thegm-Gabriel/instrumentacao-ElectricCarUFSM/hardware/kicad/README.md

# Projetos KiCad

Pasta reservada para esquemas elétricos, placas e bibliotecas locais do KiCad.
