thegm-Gabriel/instrumentacao-ElectricCarUFSM/hardware/folhas-de-dados/README.md

# Folhas de dados

Pasta reservada para folhas de dados dos componentes usados na instrumentação.
Registre a origem e a revisão de cada documento ao adicioná-lo.
