thegm-Gabriel/instrumentacao-ElectricCarUFSM/firmware/compartilhado/telemetria/README.md

# Telemetria compartilhada

`dados_telemetria_veiculo.h` descreve os dados da aplicação em unidades de engenharia.
O serviço do mestre converte esses valores para o formato binário compacto definido
em `protocolos`.
