thegm-Gabriel/instrumentacao-ElectricCarUFSM/firmware/compartilhado/comum/README.md

# Código comum

Espaço reservado para utilitários pequenos e independentes do hardware. Uma função só
deve ser movida para cá quando for realmente usada por mais de um firmware.
