thegm-Gabriel/instrumentacao-ElectricCarUFSM/.tmp_video_review/chrome_frame.png

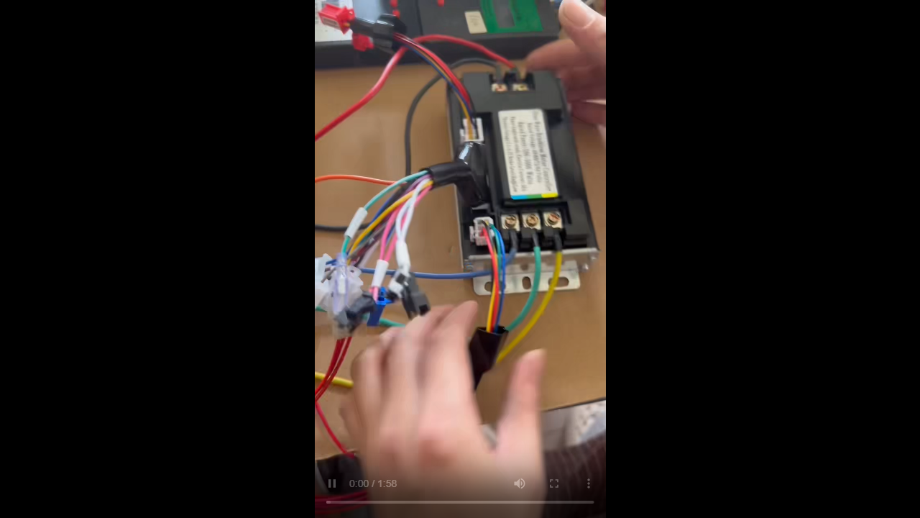
.tmp_video_review/chrome_frame.png
