thegm-Gabriel/instrumentacao-ElectricCarUFSM/.tmp_video_review/f_000.jpg

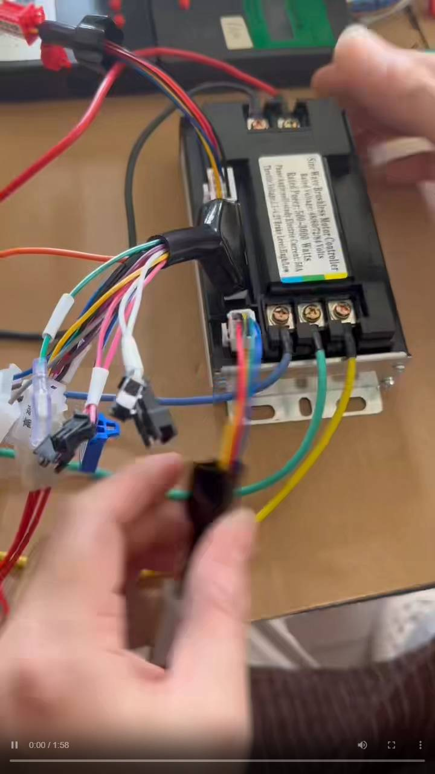
.tmp_video_review/f_000.jpg
