thegm-Gabriel/instrumentacao-ElectricCarUFSM/.tmp_video_review/f_002.jpg

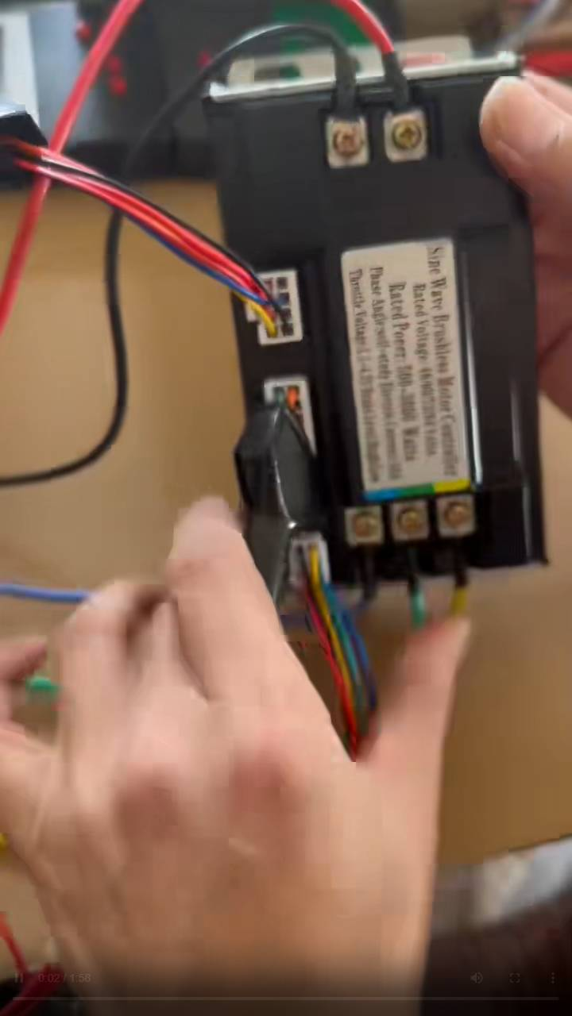
.tmp_video_review/f_002.jpg
