thegm-Gabriel/instrumentacao-ElectricCarUFSM/.tmp_video_review/f_004.jpg

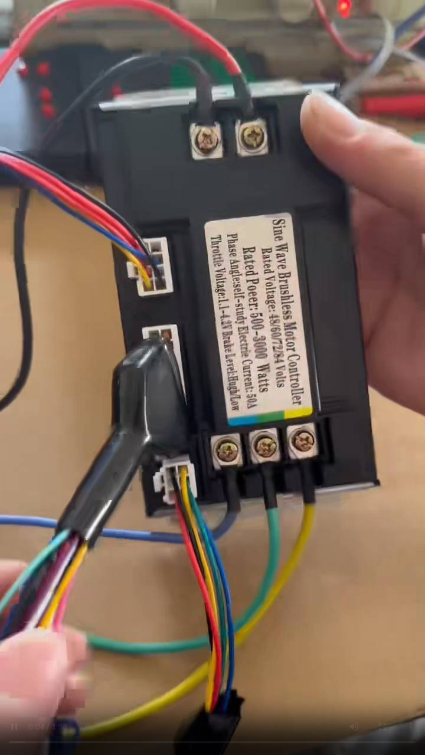
.tmp_video_review/f_004.jpg
