thegm-Gabriel/instrumentacao-ElectricCarUFSM/.tmp_video_review/f_006.jpg

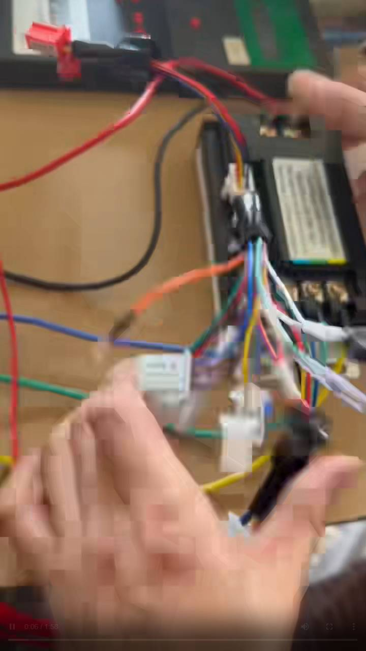
.tmp_video_review/f_006.jpg
