thegm-Gabriel/instrumentacao-ElectricCarUFSM/.tmp_video_review/f_008.jpg

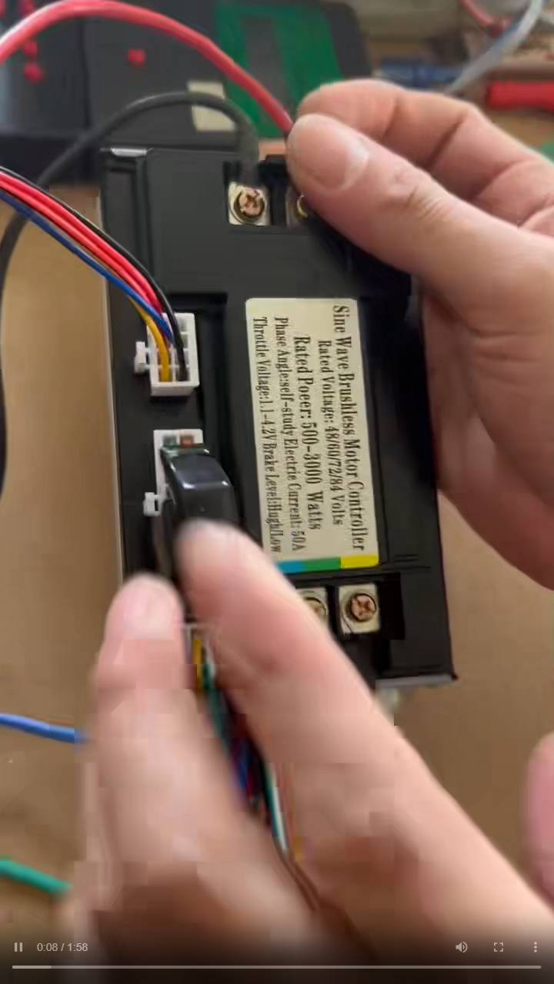
.tmp_video_review/f_008.jpg
