thegm-Gabriel/instrumentacao-ElectricCarUFSM/.tmp_video_review/f_010.jpg

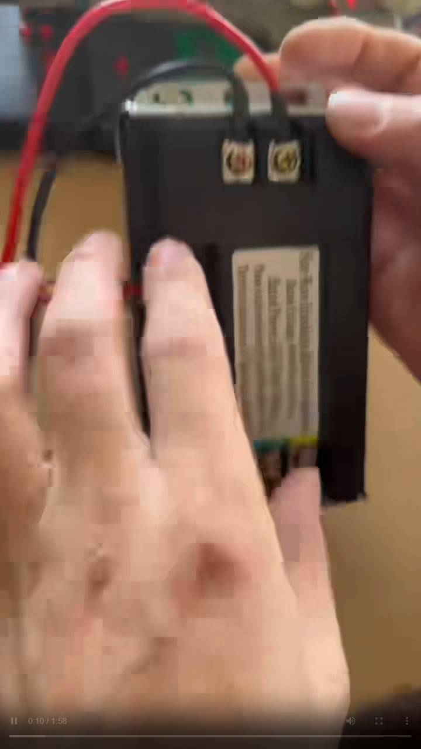
.tmp_video_review/f_010.jpg
