thegm-Gabriel/instrumentacao-ElectricCarUFSM/.tmp_video_review/f_012.jpg

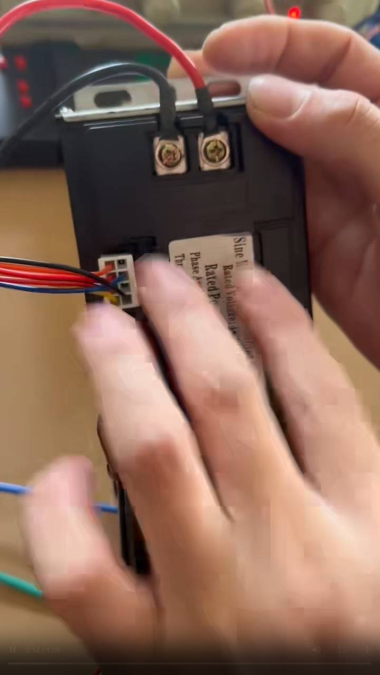
.tmp_video_review/f_012.jpg
