thegm-Gabriel/instrumentacao-ElectricCarUFSM/.tmp_video_review/f_014.jpg

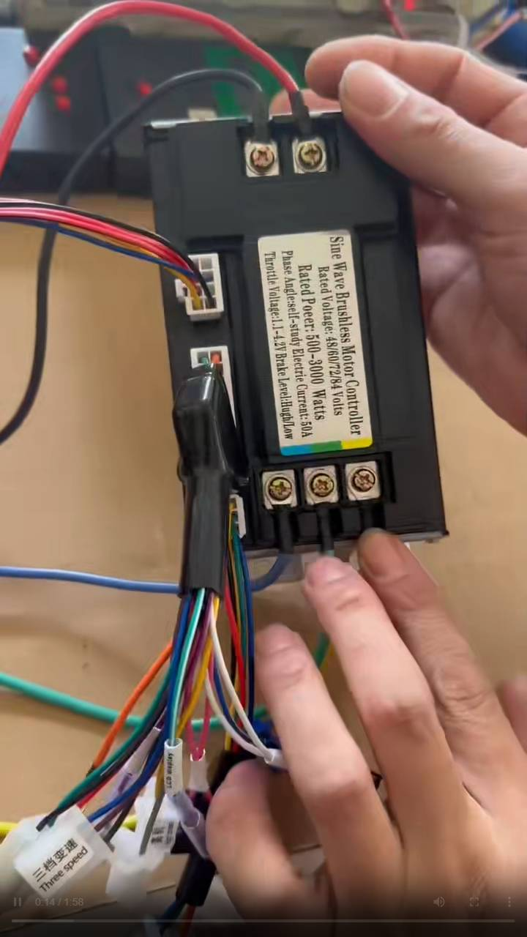
.tmp_video_review/f_014.jpg
