thegm-Gabriel/instrumentacao-ElectricCarUFSM/.tmp_video_review/f_016.jpg

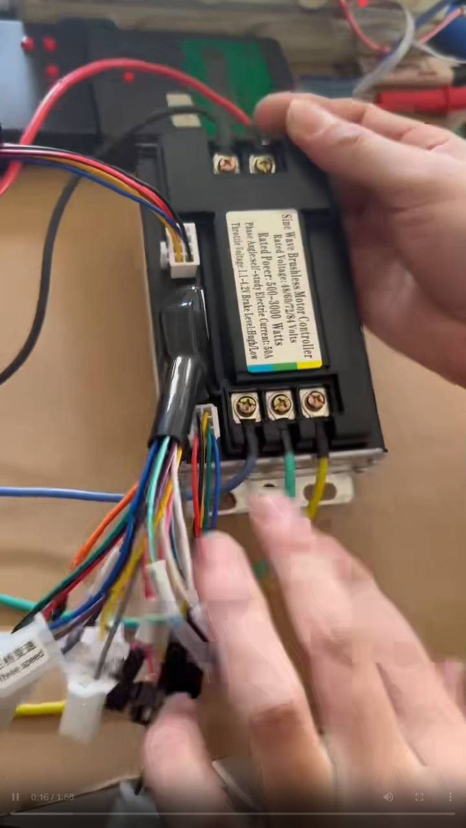
.tmp_video_review/f_016.jpg
