thegm-Gabriel/instrumentacao-ElectricCarUFSM/.tmp_video_review/f_018.jpg

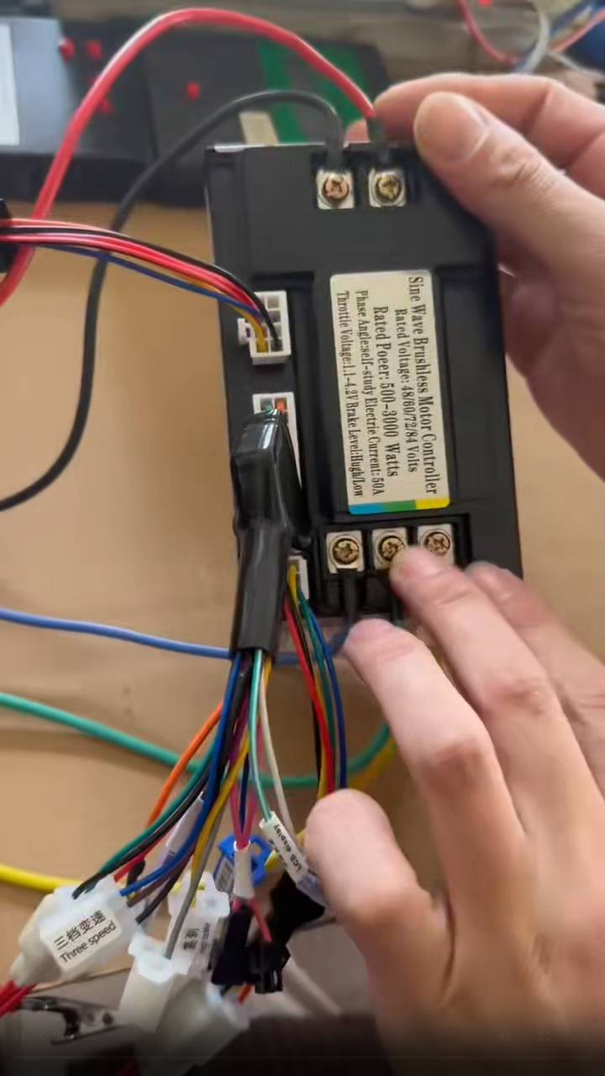
.tmp_video_review/f_018.jpg
