thegm-Gabriel/instrumentacao-ElectricCarUFSM/.tmp_video_review/f_020.jpg

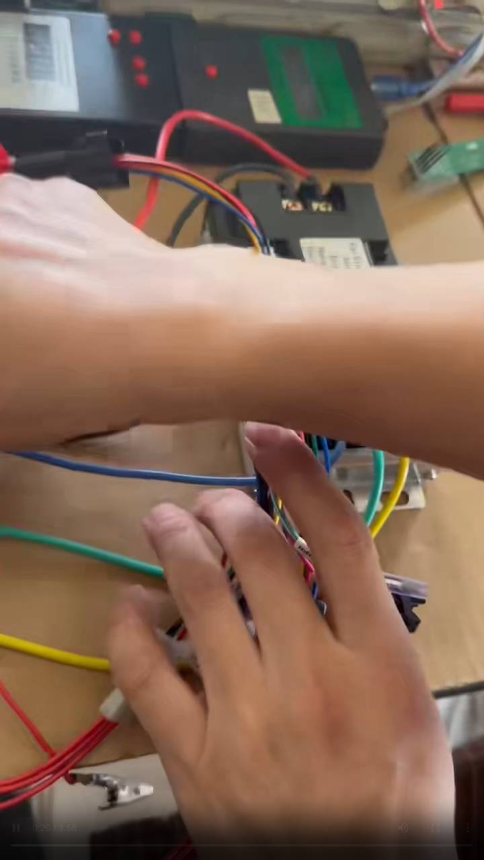
.tmp_video_review/f_020.jpg
