thegm-Gabriel/instrumentacao-ElectricCarUFSM/.tmp_video_review/f_022.jpg

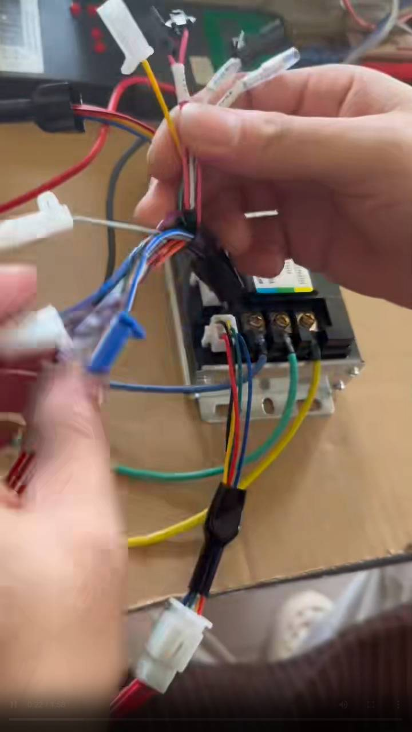
.tmp_video_review/f_022.jpg
