thegm-Gabriel/instrumentacao-ElectricCarUFSM/.tmp_video_review/f_024.jpg

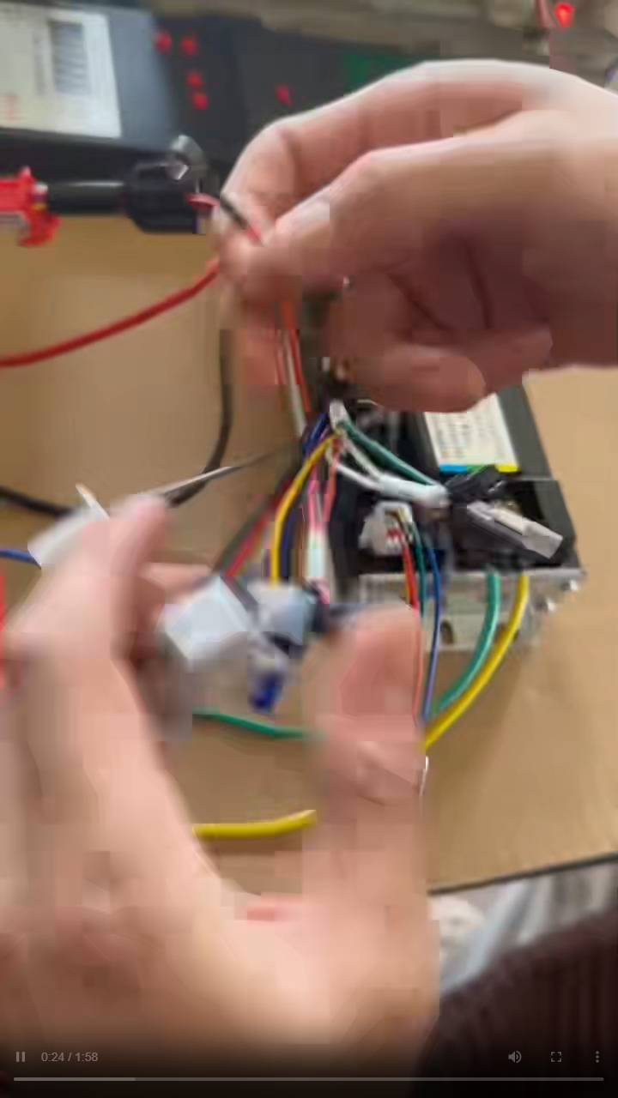
.tmp_video_review/f_024.jpg
