thegm-Gabriel/instrumentacao-ElectricCarUFSM/.tmp_video_review/f_026.jpg

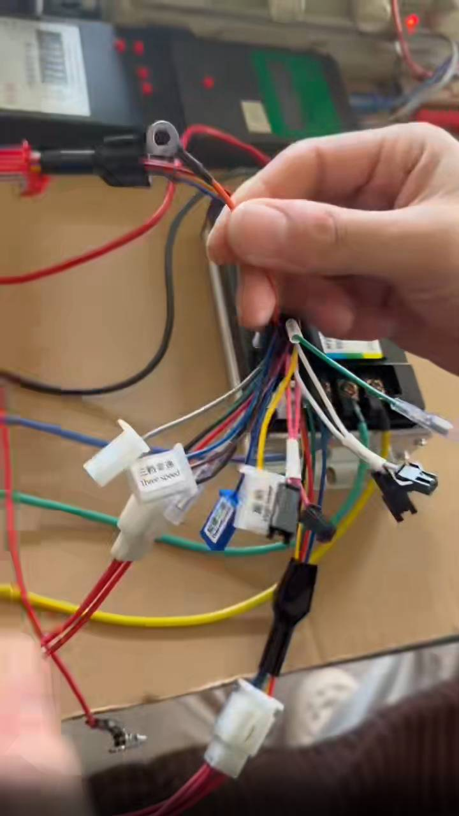
.tmp_video_review/f_026.jpg
