thegm-Gabriel/instrumentacao-ElectricCarUFSM/.tmp_video_review/f_028.jpg

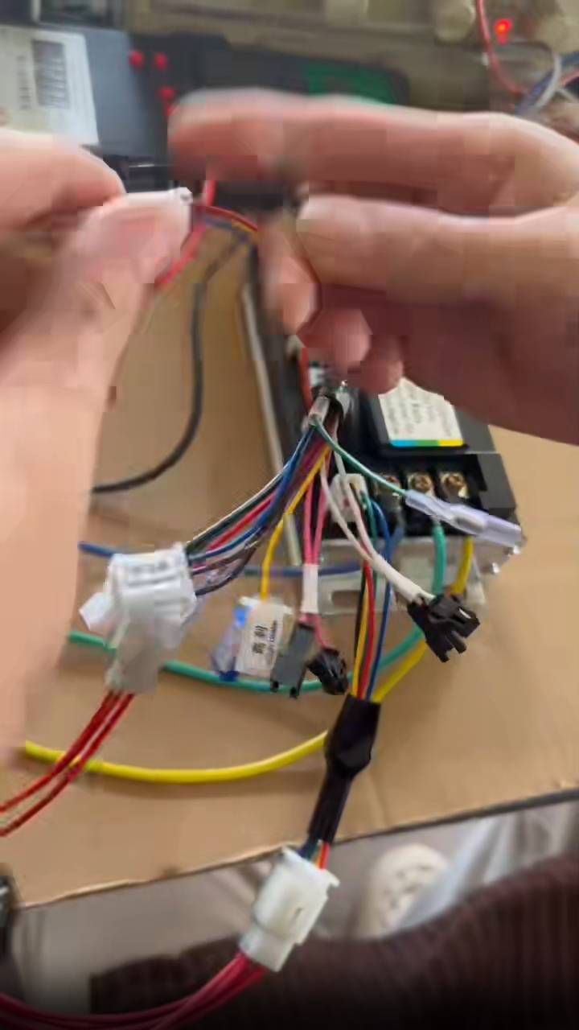
.tmp_video_review/f_028.jpg
