thegm-Gabriel/instrumentacao-ElectricCarUFSM/.tmp_video_review/f_030.jpg

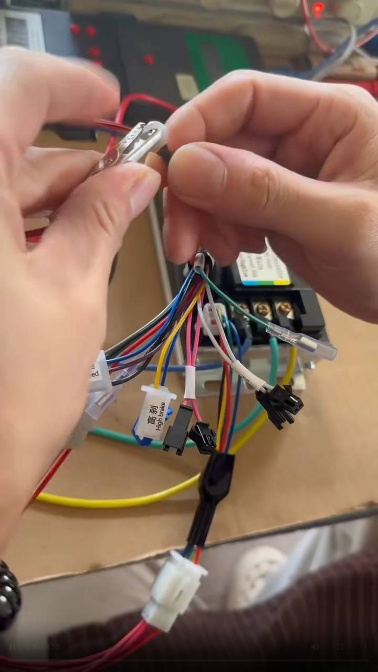
.tmp_video_review/f_030.jpg
