thegm-Gabriel/instrumentacao-ElectricCarUFSM/.tmp_video_review/f_032.jpg

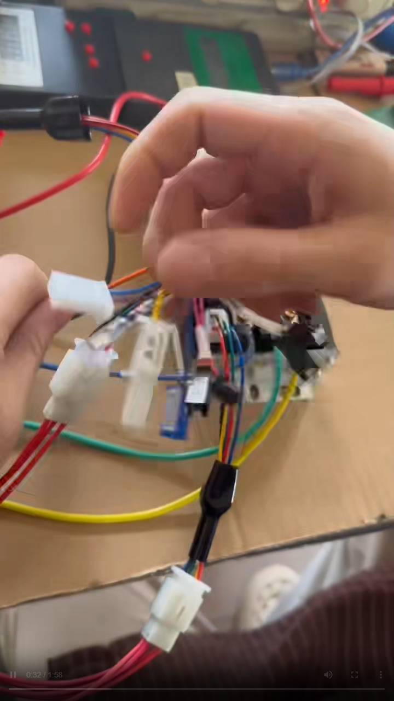
.tmp_video_review/f_032.jpg
