thegm-Gabriel/instrumentacao-ElectricCarUFSM/.tmp_video_review/f_034.jpg

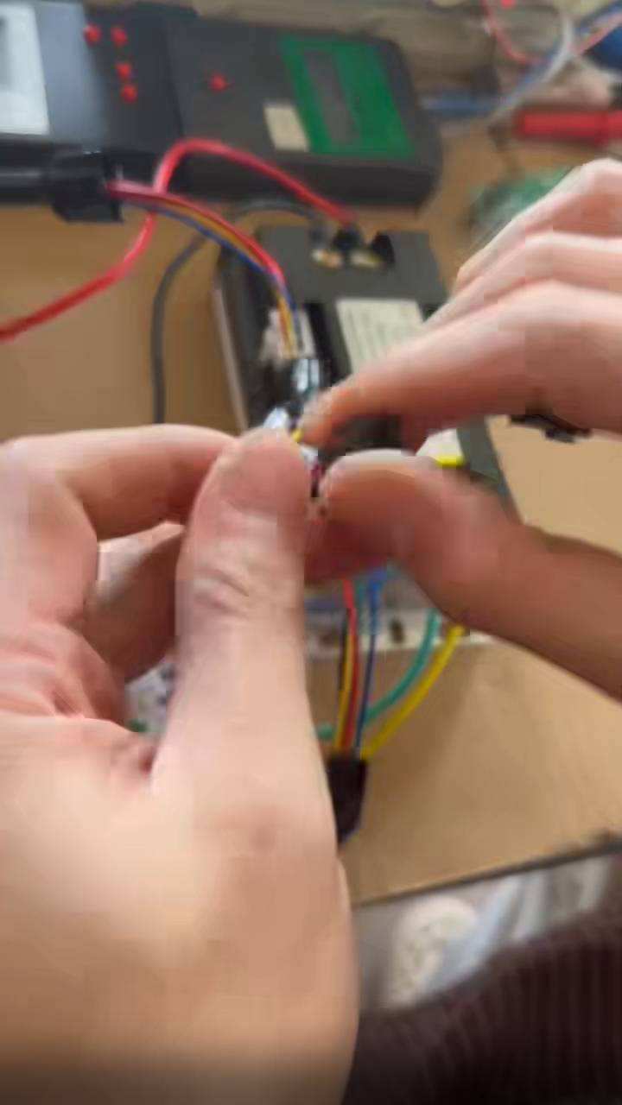
.tmp_video_review/f_034.jpg
