thegm-Gabriel/instrumentacao-ElectricCarUFSM/.tmp_video_review/f_036.jpg

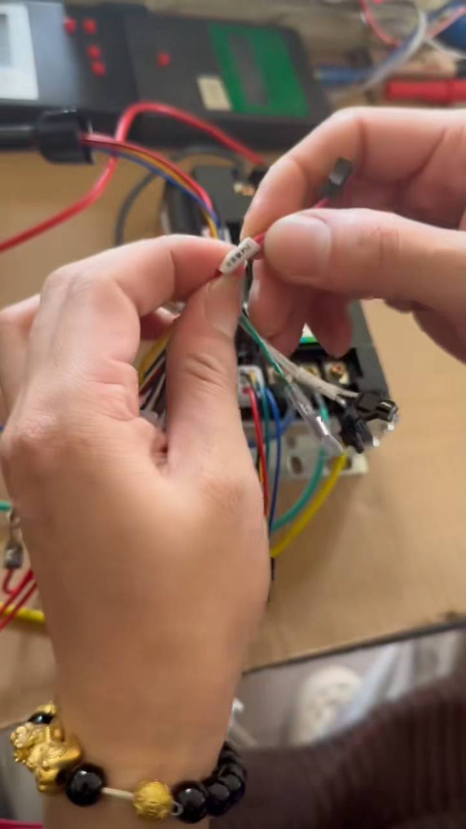
.tmp_video_review/f_036.jpg
