thegm-Gabriel/instrumentacao-ElectricCarUFSM/.tmp_video_review/f_038.jpg

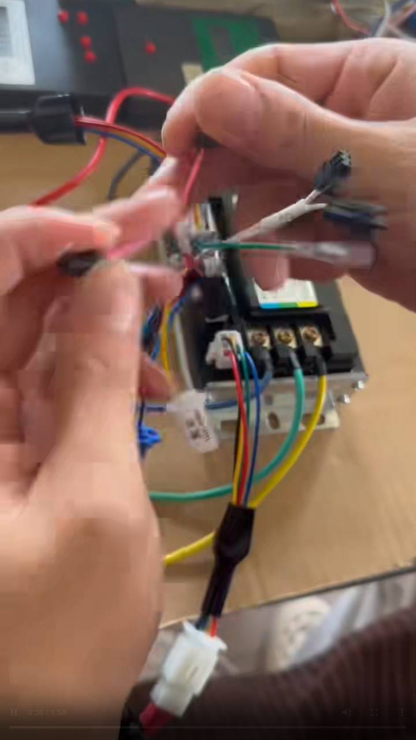
.tmp_video_review/f_038.jpg
