thegm-Gabriel/instrumentacao-ElectricCarUFSM/.tmp_video_review/f_040.jpg

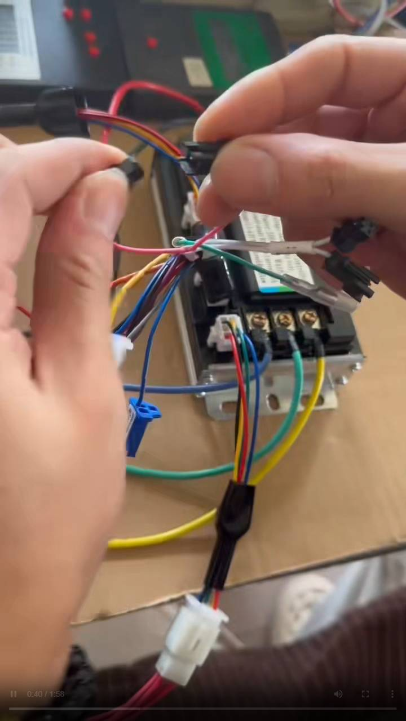
.tmp_video_review/f_040.jpg
