thegm-Gabriel/instrumentacao-ElectricCarUFSM/.tmp_video_review/f_042.jpg

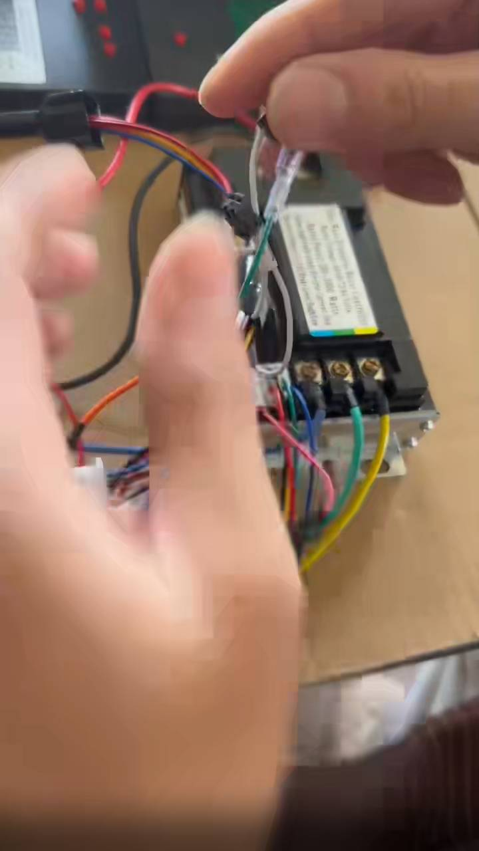
.tmp_video_review/f_042.jpg
