thegm-Gabriel/instrumentacao-ElectricCarUFSM/.tmp_video_review/f_044.jpg

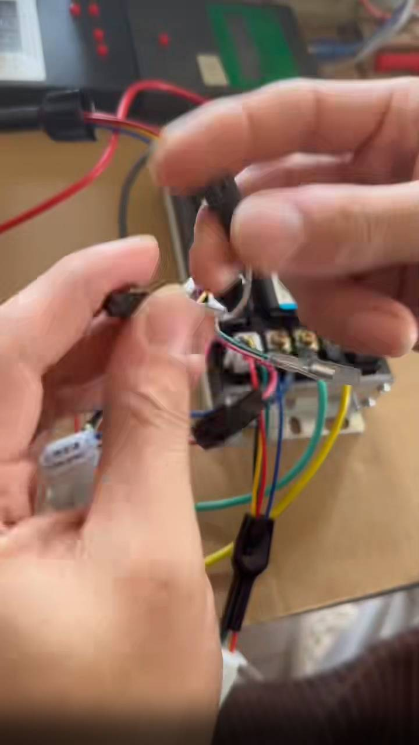
.tmp_video_review/f_044.jpg
