thegm-Gabriel/instrumentacao-ElectricCarUFSM/.tmp_video_review/f_046.jpg

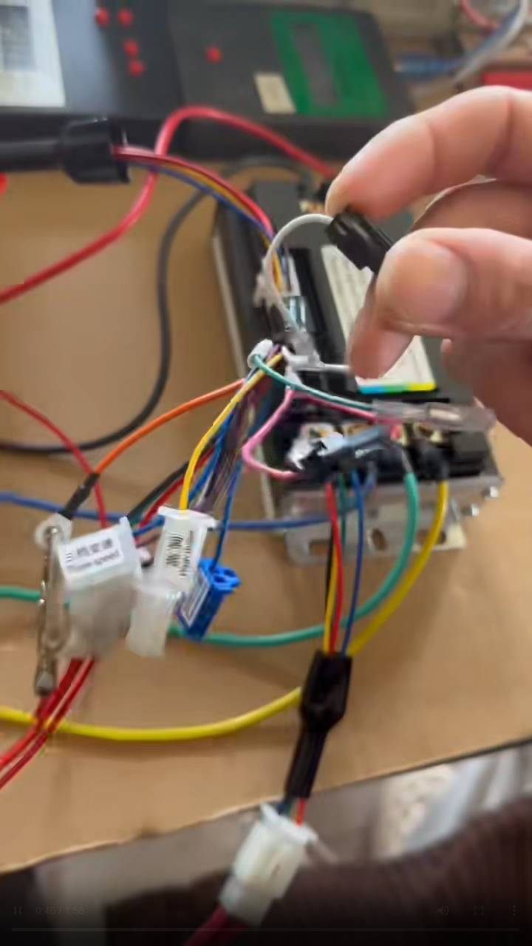
.tmp_video_review/f_046.jpg
