thegm-Gabriel/instrumentacao-ElectricCarUFSM/.tmp_video_review/f_048.jpg

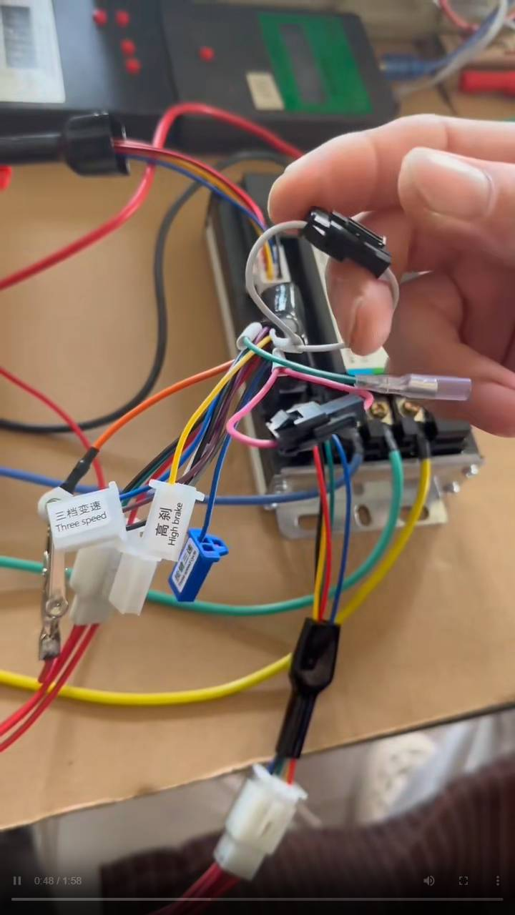
.tmp_video_review/f_048.jpg
