thegm-Gabriel/instrumentacao-ElectricCarUFSM/.tmp_video_review/f_050.jpg

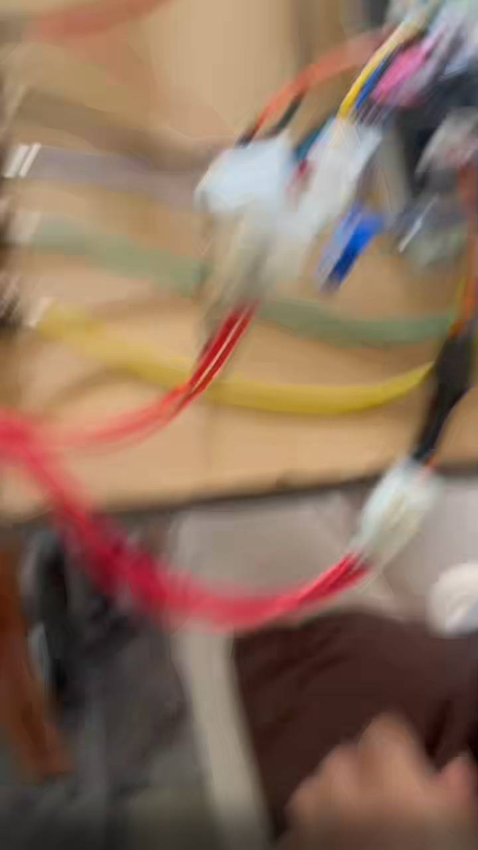
.tmp_video_review/f_050.jpg
