thegm-Gabriel/instrumentacao-ElectricCarUFSM/.tmp_video_review/f_052.jpg

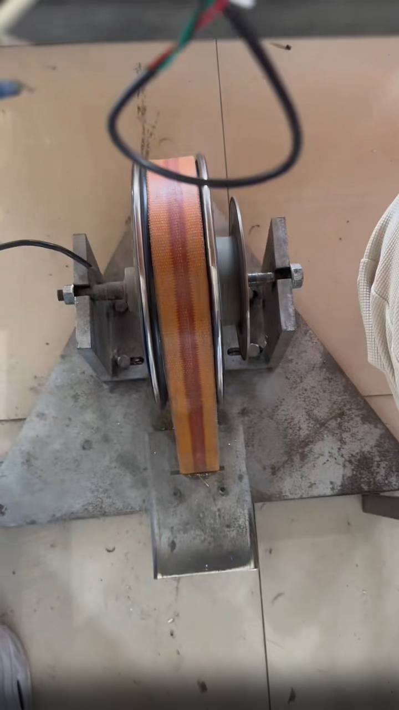
.tmp_video_review/f_052.jpg
