thegm-Gabriel/instrumentacao-ElectricCarUFSM/.tmp_video_review/f_054.jpg

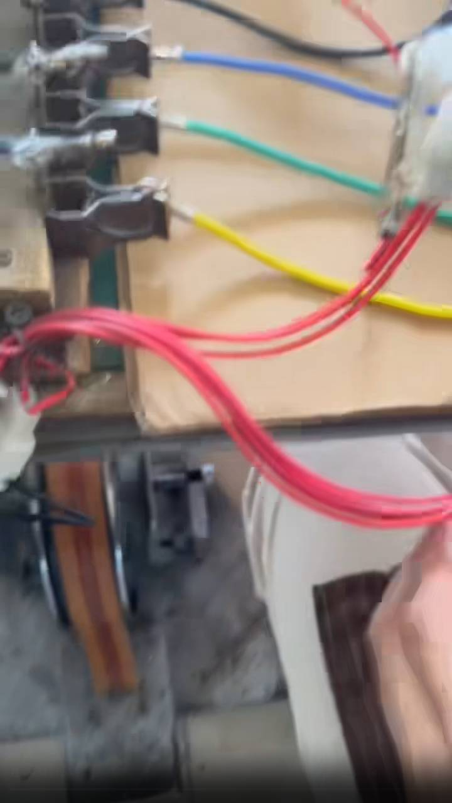
.tmp_video_review/f_054.jpg
