thegm-Gabriel/instrumentacao-ElectricCarUFSM/.tmp_video_review/f_056.jpg

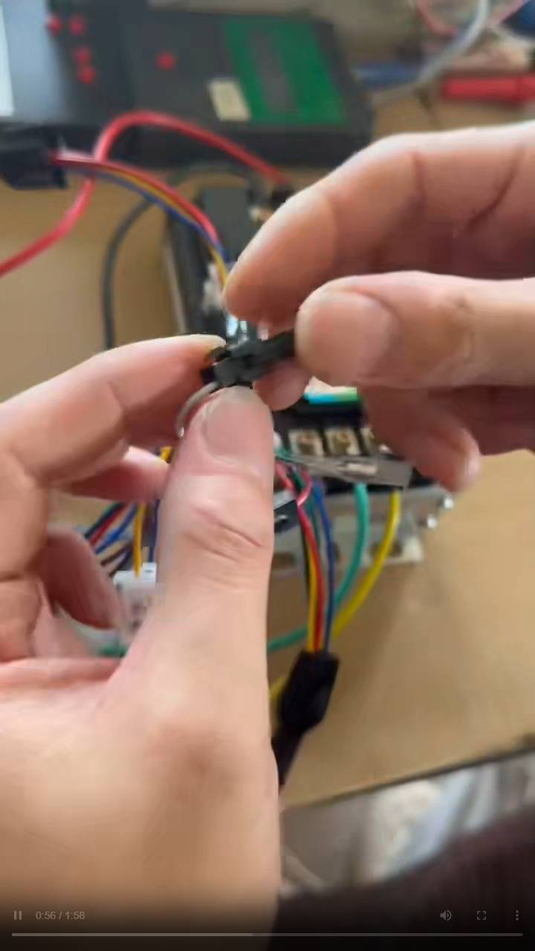
.tmp_video_review/f_056.jpg
