thegm-Gabriel/instrumentacao-ElectricCarUFSM/.tmp_video_review/f_058.jpg

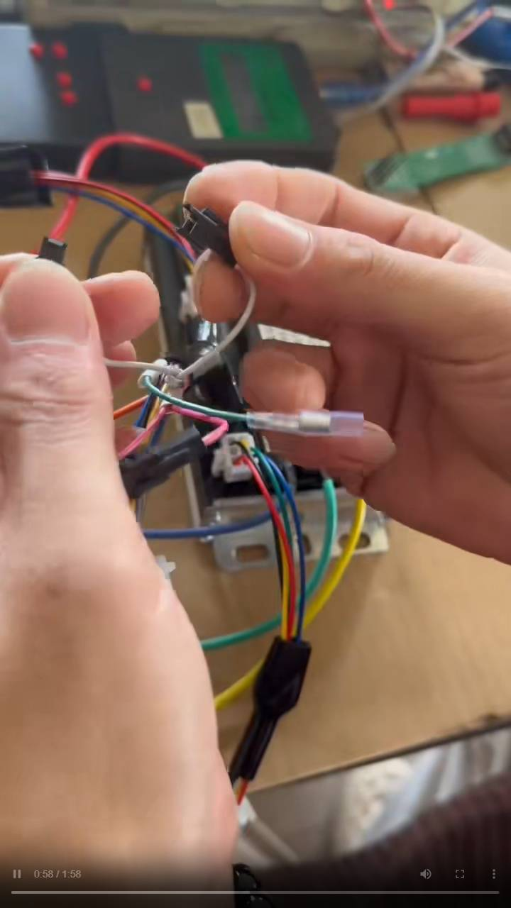
.tmp_video_review/f_058.jpg
