thegm-Gabriel/instrumentacao-ElectricCarUFSM/.tmp_video_review/f_060.jpg

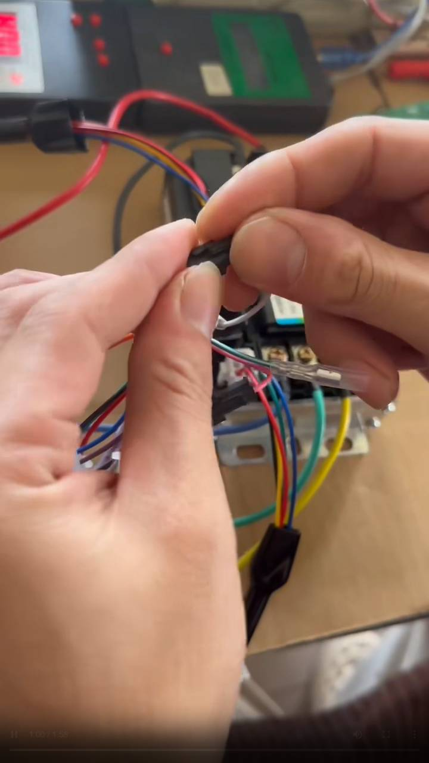
.tmp_video_review/f_060.jpg
