thegm-Gabriel/instrumentacao-ElectricCarUFSM/.tmp_video_review/f_062.jpg

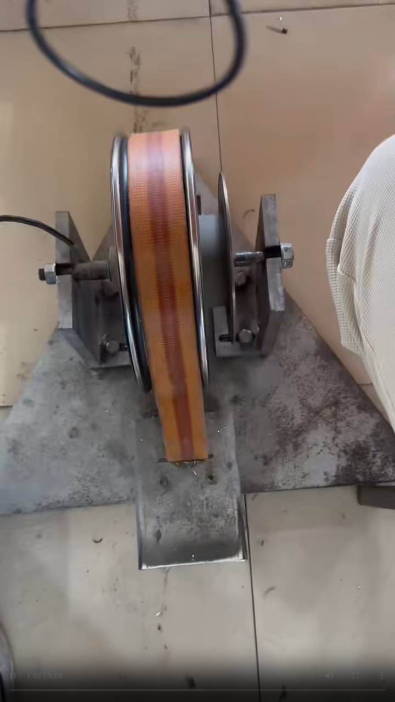
.tmp_video_review/f_062.jpg
