thegm-Gabriel/instrumentacao-ElectricCarUFSM/.tmp_video_review/f_064.jpg

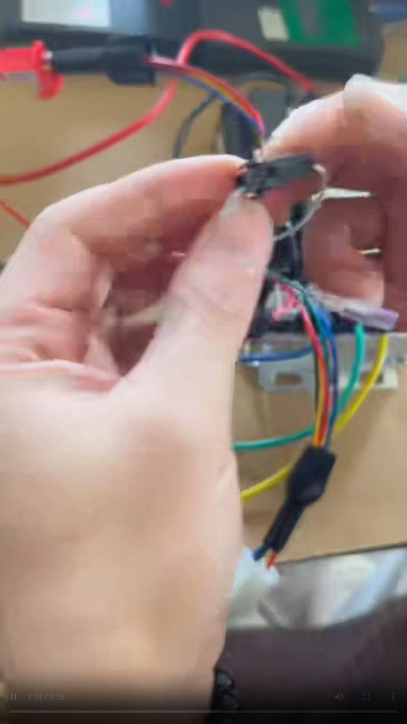
.tmp_video_review/f_064.jpg
