thegm-Gabriel/instrumentacao-ElectricCarUFSM/.tmp_video_review/f_066.jpg

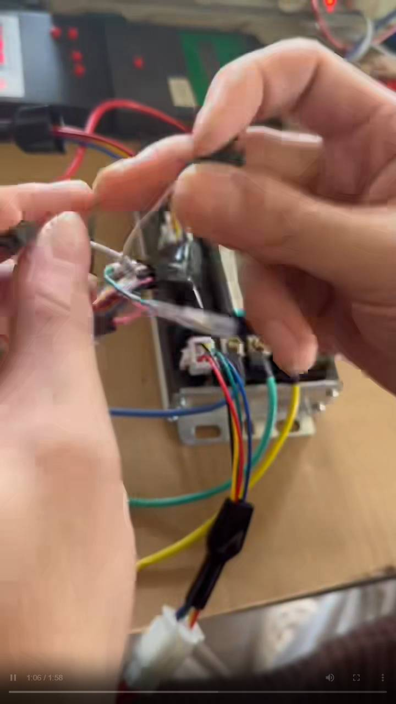
.tmp_video_review/f_066.jpg
