thegm-Gabriel/instrumentacao-ElectricCarUFSM/.tmp_video_review/f_068.jpg

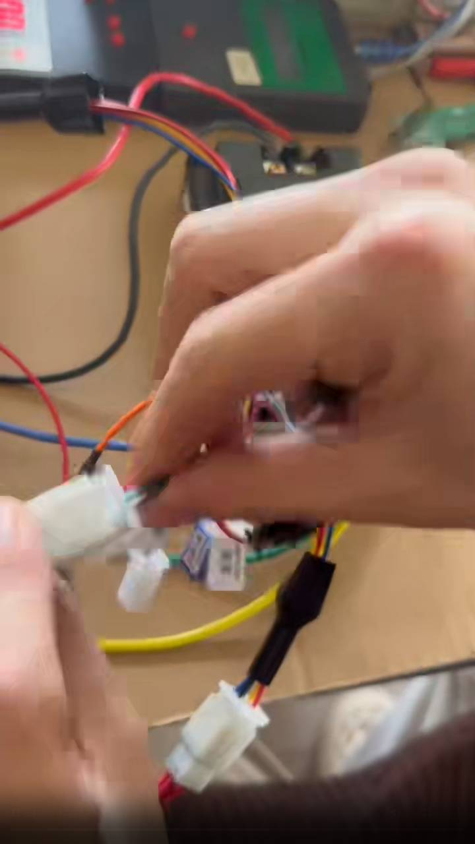
.tmp_video_review/f_068.jpg
