thegm-Gabriel/instrumentacao-ElectricCarUFSM/.tmp_video_review/f_070.jpg

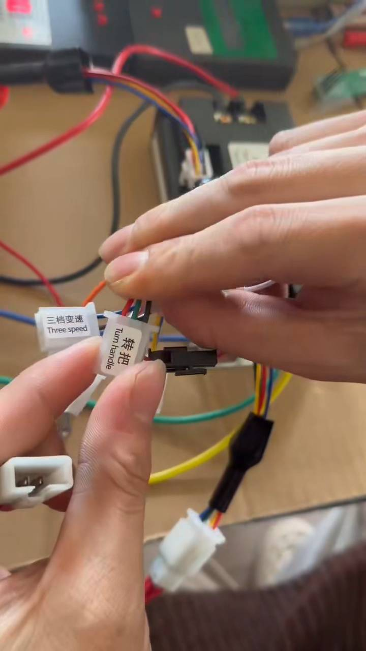
.tmp_video_review/f_070.jpg
