thegm-Gabriel/instrumentacao-ElectricCarUFSM/.tmp_video_review/f_072.jpg

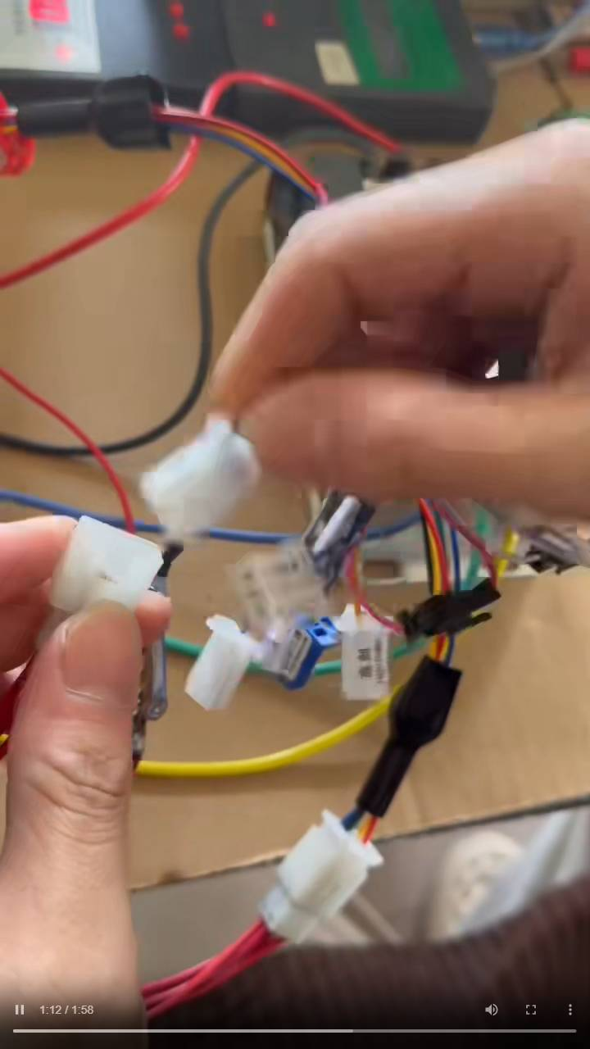
.tmp_video_review/f_072.jpg
