thegm-Gabriel/instrumentacao-ElectricCarUFSM/.tmp_video_review/f_074.jpg

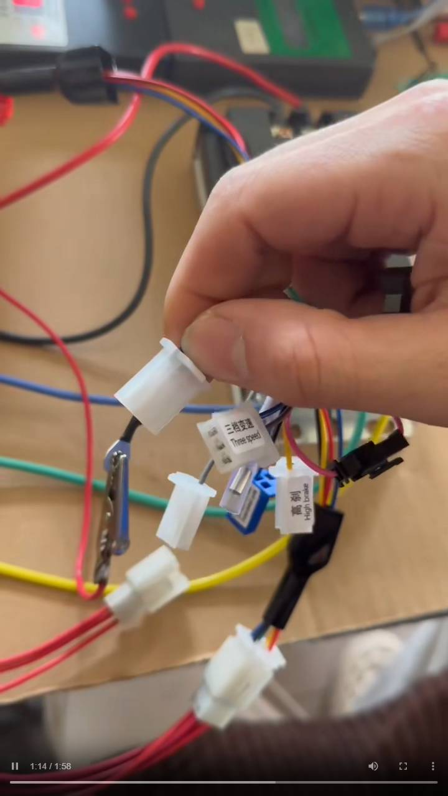
.tmp_video_review/f_074.jpg
