thegm-Gabriel/instrumentacao-ElectricCarUFSM/.tmp_video_review/f_076.jpg

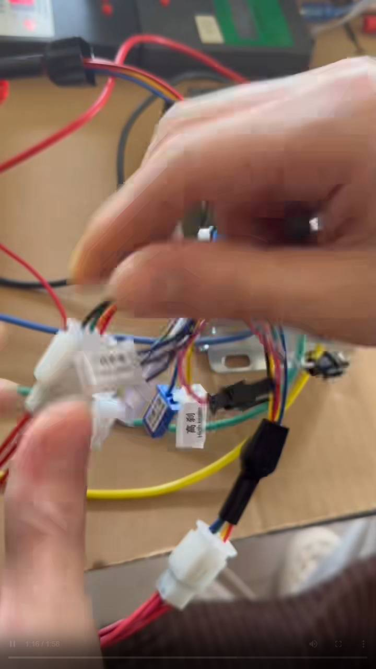
.tmp_video_review/f_076.jpg
