thegm-Gabriel/instrumentacao-ElectricCarUFSM/.tmp_video_review/f_078.jpg

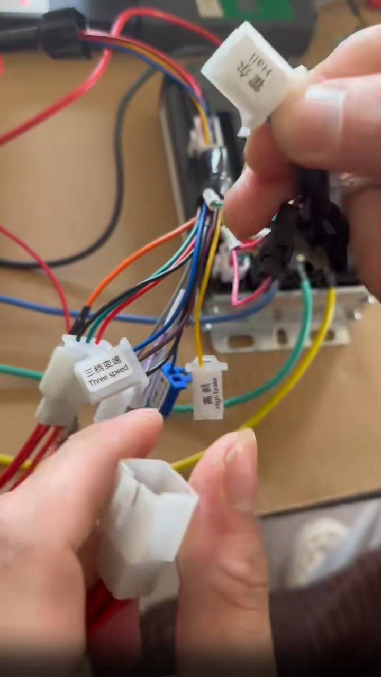
.tmp_video_review/f_078.jpg
