thegm-Gabriel/instrumentacao-ElectricCarUFSM/.tmp_video_review/f_080.jpg

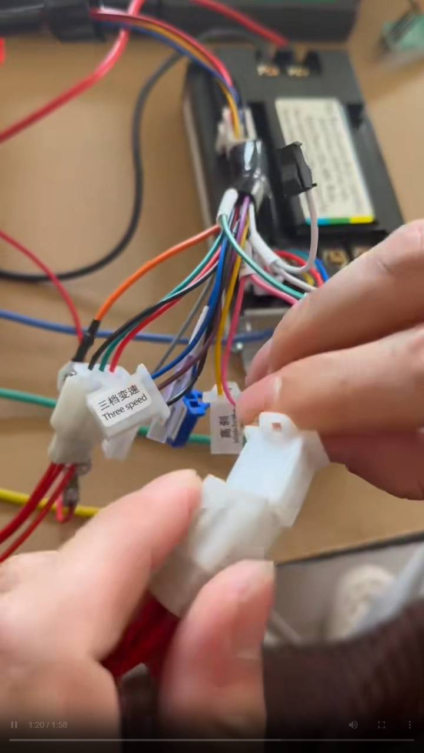
.tmp_video_review/f_080.jpg
