thegm-Gabriel/instrumentacao-ElectricCarUFSM/.tmp_video_review/f_082.jpg

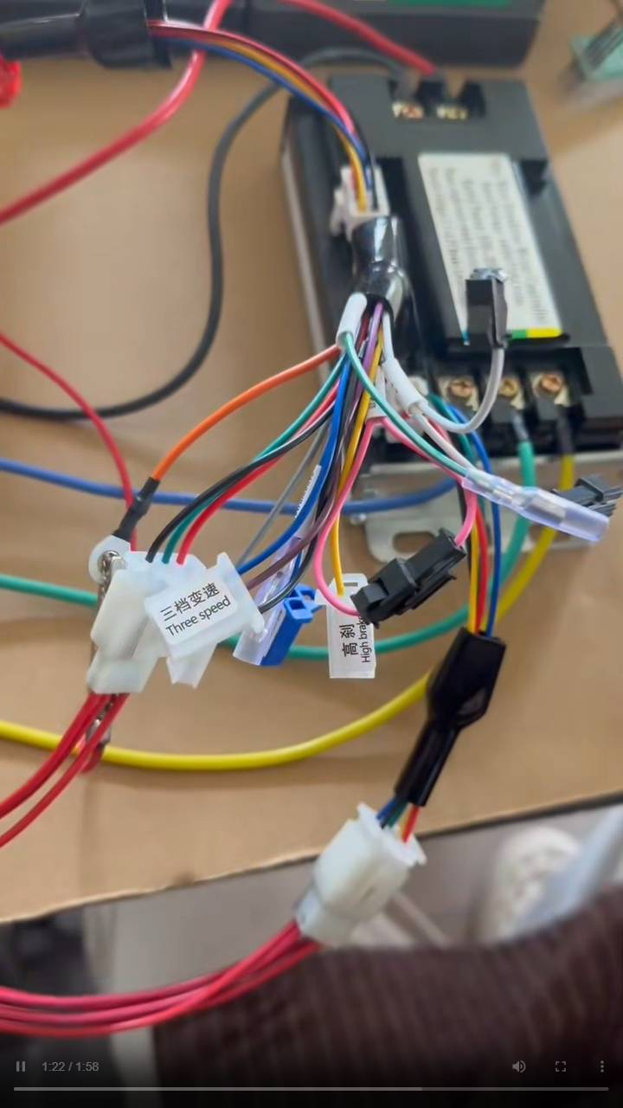
.tmp_video_review/f_082.jpg
