thegm-Gabriel/instrumentacao-ElectricCarUFSM/.tmp_video_review/f_084.jpg

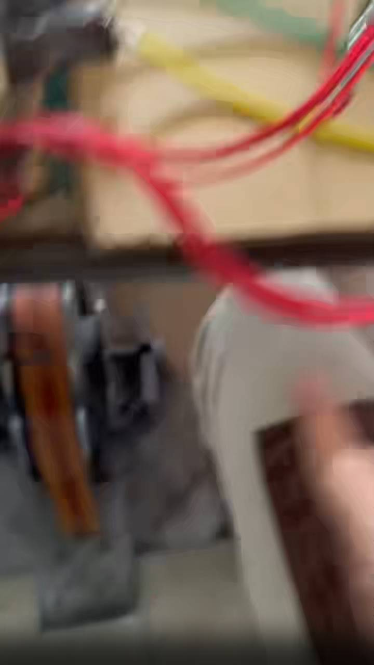
.tmp_video_review/f_084.jpg
