thegm-Gabriel/instrumentacao-ElectricCarUFSM/.tmp_video_review/f_086.jpg

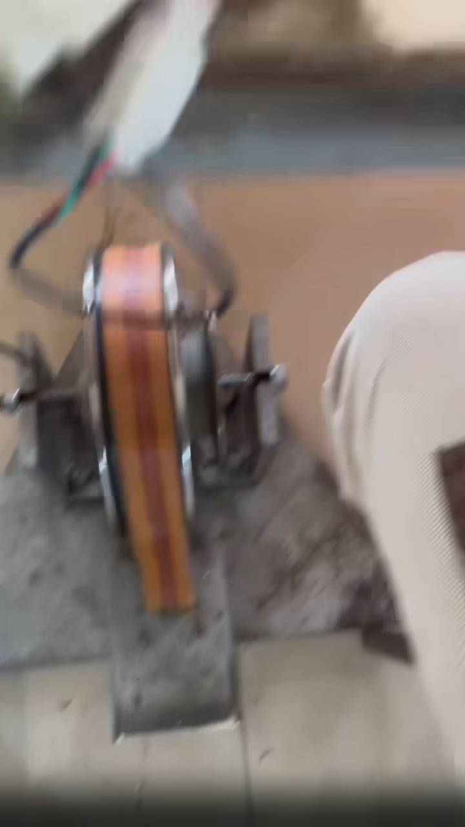
.tmp_video_review/f_086.jpg
