thegm-Gabriel/instrumentacao-ElectricCarUFSM/.tmp_video_review/f_088.jpg

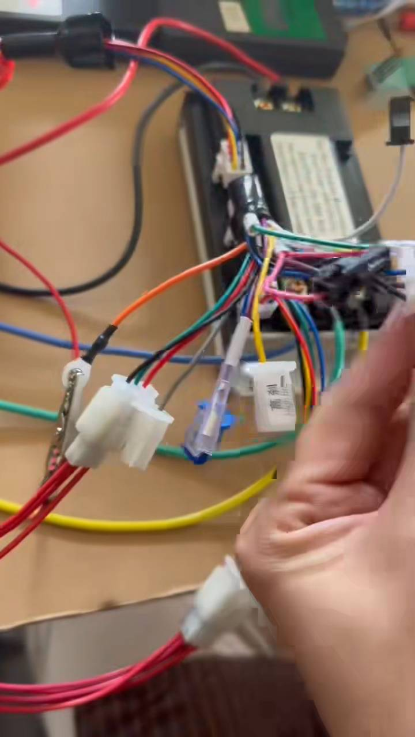
.tmp_video_review/f_088.jpg
