thegm-Gabriel/instrumentacao-ElectricCarUFSM/.tmp_video_review/f_090.jpg

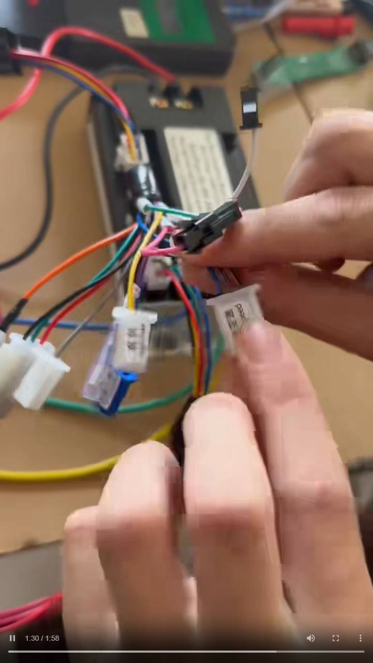
.tmp_video_review/f_090.jpg
