thegm-Gabriel/instrumentacao-ElectricCarUFSM/.tmp_video_review/f_092.jpg

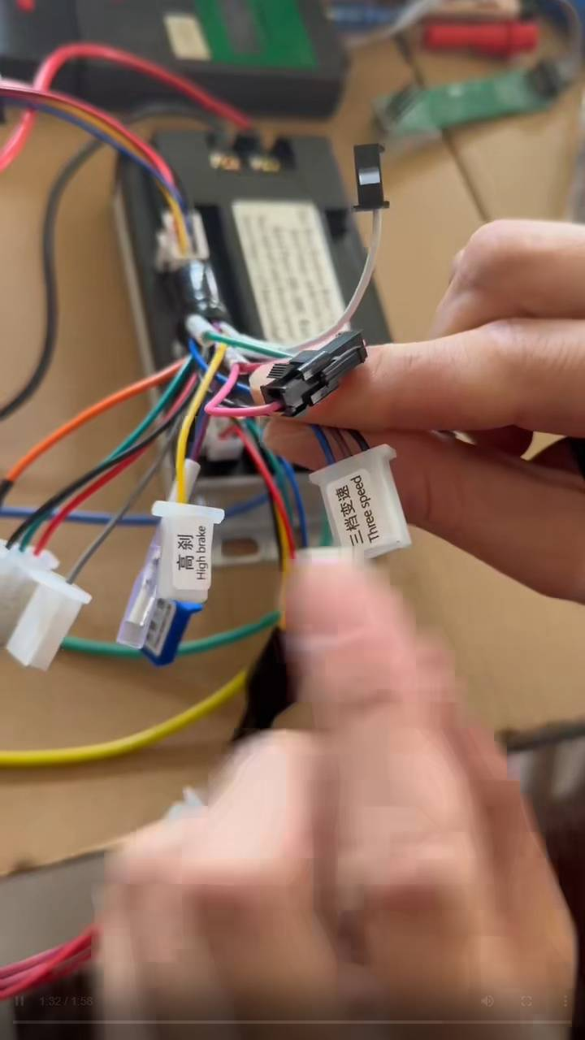
.tmp_video_review/f_092.jpg
