thegm-Gabriel/instrumentacao-ElectricCarUFSM/.tmp_video_review/f_094.jpg

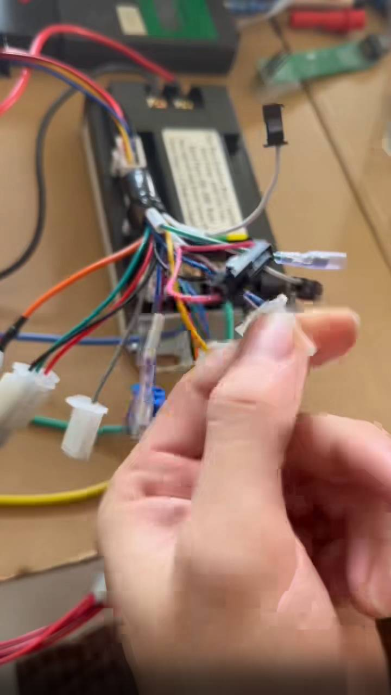
.tmp_video_review/f_094.jpg
