thegm-Gabriel/instrumentacao-ElectricCarUFSM/.tmp_video_review/f_096.jpg

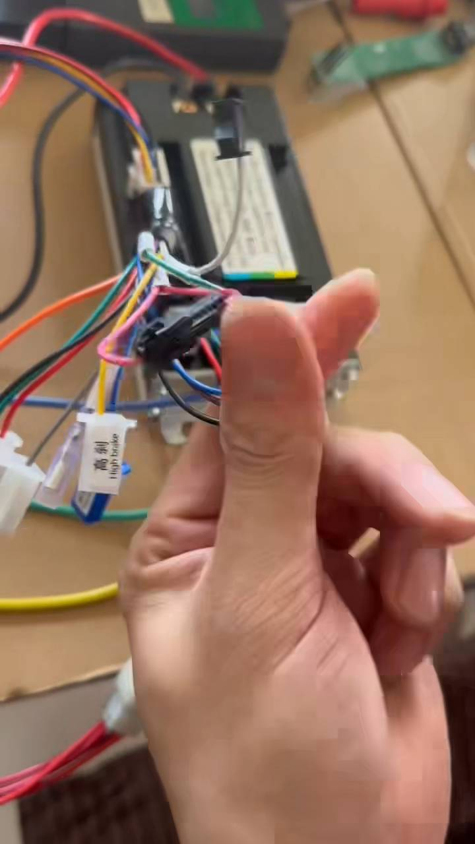
.tmp_video_review/f_096.jpg
