thegm-Gabriel/instrumentacao-ElectricCarUFSM/.tmp_video_review/f_098.jpg

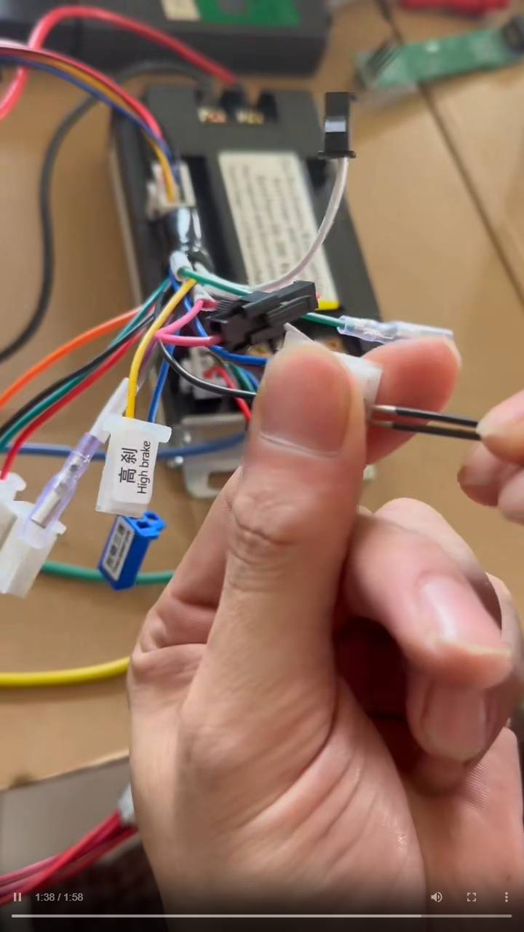
.tmp_video_review/f_098.jpg
