thegm-Gabriel/instrumentacao-ElectricCarUFSM/.tmp_video_review/f_100.jpg

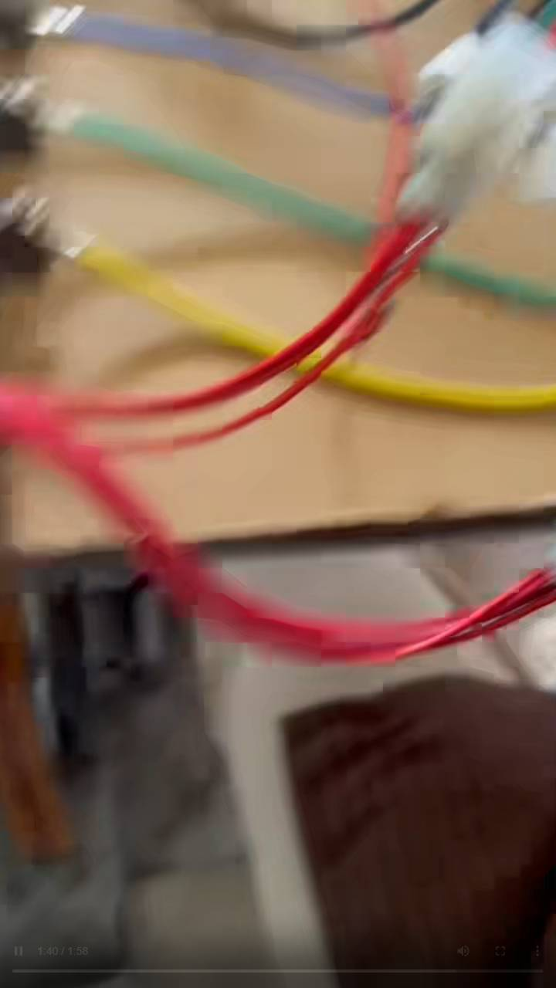
.tmp_video_review/f_100.jpg
