thegm-Gabriel/instrumentacao-ElectricCarUFSM/.tmp_video_review/f_102.jpg

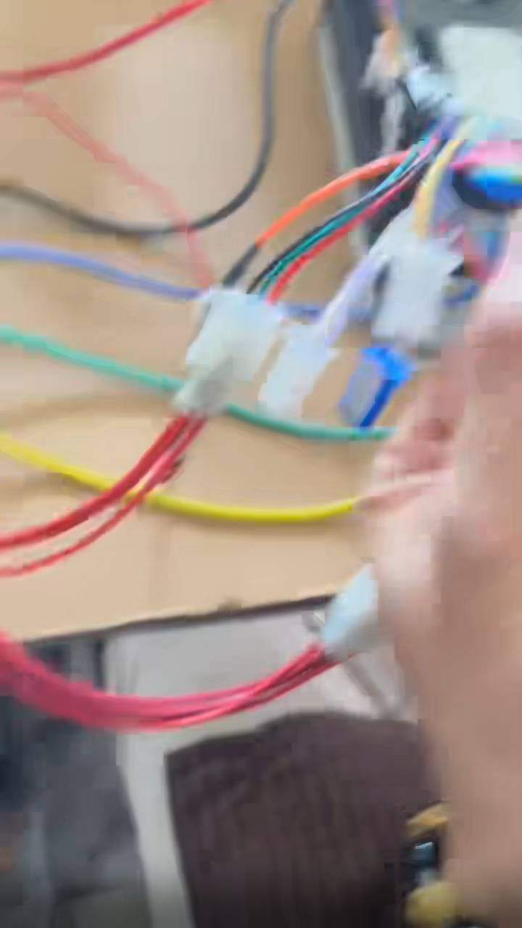
.tmp_video_review/f_102.jpg
