thegm-Gabriel/instrumentacao-ElectricCarUFSM/.tmp_video_review/f_104.jpg

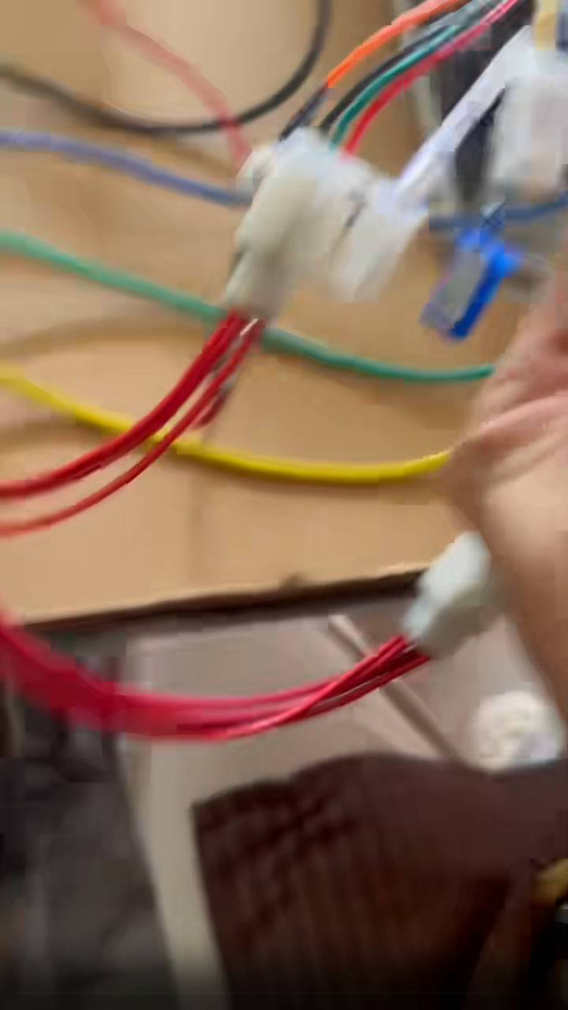
.tmp_video_review/f_104.jpg
