thegm-Gabriel/instrumentacao-ElectricCarUFSM/.tmp_video_review/f_106.jpg

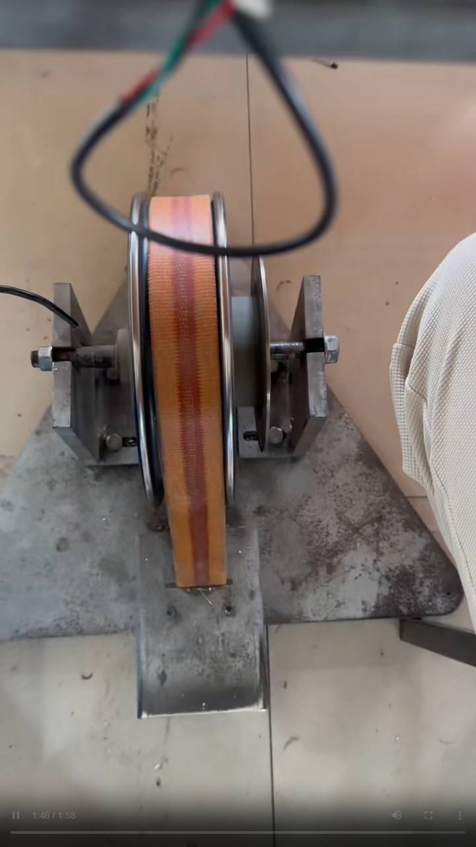
.tmp_video_review/f_106.jpg
