thegm-Gabriel/instrumentacao-ElectricCarUFSM/.tmp_video_review/f_108.jpg

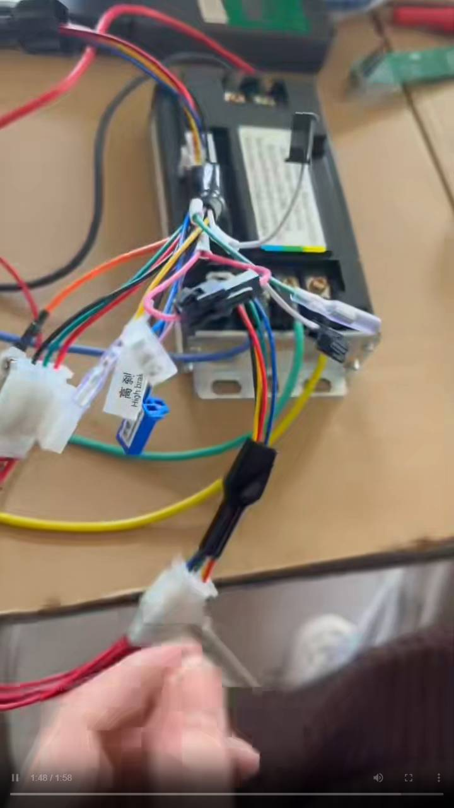
.tmp_video_review/f_108.jpg
