thegm-Gabriel/instrumentacao-ElectricCarUFSM/.tmp_video_review/f_110.jpg

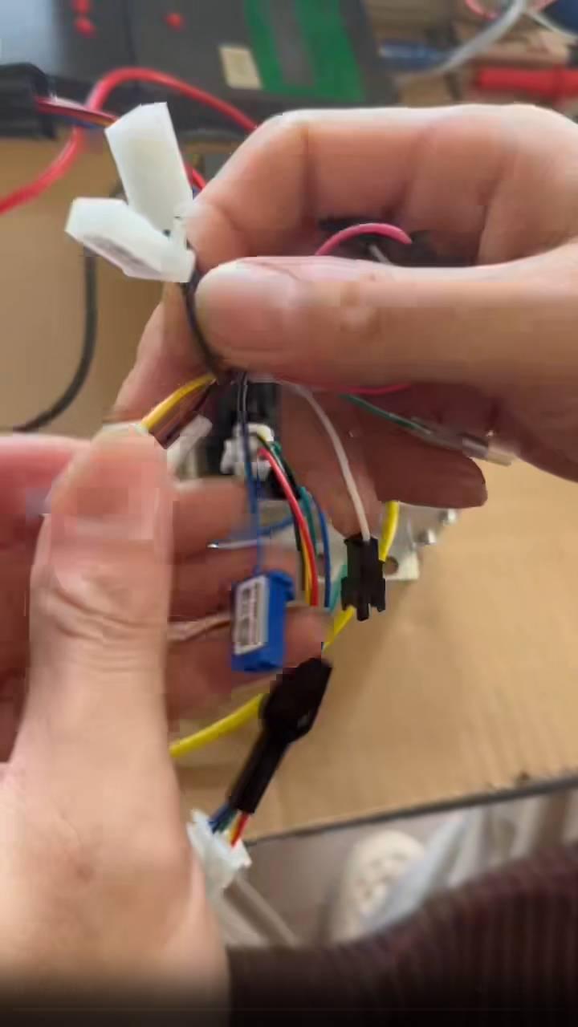
.tmp_video_review/f_110.jpg
