thegm-Gabriel/instrumentacao-ElectricCarUFSM/.tmp_video_review/f_112.jpg

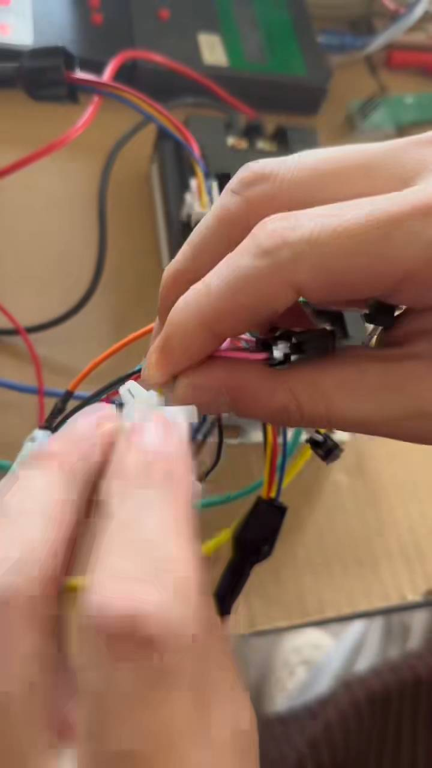
.tmp_video_review/f_112.jpg
