thegm-Gabriel/instrumentacao-ElectricCarUFSM/.tmp_video_review/f_114.jpg

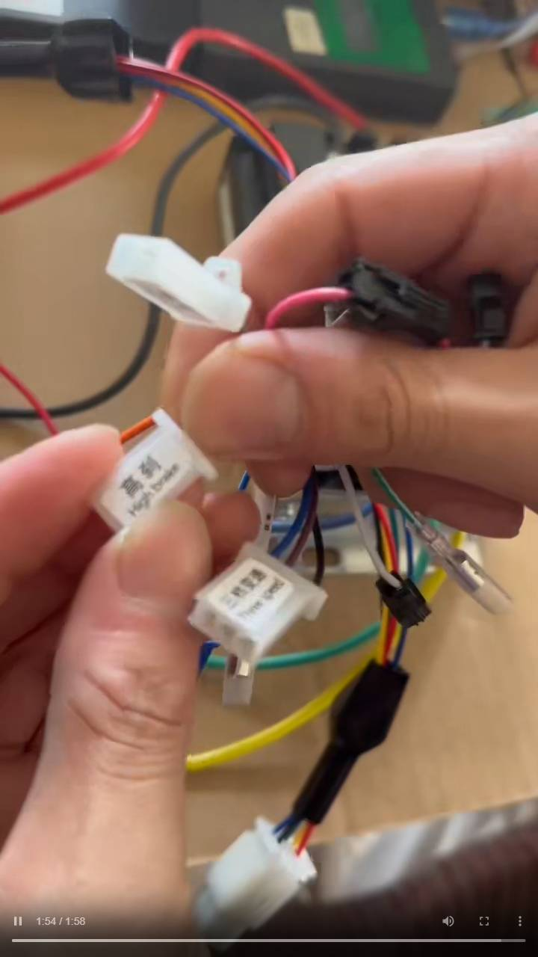
.tmp_video_review/f_114.jpg
