thegm-Gabriel/instrumentacao-ElectricCarUFSM/.tmp_video_review/f_116.jpg

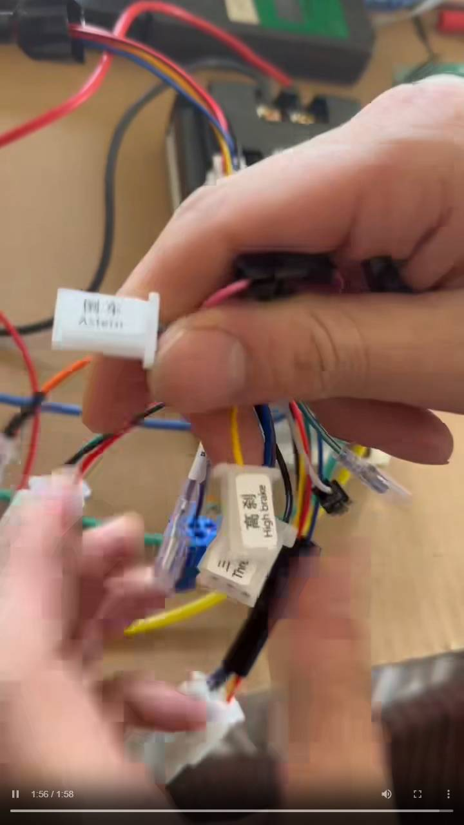
.tmp_video_review/f_116.jpg
