thegm-Gabriel/instrumentacao-ElectricCarUFSM/.tmp_video_review/f_118.jpg

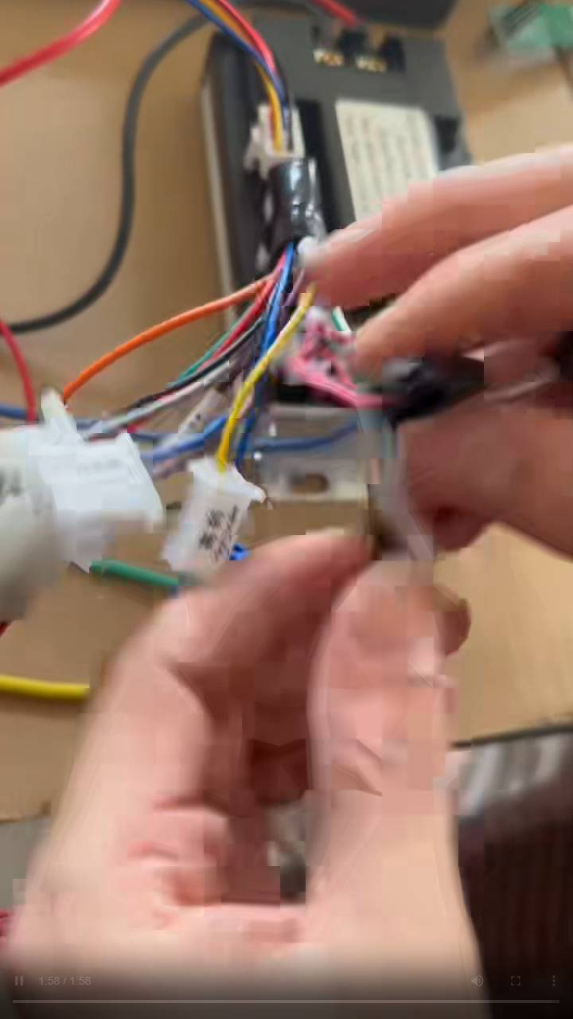
.tmp_video_review/f_118.jpg
