thegm-Gabriel/instrumentacao-ElectricCarUFSM/.tmp_video_review/frame_00_0s.png

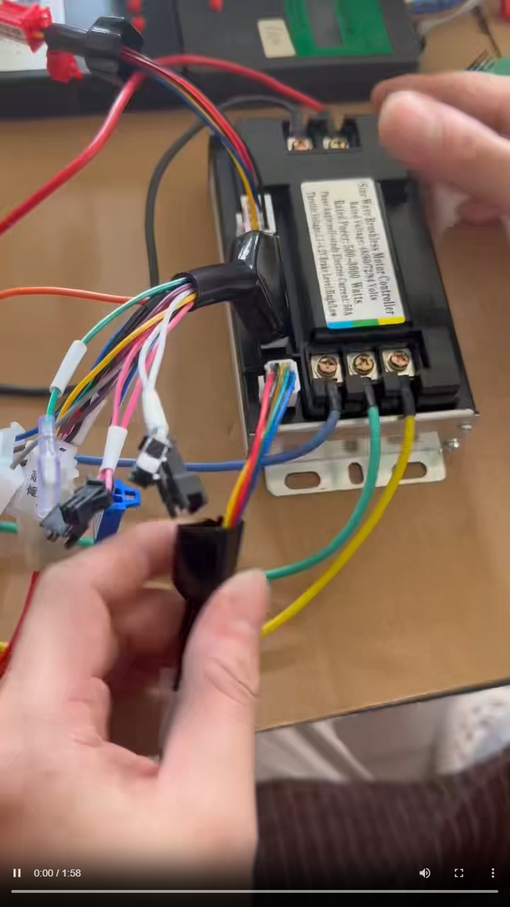
.tmp_video_review/frame_00_0s.png
