thegm-Gabriel/instrumentacao-ElectricCarUFSM/.tmp_video_review/frame_01_10s.png

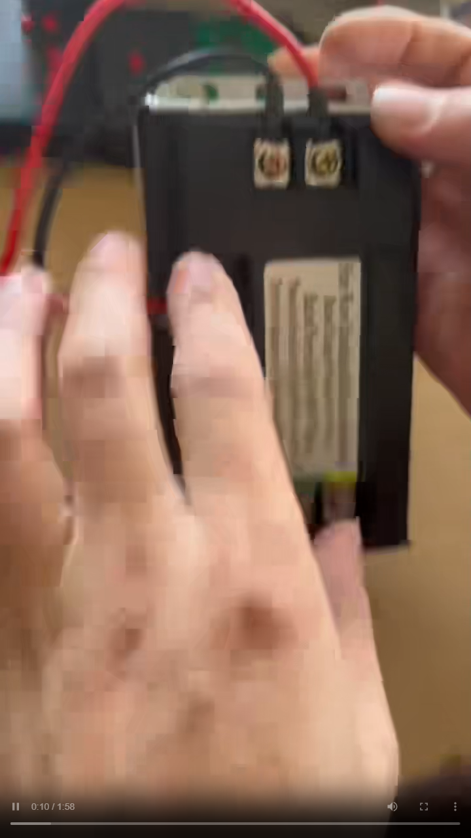
.tmp_video_review/frame_01_10s.png
