thegm-Gabriel/instrumentacao-ElectricCarUFSM/.tmp_video_review/frame_02_20s.png

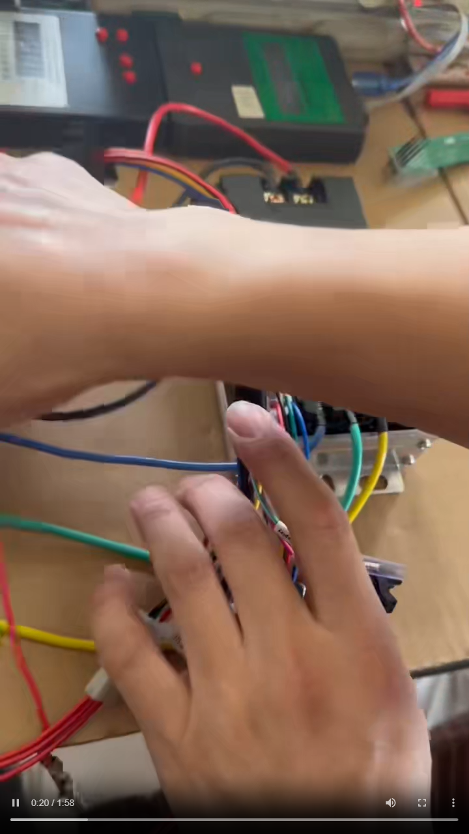
.tmp_video_review/frame_02_20s.png
