thegm-Gabriel/instrumentacao-ElectricCarUFSM/.tmp_video_review/frame_04_40s.png

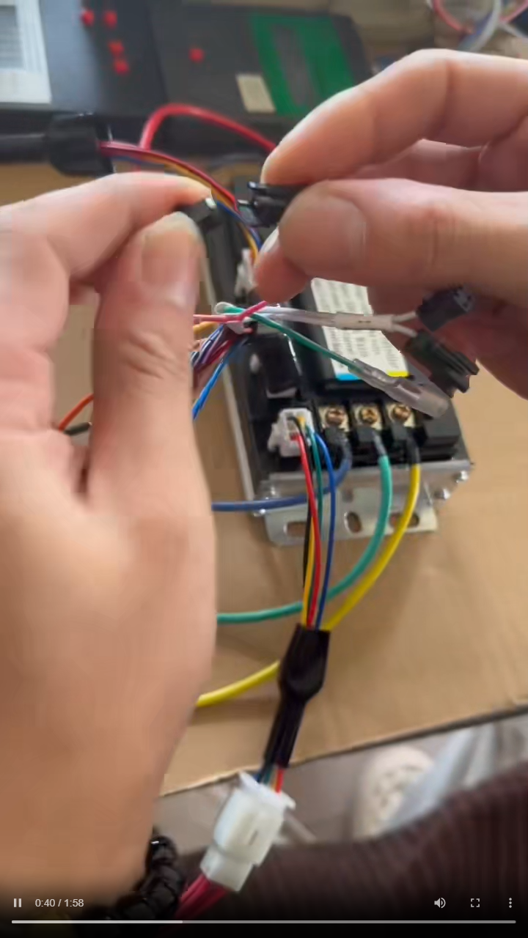
.tmp_video_review/frame_04_40s.png
