thegm-Gabriel/instrumentacao-ElectricCarUFSM/.tmp_video_review/frame_05_50s.png

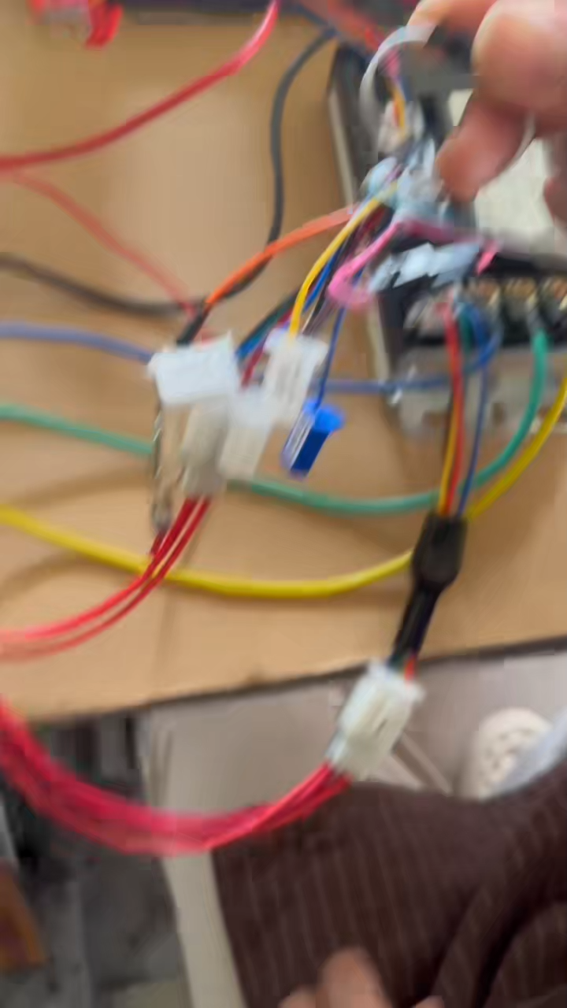
.tmp_video_review/frame_05_50s.png
