thegm-Gabriel/instrumentacao-ElectricCarUFSM/.tmp_video_review/frame_08_80s.png

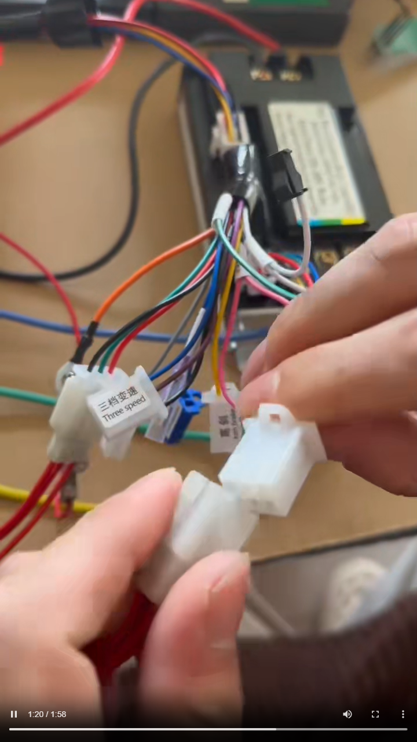
.tmp_video_review/frame_08_80s.png
