thegm-Gabriel/instrumentacao-ElectricCarUFSM/.tmp_video_review/frame_09_90s.png

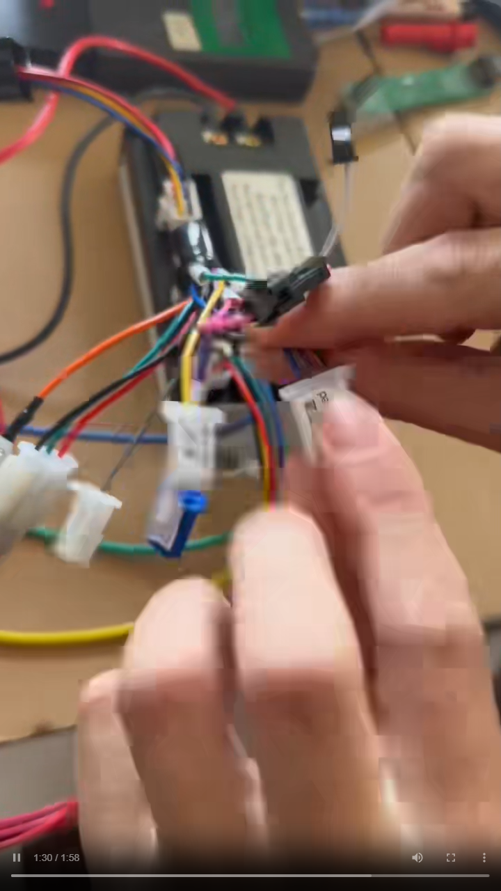
.tmp_video_review/frame_09_90s.png
