thegm-Gabriel/instrumentacao-ElectricCarUFSM/.tmp_video_review/frame_10_100s.png

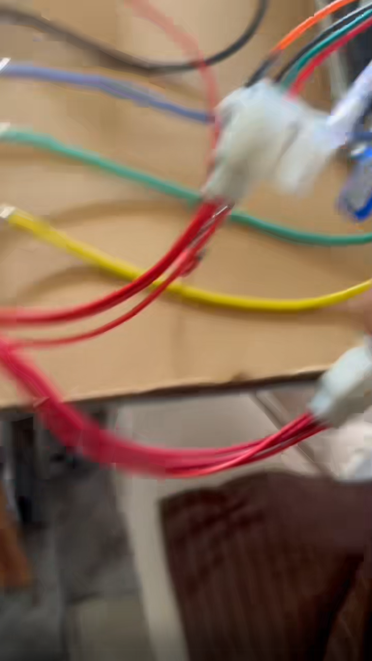
.tmp_video_review/frame_10_100s.png
