thegm-Gabriel/instrumentacao-ElectricCarUFSM/.tmp_video_review/frame_11_110s.png

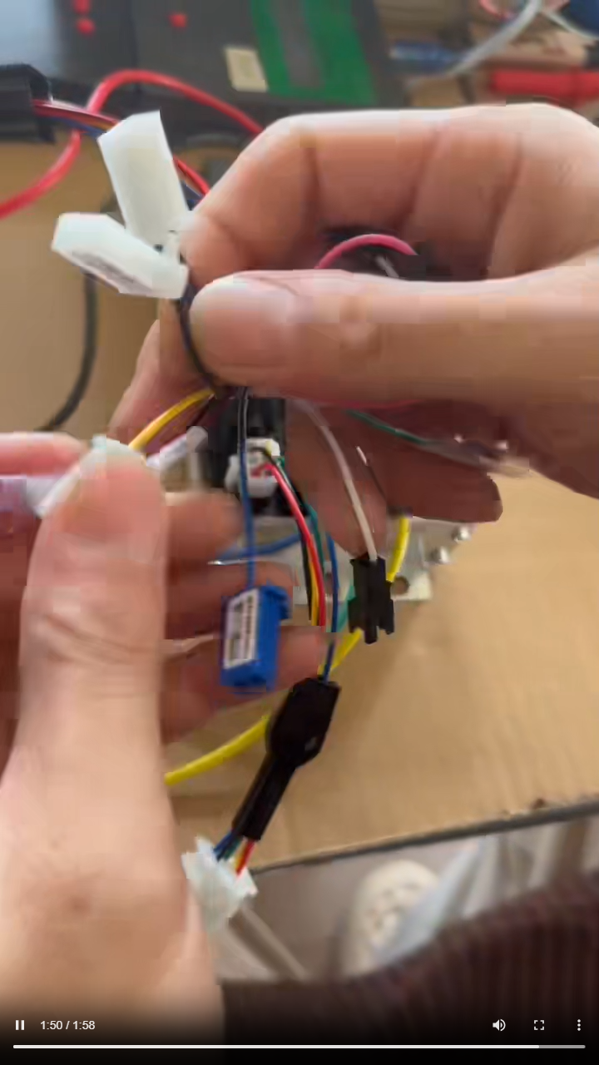
.tmp_video_review/frame_11_110s.png
