thegm-Gabriel/instrumentacao-ElectricCarUFSM/.tmp_video_review/frame_12_118s.png

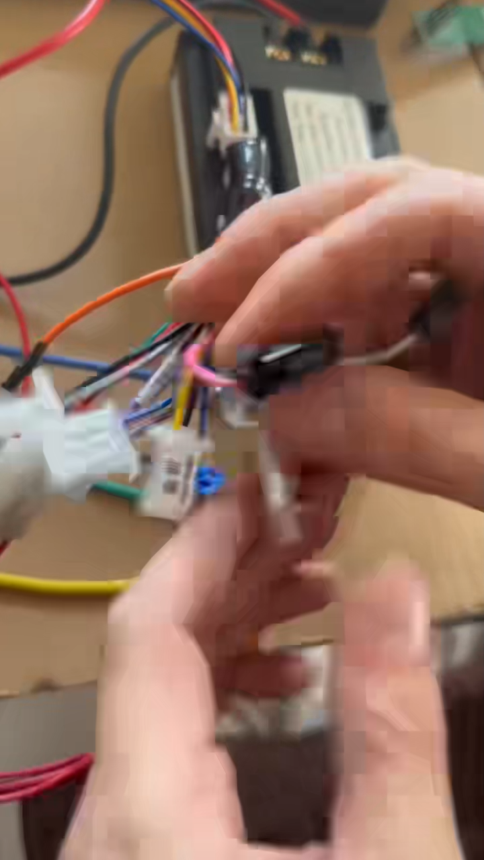
.tmp_video_review/frame_12_118s.png
