thegm-Gabriel/instrumentacao-ElectricCarUFSM/.tmp_video_review/sheet_00.jpg

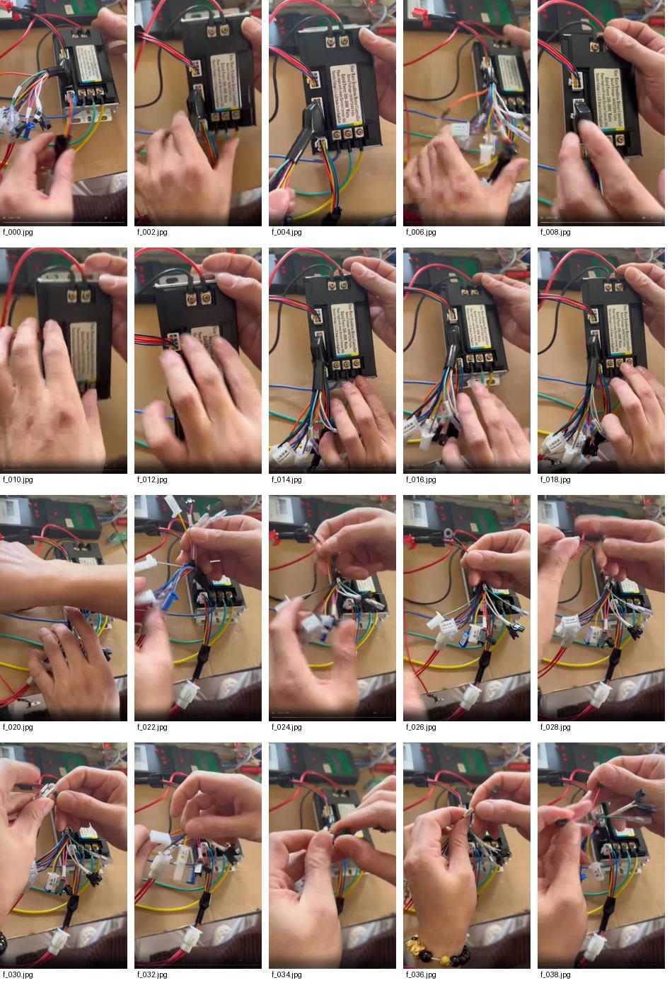
.tmp_video_review/sheet_00.jpg
