thegm-Gabriel/instrumentacao-ElectricCarUFSM/.tmp_video_review/sheet_01.jpg

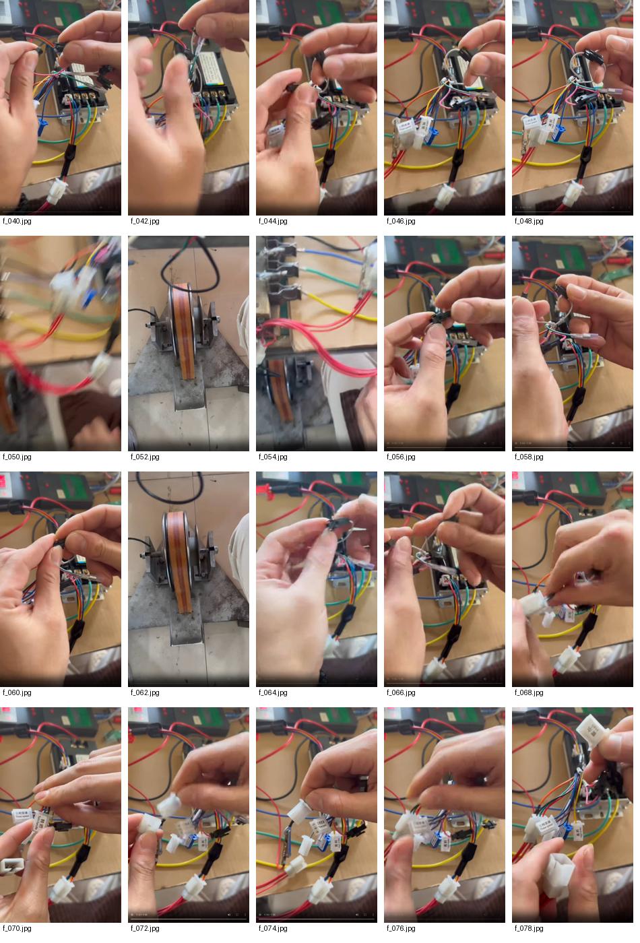
.tmp_video_review/sheet_01.jpg
