thegm-Gabriel/instrumentacao-ElectricCarUFSM/.tmp_video_review/sheet_02.jpg

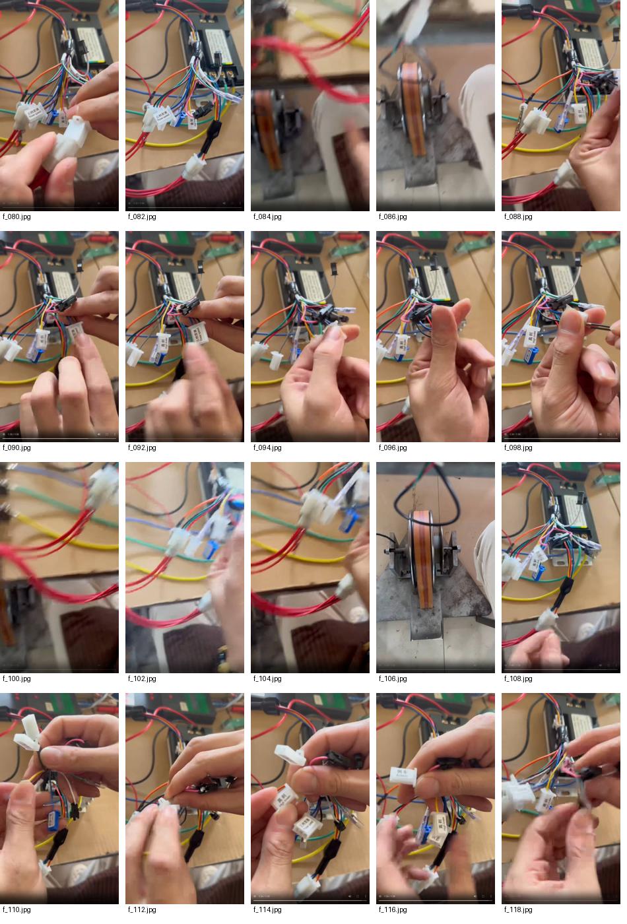
.tmp_video_review/sheet_02.jpg
