thegm-Gabriel/instrumentacao-ElectricCarUFSM/artefatos/qr_visitantes/painel_visitantes.png

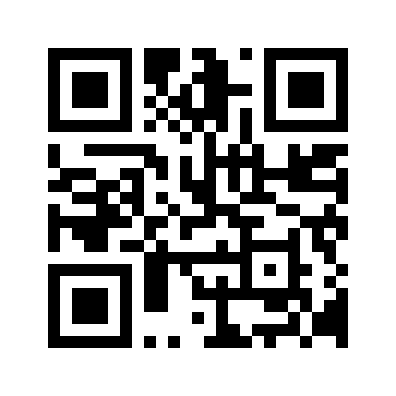
artefatos/qr_visitantes/painel_visitantes.png
