thegm-Gabriel/instrumentacao-ElectricCarUFSM/artefatos/qr_visitantes/wifi_visitantes.png

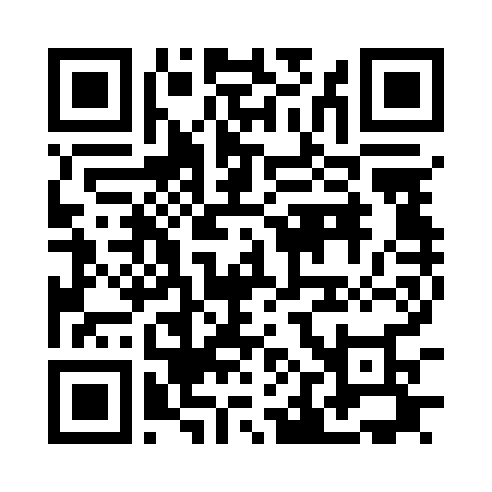
artefatos/qr_visitantes/wifi_visitantes.png
