thegm-Gabriel/instrumentacao-ElectricCarUFSM/tmp/pdfs/controlador/page-01.png

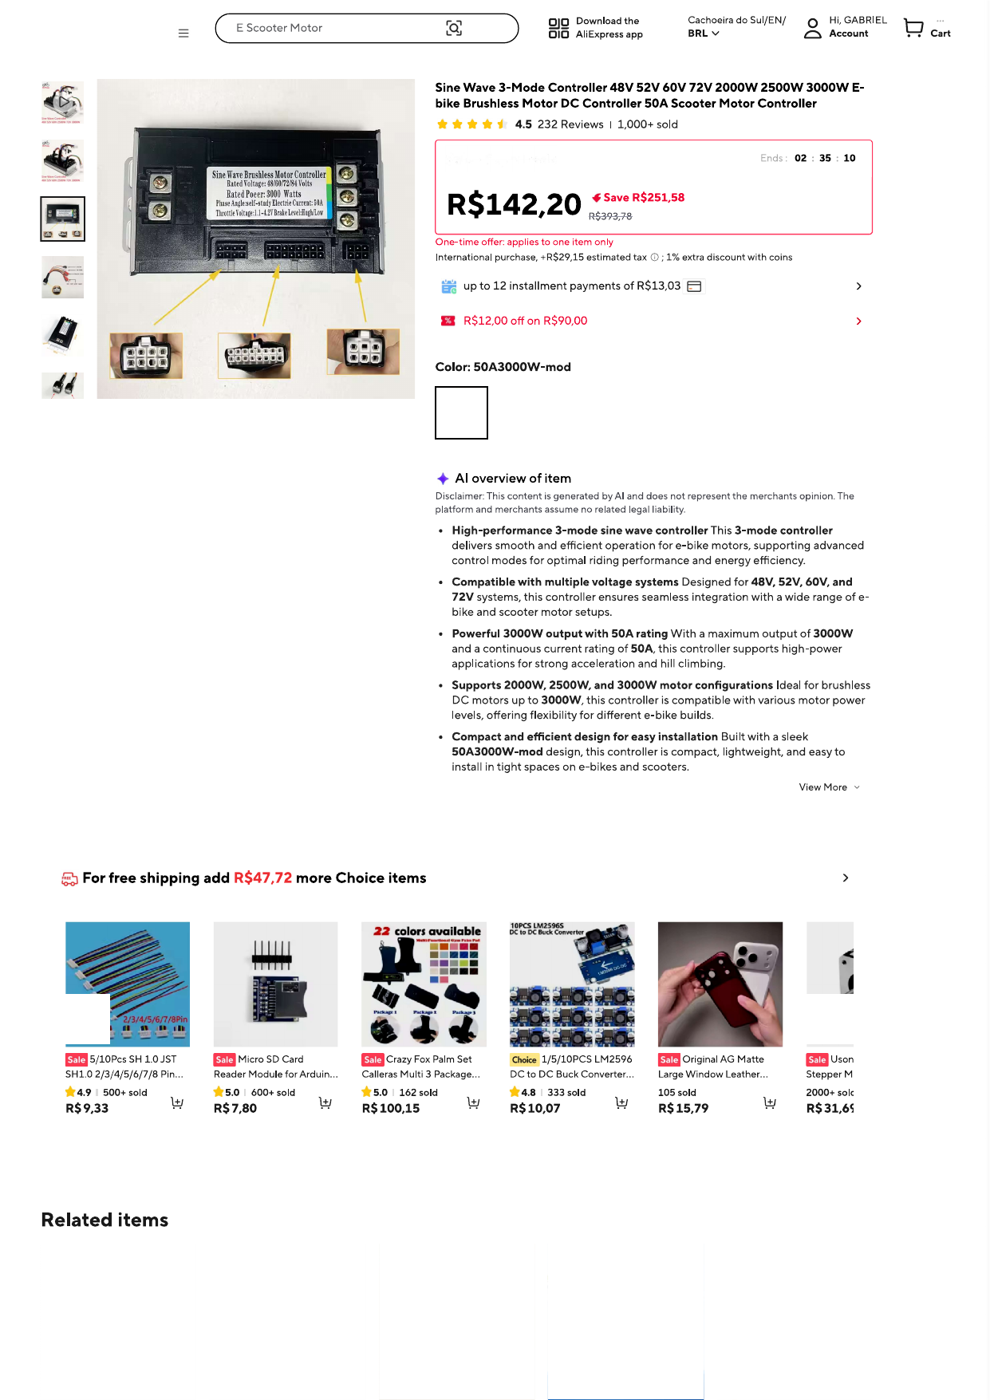
tmp/pdfs/controlador/page-01.png
