thegm-Gabriel/instrumentacao-ElectricCarUFSM/tmp/pdfs/controlador/page-02.png

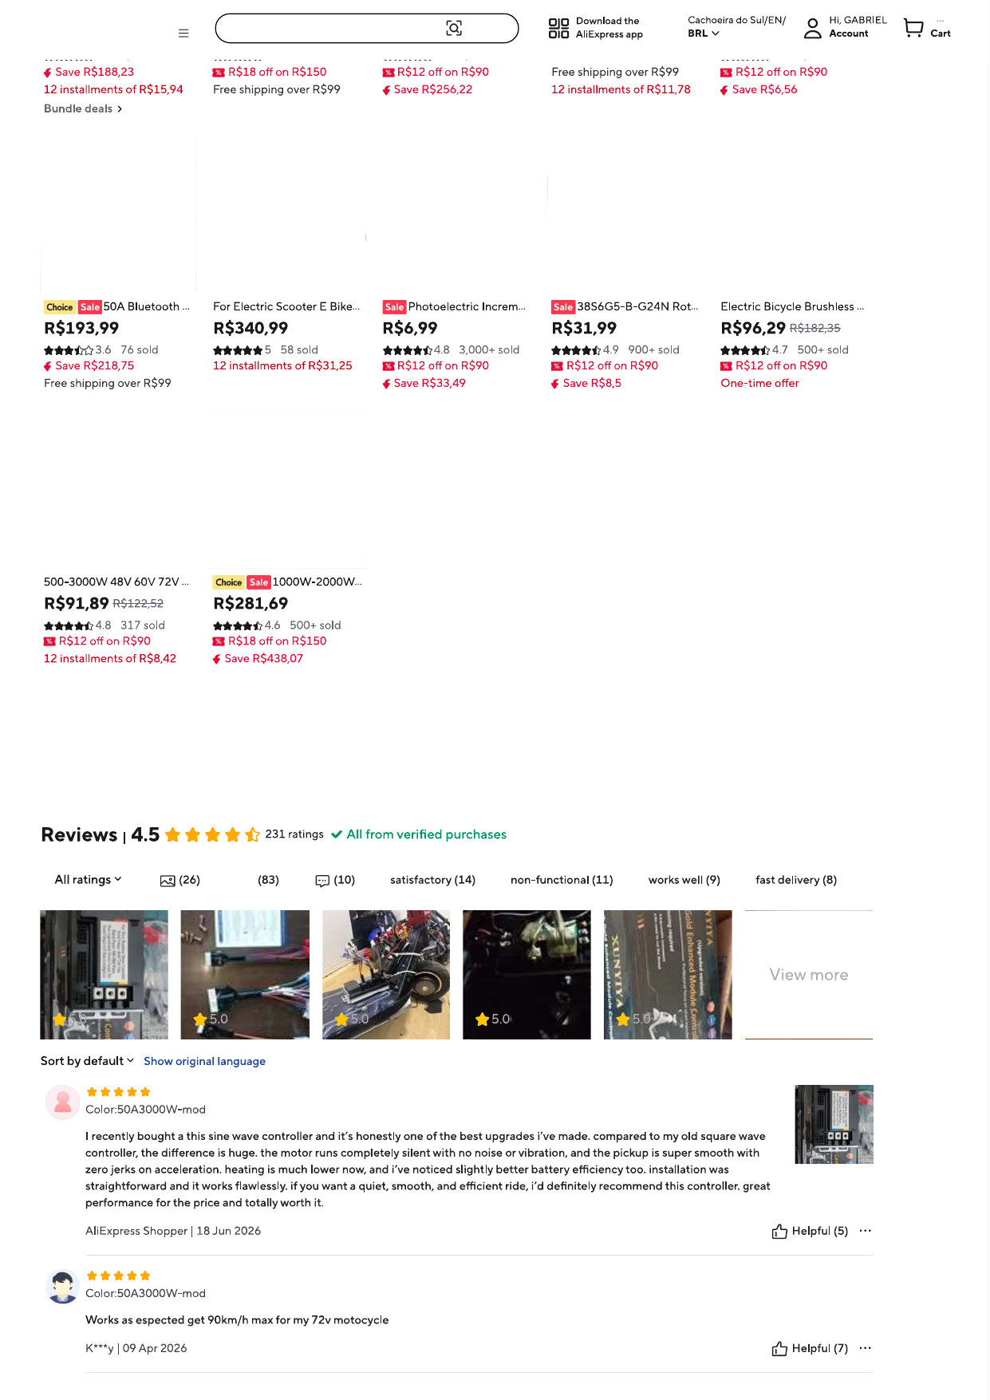
tmp/pdfs/controlador/page-02.png
