thegm-Gabriel/instrumentacao-ElectricCarUFSM/tmp/pdfs/controlador/page-03.png

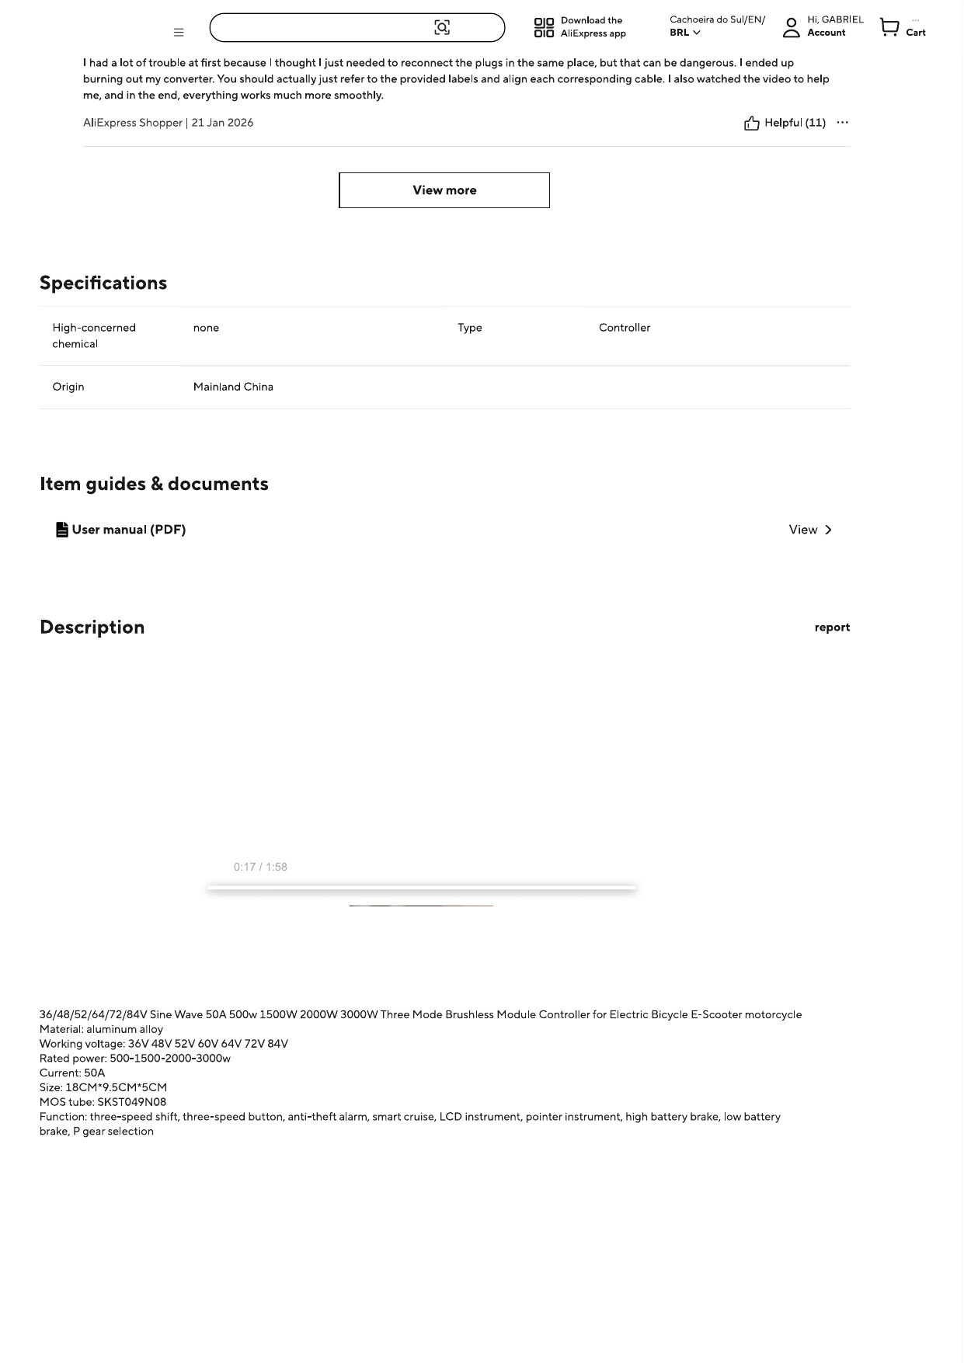
tmp/pdfs/controlador/page-03.png
