thegm-Gabriel/instrumentacao-ElectricCarUFSM/tmp/pdfs/controlador/page-04.png

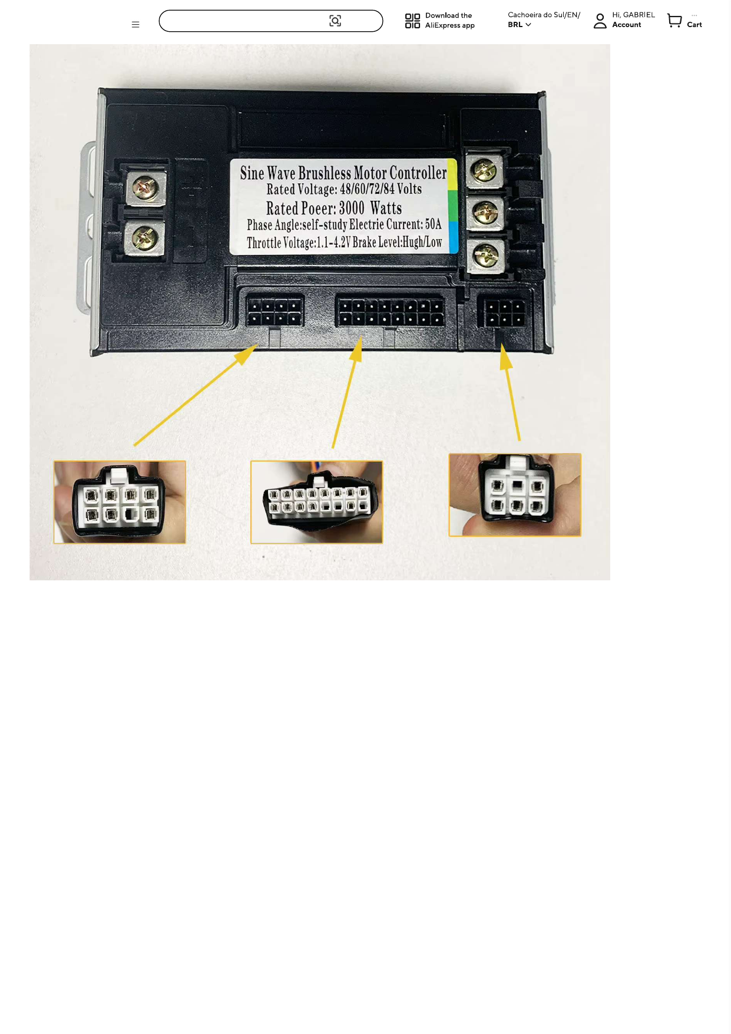
tmp/pdfs/controlador/page-04.png
