thegm-Gabriel/instrumentacao-ElectricCarUFSM/tmp/pdfs/controlador/page-05.png

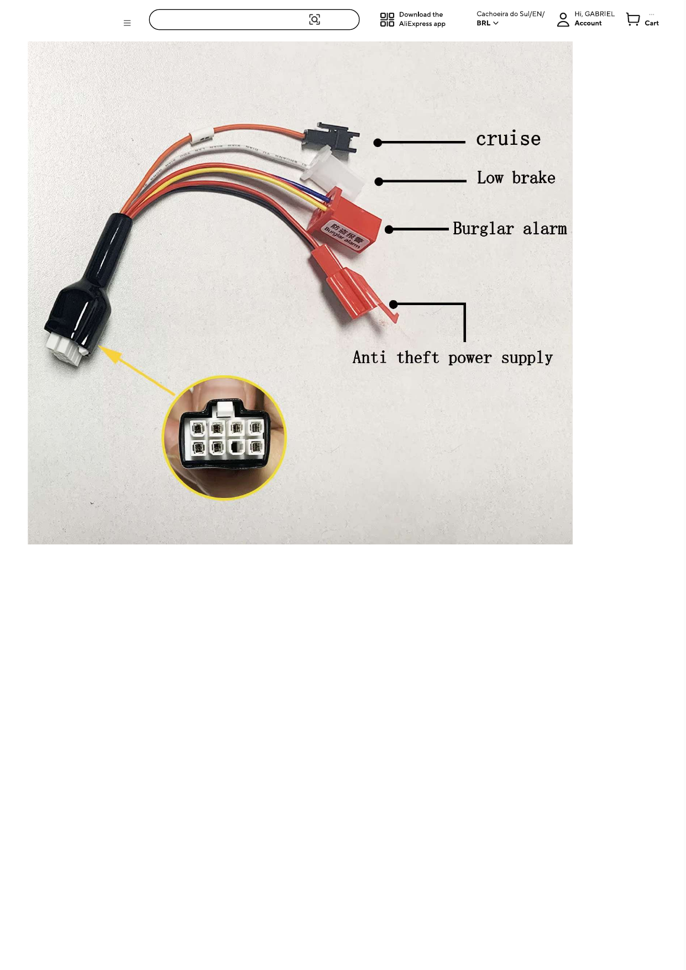
tmp/pdfs/controlador/page-05.png
