thegm-Gabriel/instrumentacao-ElectricCarUFSM/tmp/pdfs/controlador/page-06.png

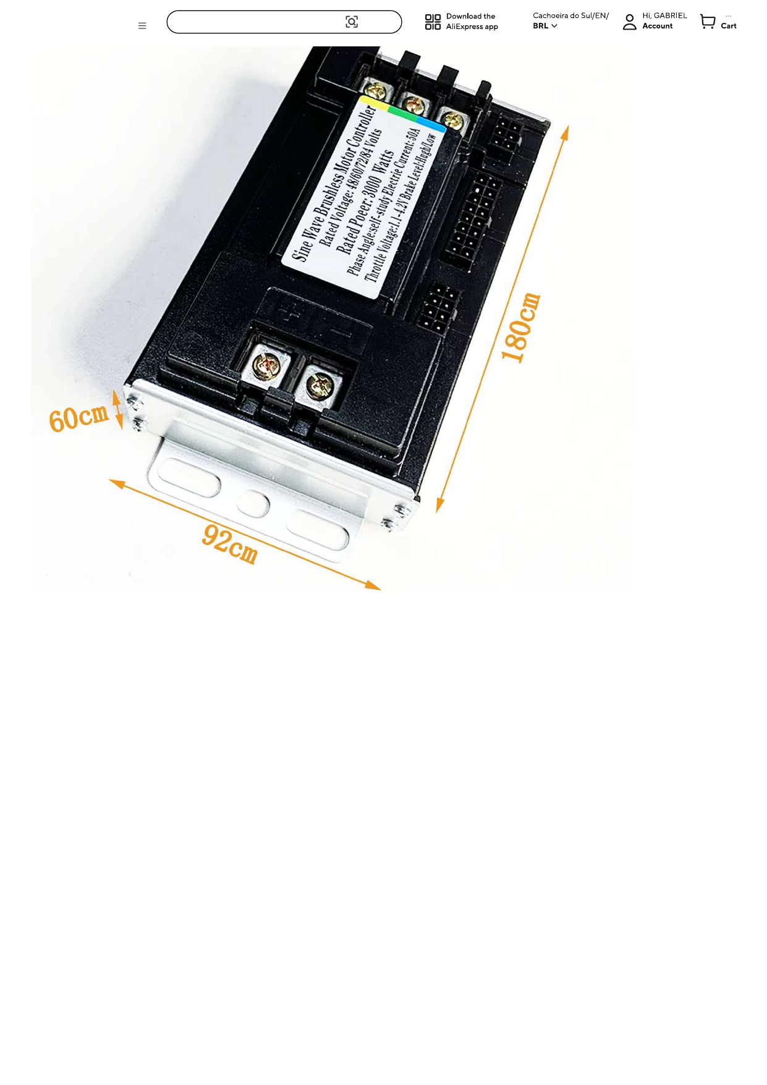
tmp/pdfs/controlador/page-06.png
