thegm-Gabriel/instrumentacao-ElectricCarUFSM/tmp/pdfs/controlador/page-07.png

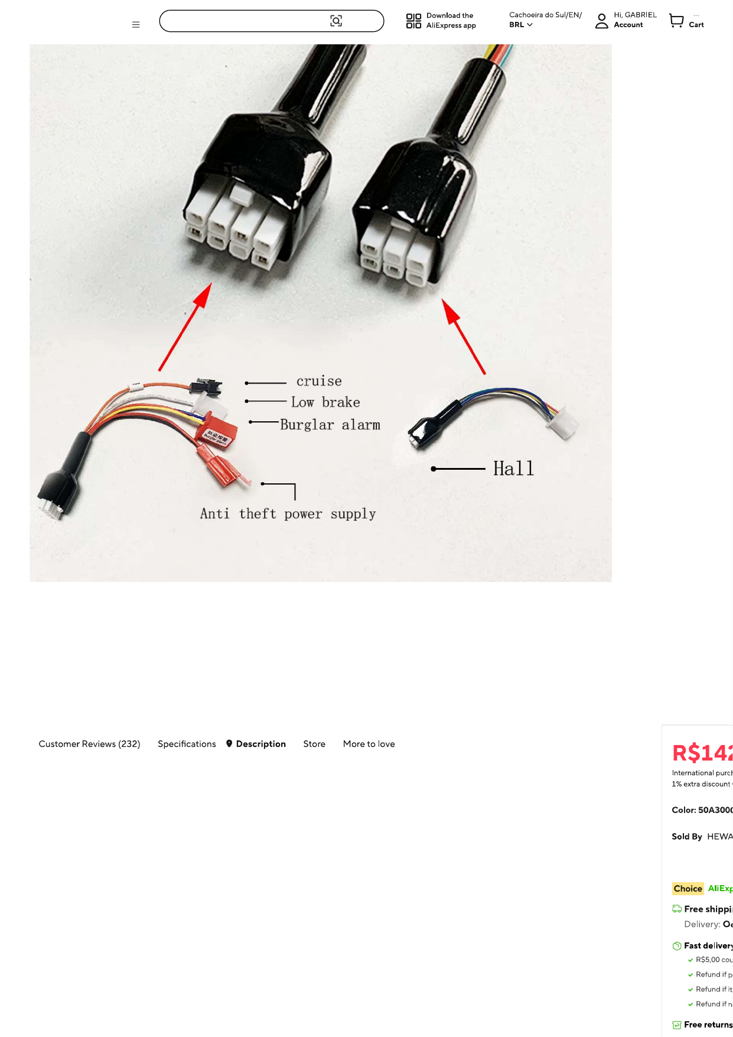
tmp/pdfs/controlador/page-07.png
