thegm-Gabriel/instrumentacao-ElectricCarUFSM/tmp/pdfs/controlador/page-08.png

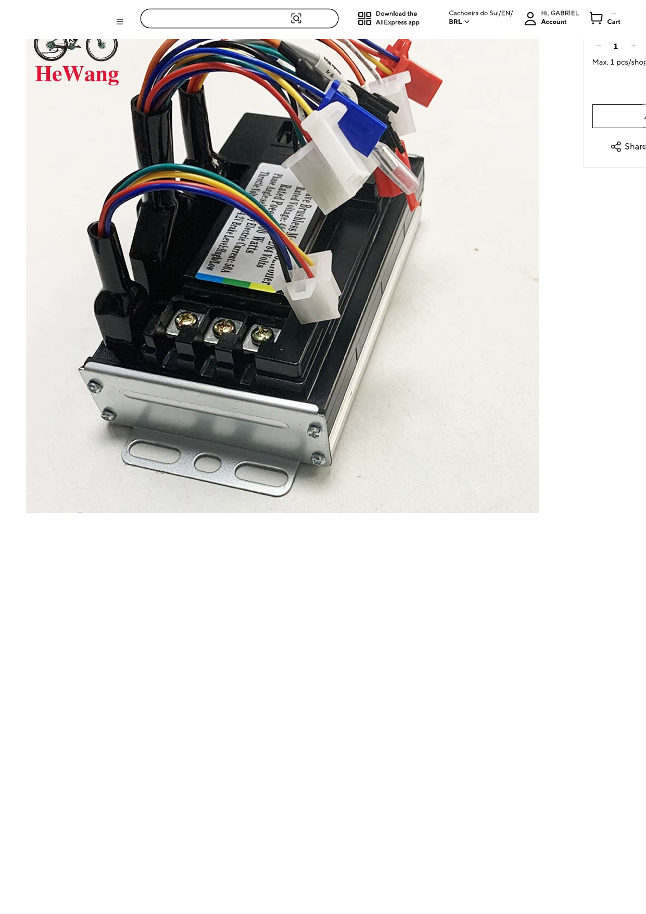
tmp/pdfs/controlador/page-08.png
