thegm-Gabriel/instrumentacao-ElectricCarUFSM/tmp/pdfs/controlador/page-09.png

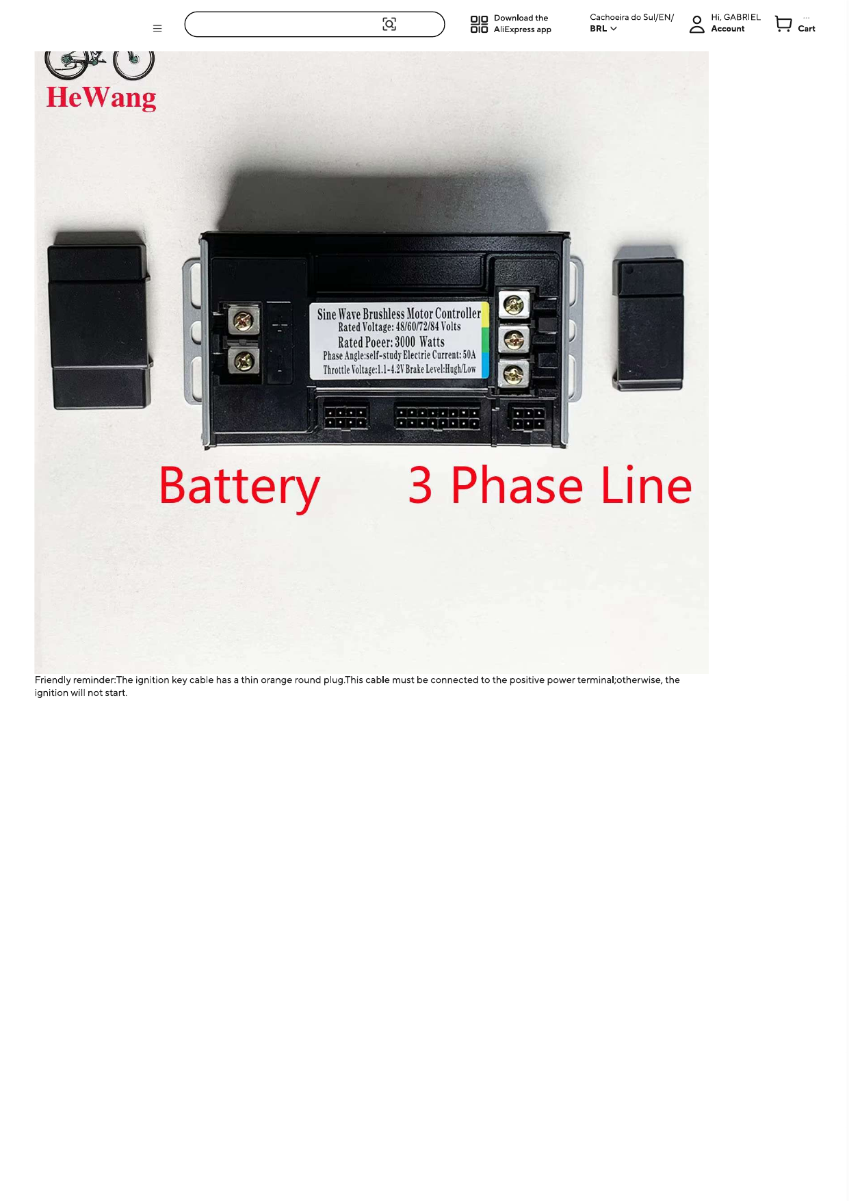
tmp/pdfs/controlador/page-09.png
