thegm-Gabriel/instrumentacao-ElectricCarUFSM/tmp/pdfs/controlador/page-10.png

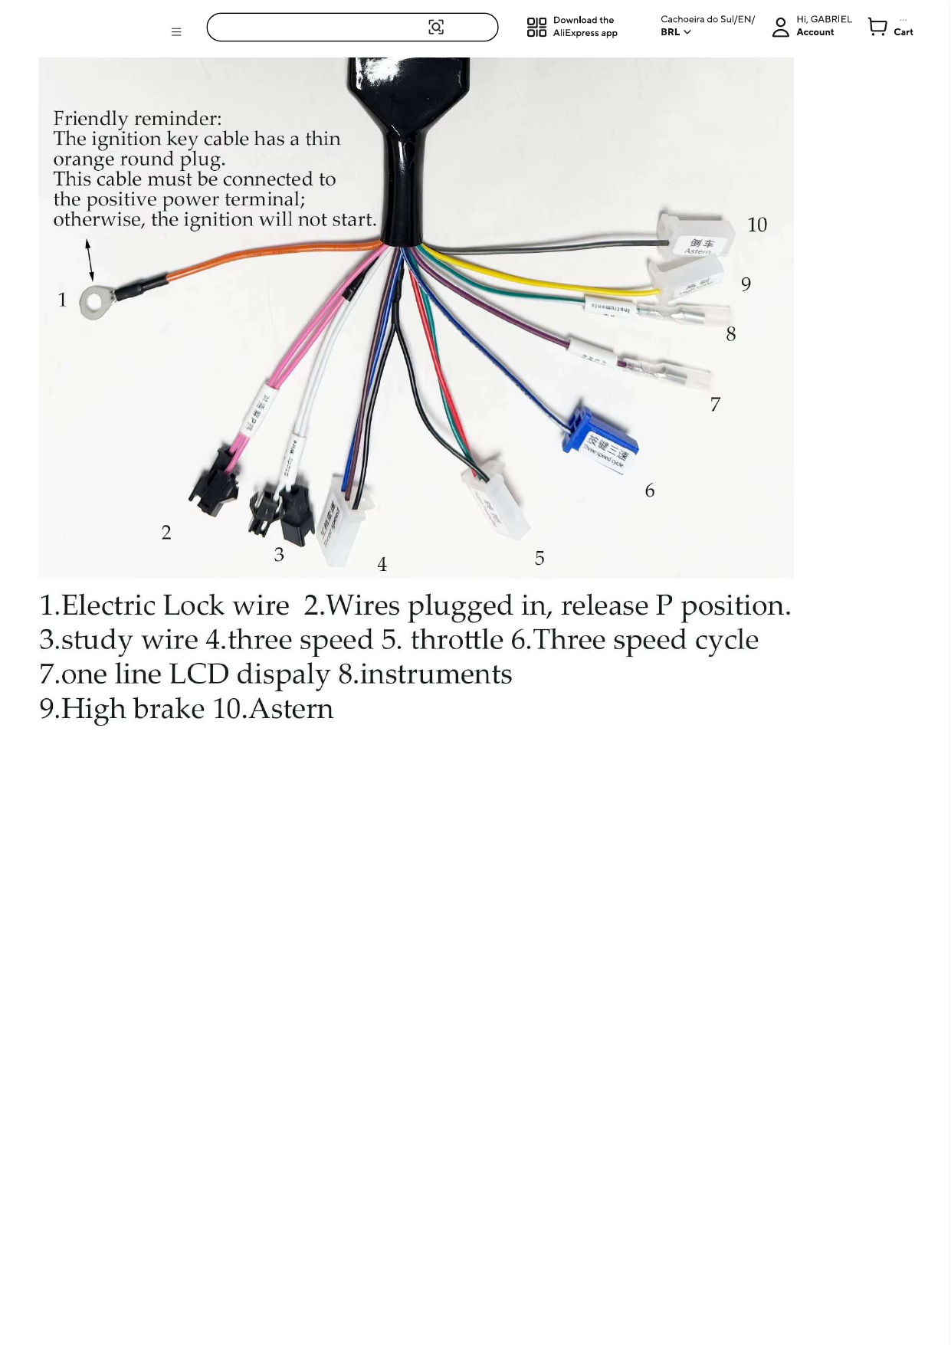
tmp/pdfs/controlador/page-10.png
