thegm-Gabriel/instrumentacao-ElectricCarUFSM/tmp/pdfs/controlador/page-11.png

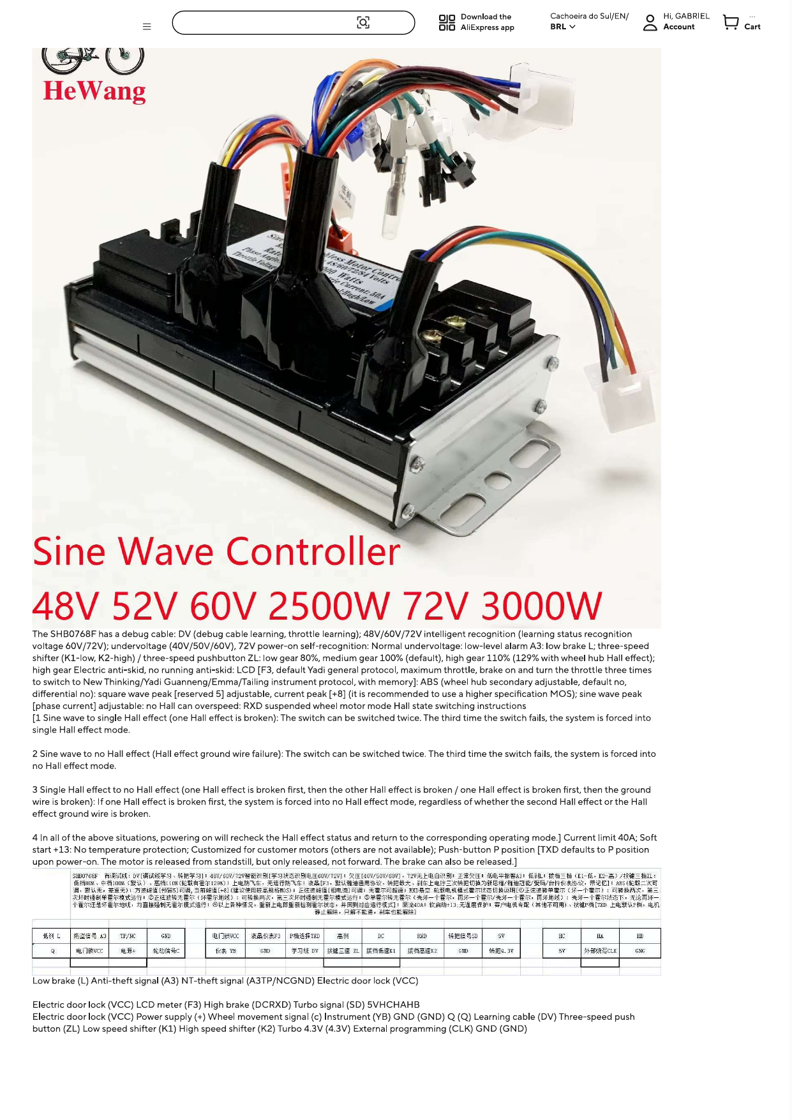
tmp/pdfs/controlador/page-11.png
