thegm-Gabriel/instrumentacao-ElectricCarUFSM/tmp/pdfs/controlador/page-12.png

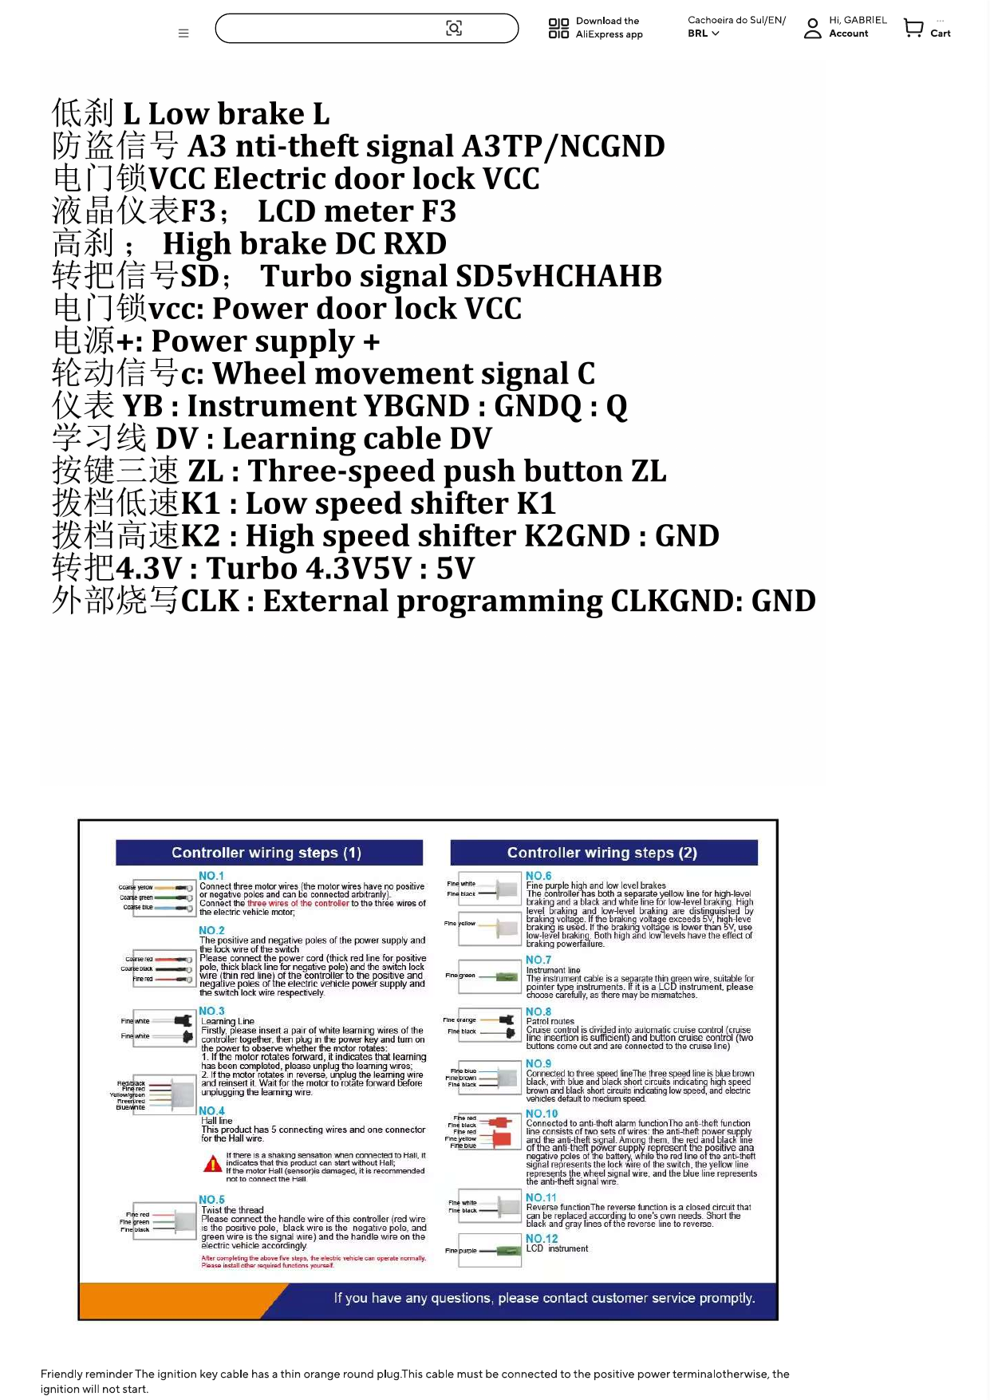
tmp/pdfs/controlador/page-12.png
