thegm-Gabriel/instrumentacao-ElectricCarUFSM/tmp/pdfs/controlador/page-13.png

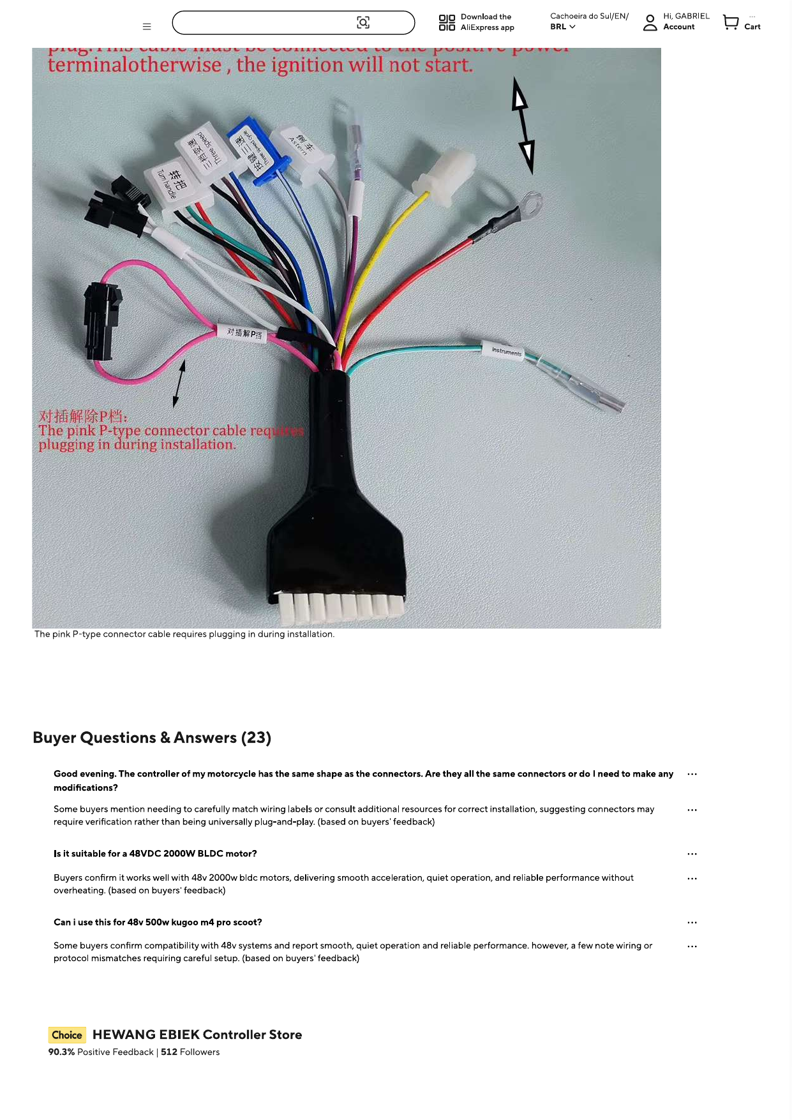
tmp/pdfs/controlador/page-13.png
