thegm-Gabriel/instrumentacao-ElectricCarUFSM/tmp/pdfs/controlador/page-14.png

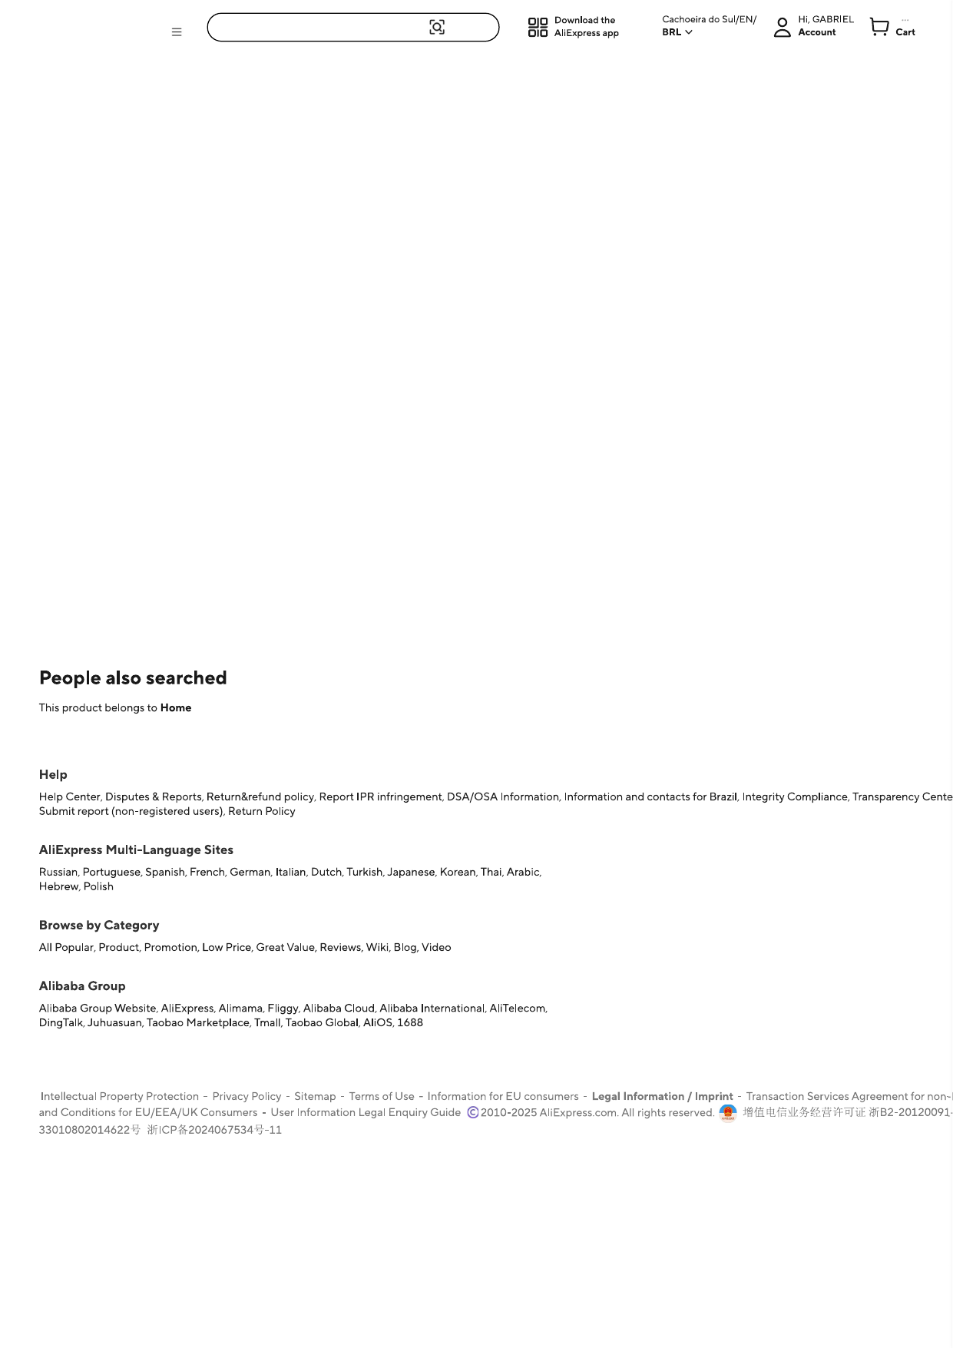
tmp/pdfs/controlador/page-14.png
