thegm-Gabriel/instrumentacao-ElectricCarUFSM/tmp/pdfs/reference-1.png

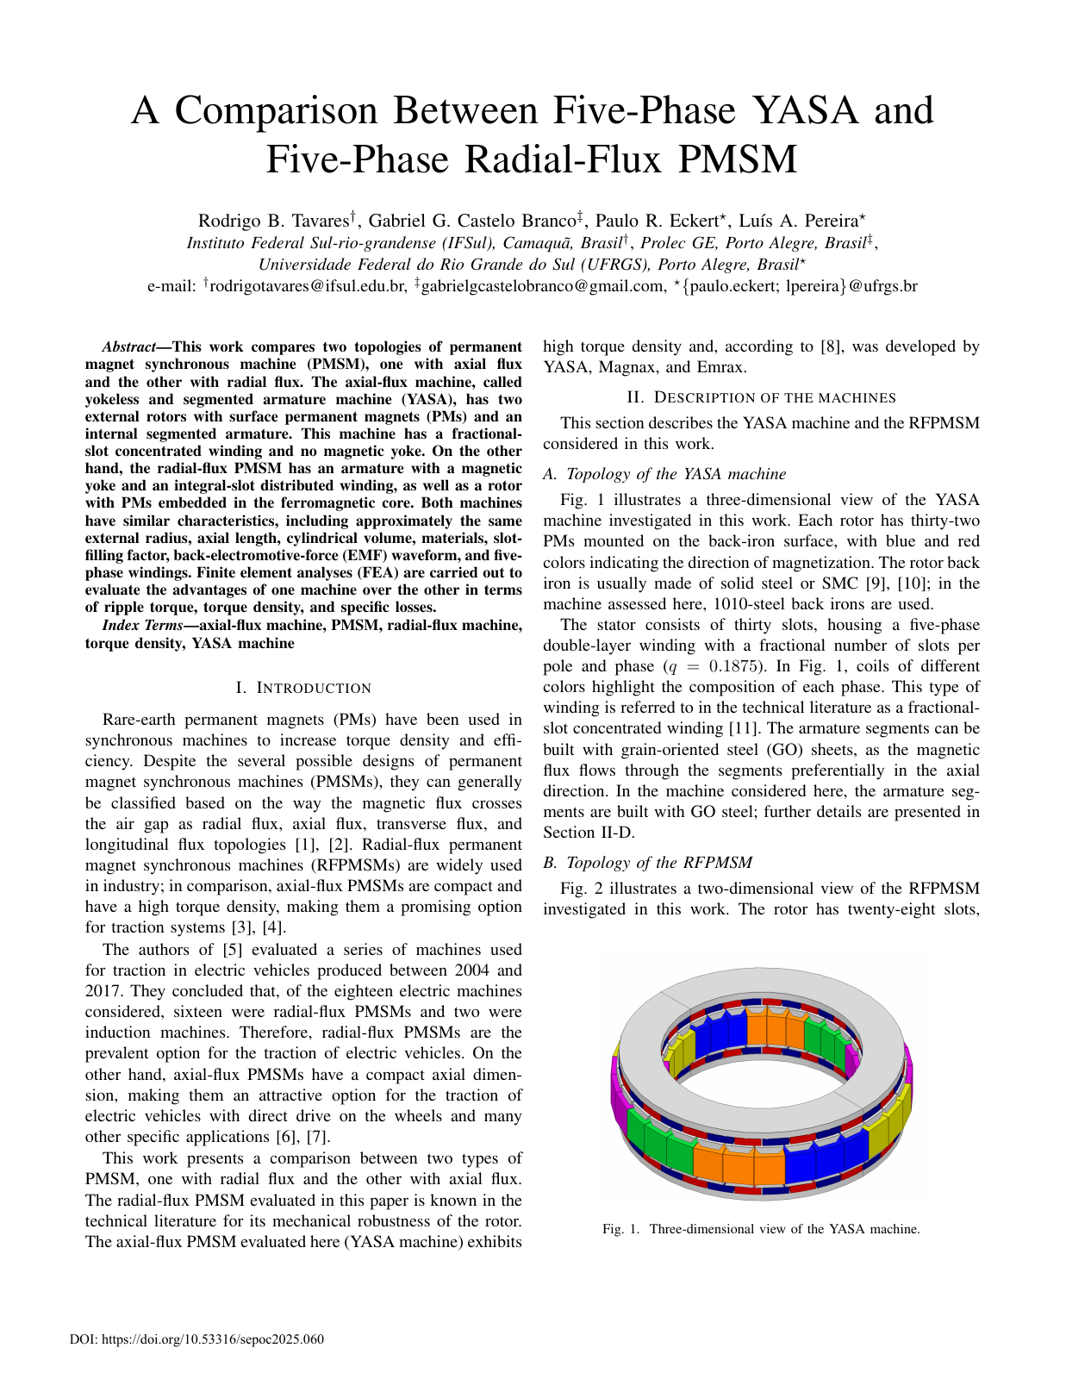
tmp/pdfs/reference-1.png
