thegm-Gabriel/instrumentacao-ElectricCarUFSM/tmp/pdfs/reference-2.png

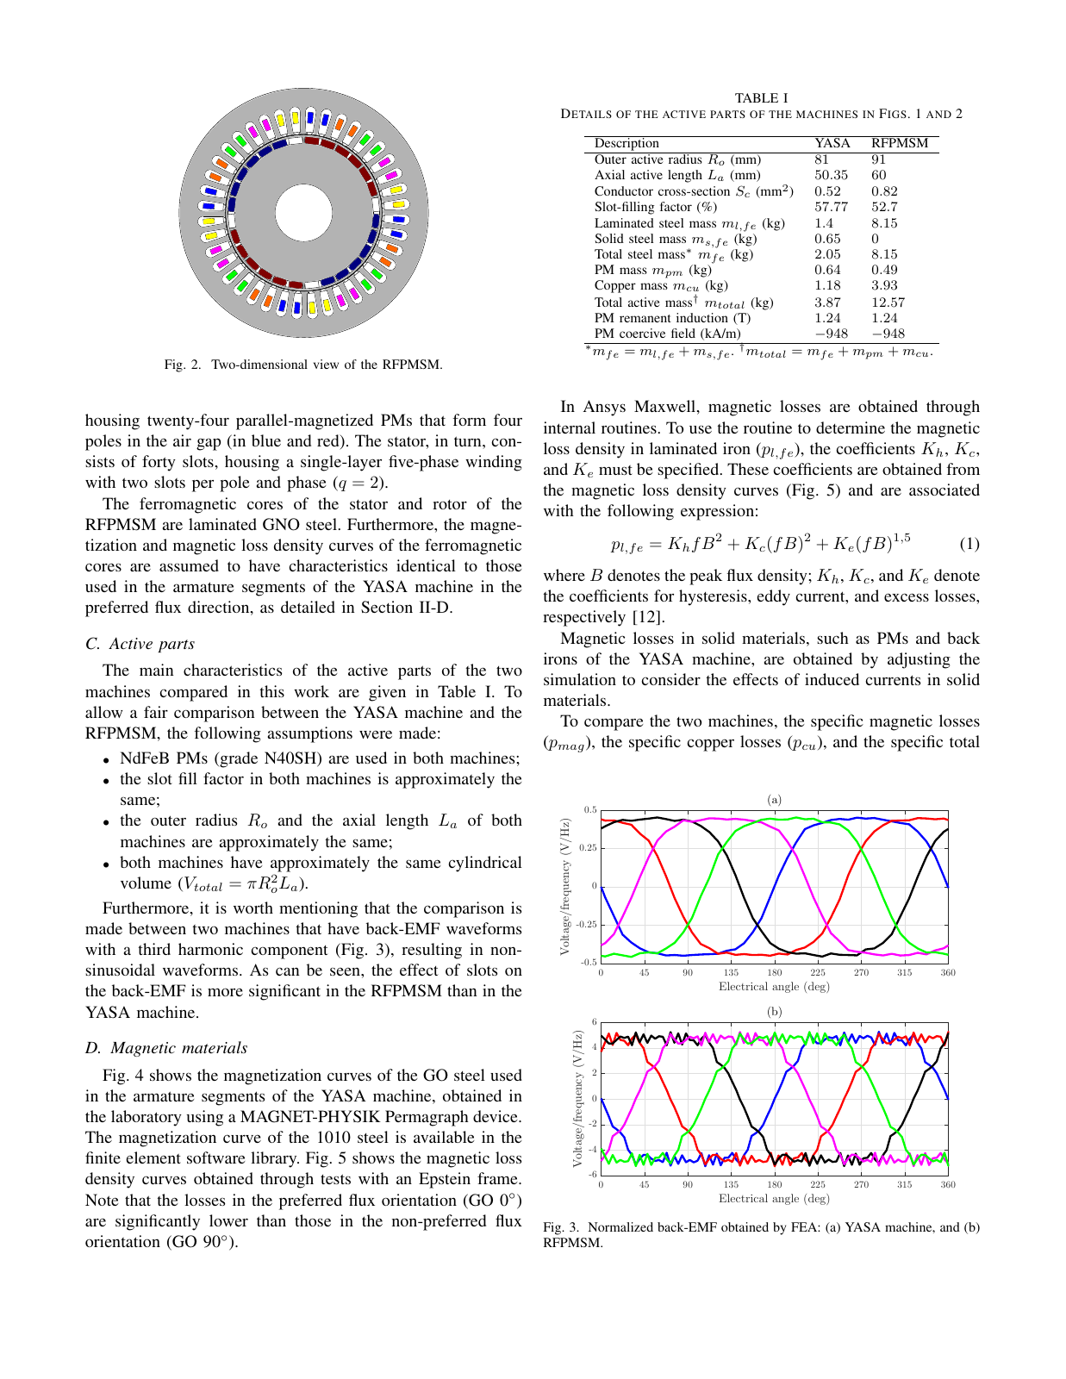
tmp/pdfs/reference-2.png
