thegm-Gabriel/instrumentacao-ElectricCarUFSM/tmp/pdfs/reference-3.png

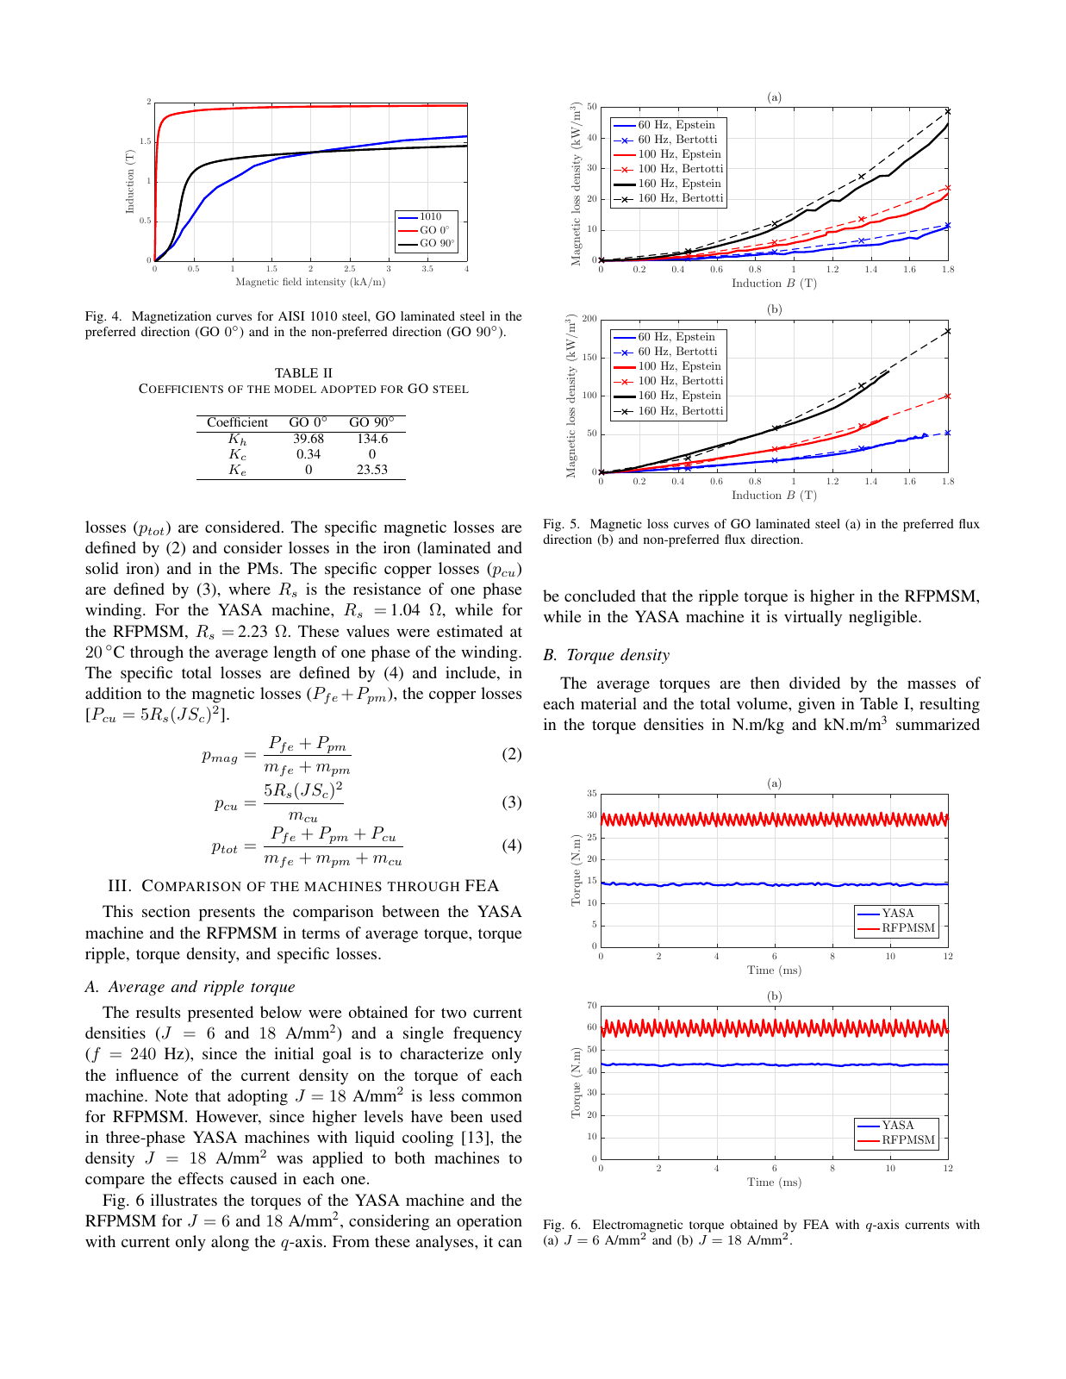
tmp/pdfs/reference-3.png
