thegm-Gabriel/instrumentacao-ElectricCarUFSM/tmp/pdfs/reference-4.png

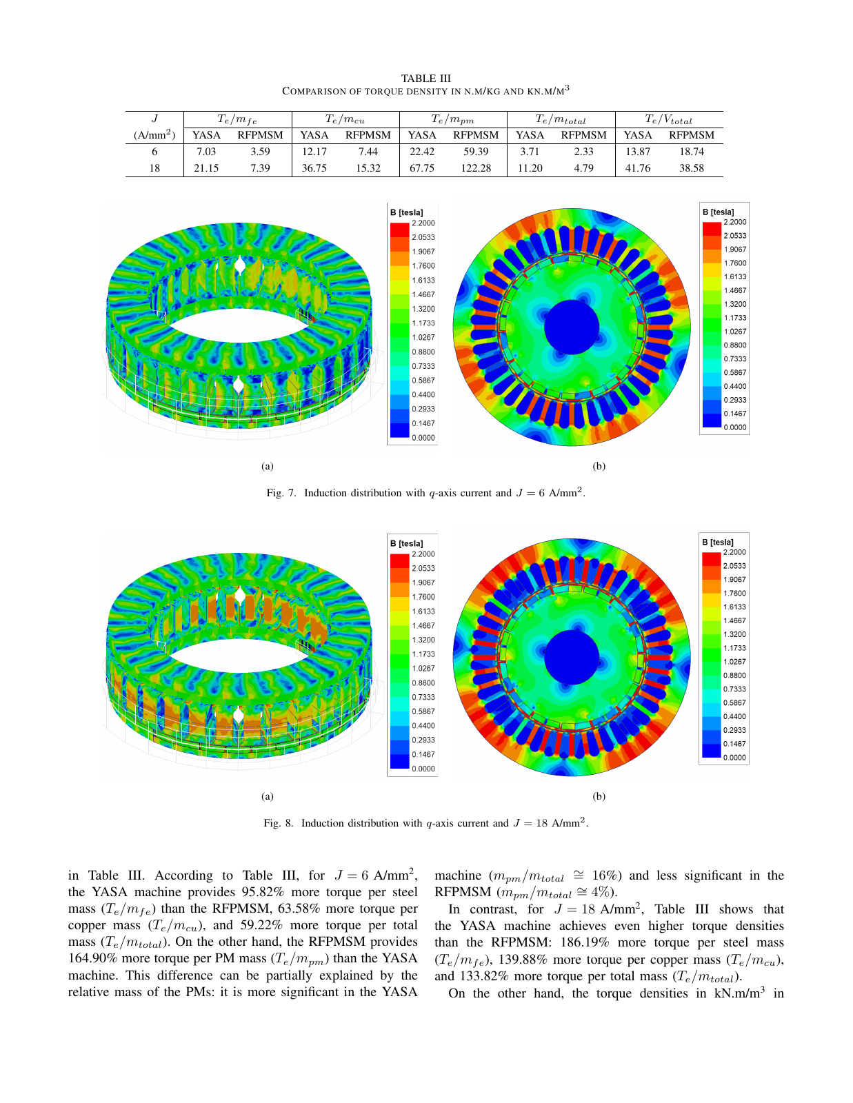
tmp/pdfs/reference-4.png
