thegm-Gabriel/instrumentacao-ElectricCarUFSM/tmp/pdfs/reference-5.png

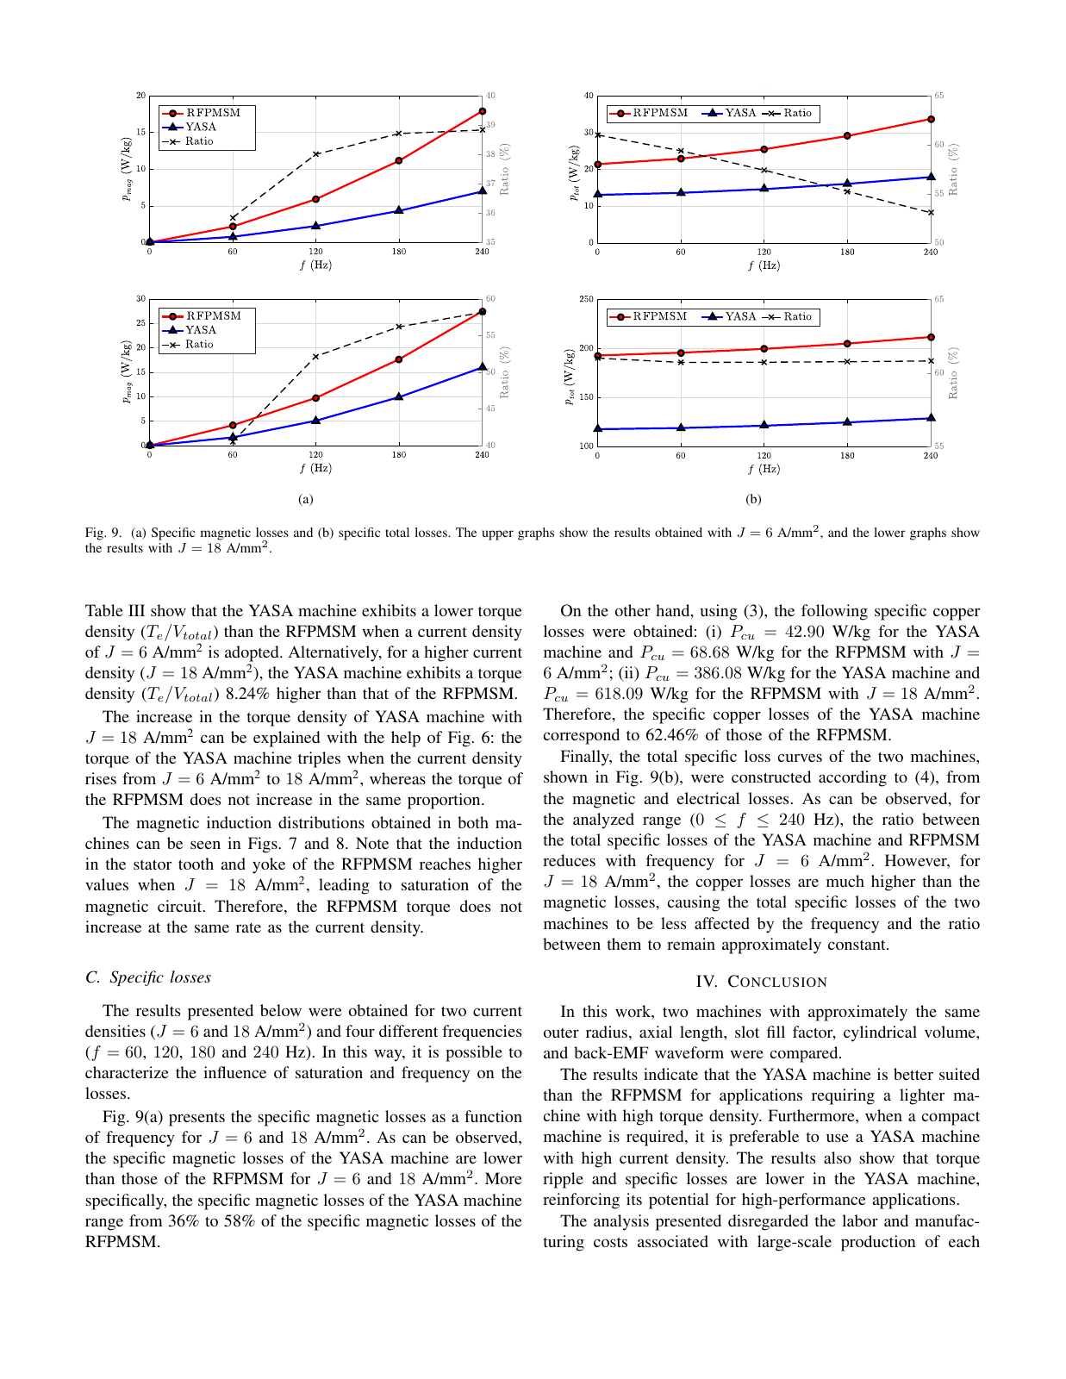
tmp/pdfs/reference-5.png
