thegm-Gabriel/instrumentacao-ElectricCarUFSM/tmp/pdfs/reference-6.png

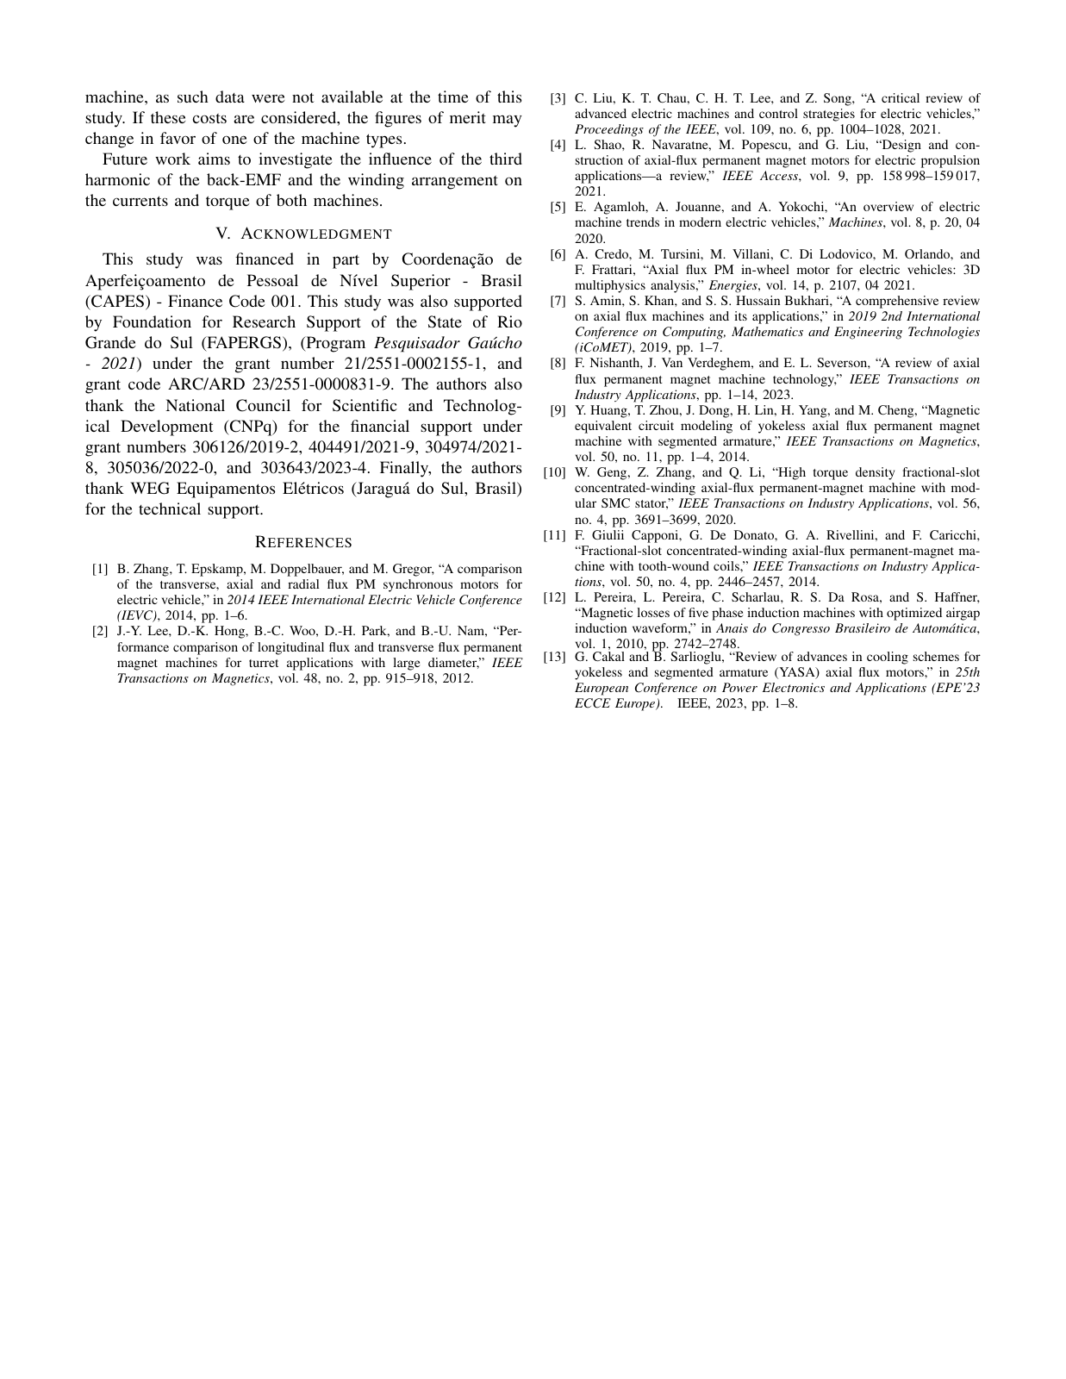
tmp/pdfs/reference-6.png
