thegm-Gabriel/instrumentacao-ElectricCarUFSM/manual_overleaf/imagens/LEIA-ME.txt

Insira aqui fotos, esquemas e capturas do projeto.
