thegm-Gabriel/instrumentacao-ElectricCarUFSM/hardware/kicad/KiCad_pcb_telemetria/KiCad_pcb_telemetria.kicad_pcb

## KiCad design hardware/kicad/KiCad_pcb_telemetria/KiCad_pcb_telemetria.kicad_pcb (2026-11-07)

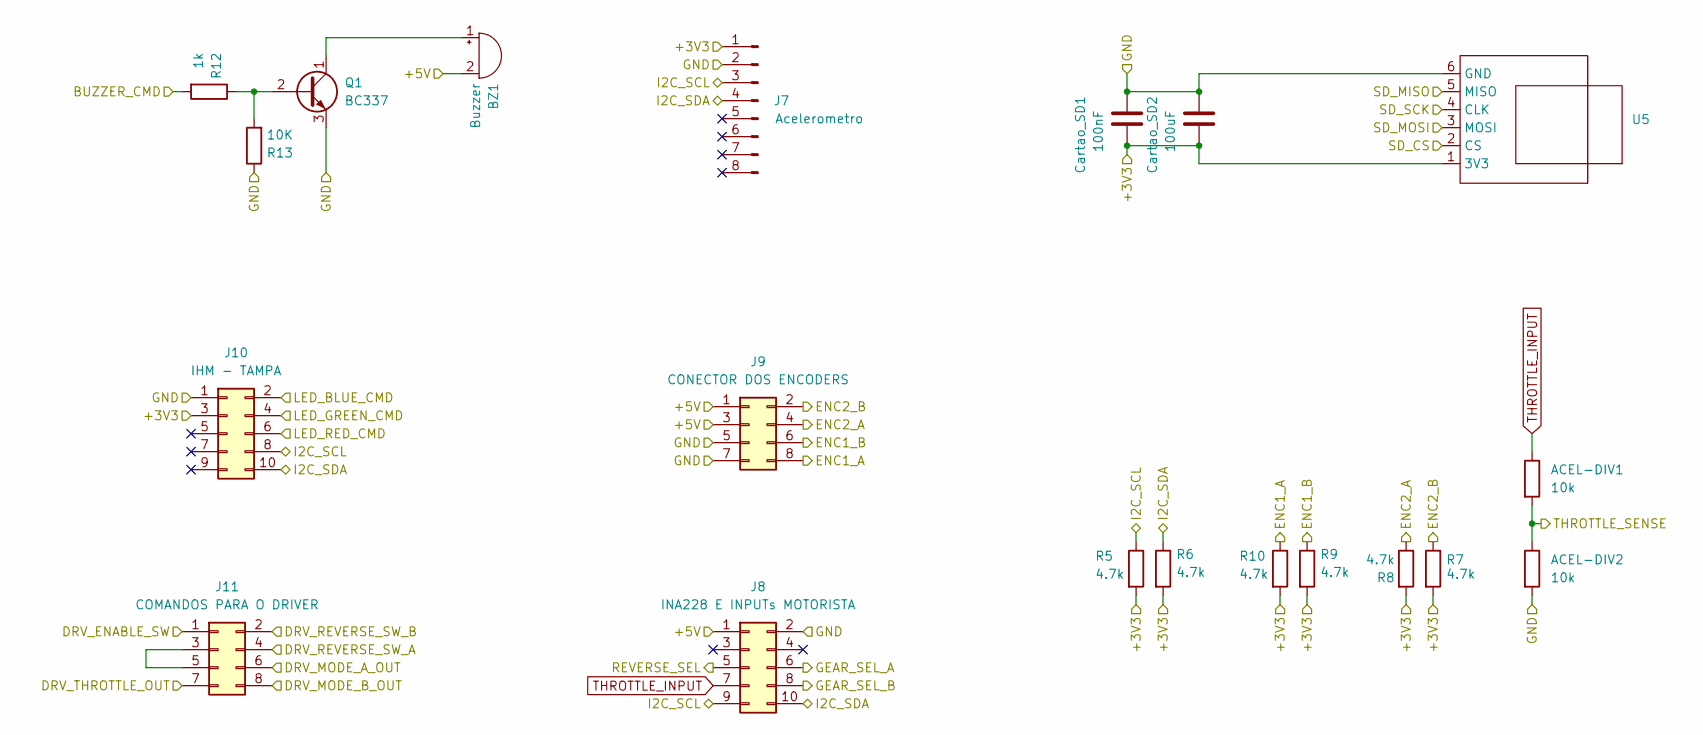
[picture p98: schematic periféricos.kicad_sch, NEXUS - Controladora do Eletric Car UFSM-CS]

Parts:
ACEL-DIV1, ACEL-DIV2: 10k; R_Axial_DIN0204_L3.6mm_D1.6mm_P5.08mm_Horizontal
BZ1: Buzzer; Buzzer_D14mm_H7mm_P10mm
Cartao_SD1: 100nF; C_Radial_D5.0mm_H11.0mm_P2.00mm
Cartao_SD2: 100uF; C_Radial_D5.0mm_H11.0mm_P2.00mm
J7: Acelerometro; PinHeader_1x08_P2.54mm_Vertical
J8: INA228 E INPUTs MOTORISTA; JST_PUD_B10B-PUDSS_2x05_P2.00mm_Vertical
J9: CONECTOR DOS ENCODERS; JST_PUD_B08B-PUDSS_2x04_P2.00mm_Vertical
J10: IHM - TAMPA; JST_PUD_B10B-PUDSS_2x05_P2.00mm_Vertical
J11: COMANDOS PARA O DRIVER; JST_PUD_B08B-PUDSS_2x04_P2.00mm_Vertical
Q1: BC337; TO-92
R5, R6, R7, R8, R9, R10: 4.7k; R_Axial_DIN0204_L3.6mm_D1.6mm_P5.08mm_Horizontal
R12: 1k; R_Axial_DIN0204_L3.6mm_D1.6mm_P5.08mm_Horizontal
R13: 10K; R_Axial_DIN0204_L3.6mm_D1.6mm_P5.08mm_Horizontal
U5: CartãoSD-MODULO

Connections:
+3V3: Cartao_SD1.2, Cartao_SD2.2, J7.1, J10.3, R5.2, R6.2, R7.2, R8.2, R9.2, R10.2, U5.1 (3V3); also elsewhere on the board
+5V: BZ1.2 (-), J8.1, J9.1, J9.3; also elsewhere on the board
/CONTROLE DO DRIVER/DRV_ENABLE_SW: J11.1; also elsewhere on the board
/CONTROLE DO DRIVER/DRV_MODE_A_OUT: J11.6; also elsewhere on the board
/CONTROLE DO DRIVER/DRV_MODE_B_OUT: J11.8; also elsewhere on the board
/CONTROLE DO DRIVER/DRV_REVERSE_SW_A: J11.4; also elsewhere on the board
/CONTROLE DO DRIVER/DRV_REVERSE_SW_B: J11.2; also elsewhere on the board
/CONTROLE DO DRIVER/DRV_THROTTLE_OUT: J11.7; also elsewhere on the board
/ESP32-S3-MESTRE/BUZZER_CMD: R12.2; also elsewhere on the board
/ESP32-S3-MESTRE/ENC1_A: J9.8, R10.1; also elsewhere on the board
/ESP32-S3-MESTRE/ENC1_B: J9.6, R9.1; also elsewhere on the board
/ESP32-S3-MESTRE/ENC2_A: J9.4, R8.1; also elsewhere on the board
/ESP32-S3-MESTRE/ENC2_B: J9.2, R7.1; also elsewhere on the board
/ESP32-S3-MESTRE/GEAR_SEL_A: J8.6; also elsewhere on the board
/ESP32-S3-MESTRE/GEAR_SEL_B: J8.8; also elsewhere on the board
/ESP32-S3-MESTRE/LED_BLUE_CMD: J10.2; also elsewhere on the board
/ESP32-S3-MESTRE/LED_GREEN_CMD: J10.4; also elsewhere on the board
/ESP32-S3-MESTRE/LED_RED_CMD: J10.6; also elsewhere on the board
/ESP32-S3-MESTRE/REVERSE_SEL: J8.5; also elsewhere on the board
/ESP32-S3-MESTRE/SD_CS: U5.2 (CS); also elsewhere on the board
/ESP32-S3-MESTRE/SD_MISO: U5.5 (MISO); also elsewhere on the board
/ESP32-S3-MESTRE/SD_MOSI: U5.3 (MOSI); also elsewhere on the board
/ESP32-S3-MESTRE/SD_SCK: U5.4 (CLK); also elsewhere on the board
/ESP32-S3-MESTRE/THROTTLE_SENSE: ACEL-DIV1.2, ACEL-DIV2.1; also elsewhere on the board
GND: ACEL-DIV2.2, Cartao_SD1.1, Cartao_SD2.1, J7.2, J8.2, J9.5, J9.7, J10.1, Q1.3 (E), R13.1, U5.6 (GND); also elsewhere on the board
I2C_SCL: J7.3, J8.9, J10.8, R5.1; also elsewhere on the board
I2C_SDA: J7.4, J8.10, J10.10, R6.1; also elsewhere on the board
unnamed: BZ1.1 (+), Q1.1 (C)
unnamed: J11.3, J11.5
unnamed: Q1.2 (B), R12.1, R13.2
THROTTLE_INPUT: ACEL-DIV1.1, J8.7

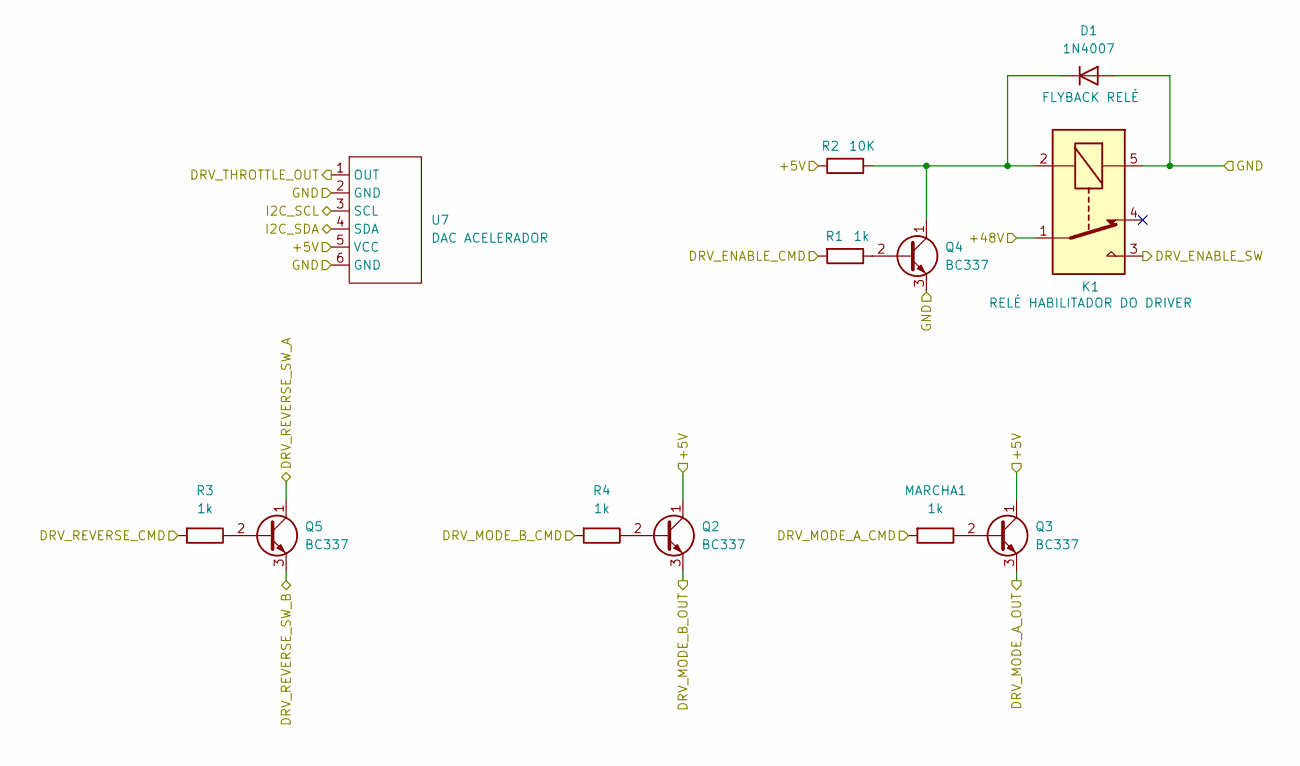
[picture p99: schematic controleDoDriver.kicad_sch, NEXUS - Controladora do Eletric Car UFSM-CS]

Parts:
D1: 1N4007; D_DO-41_SOD81_P10.16mm_Horizontal
K1: SANYOU_SRD_Form_C; Relay_SPDT_SANYOU_SRD_Series_Form_C
MARCHA1: 1k; R_Axial_DIN0204_L3.6mm_D1.6mm_P5.08mm_Horizontal
Q2, Q3, Q4, Q5: BC337; TO-92
R1, R3, R4: 1k; R_Axial_DIN0204_L3.6mm_D1.6mm_P5.08mm_Horizontal
R2: 10K; R_Axial_DIN0204_L3.6mm_D1.6mm_P5.08mm_Horizontal
U7: MCP4725

Connections:
+5V: Q2.1 (C), Q3.1 (C), R2.1, U7.5 (VCC); also elsewhere on the board
+48V: K1.1; also elsewhere on the board
/CONTROLE DO DRIVER/DRV_ENABLE_CMD: R1.2; also elsewhere on the board
/CONTROLE DO DRIVER/DRV_ENABLE_SW: K1.3; also elsewhere on the board
/CONTROLE DO DRIVER/DRV_MODE_A_CMD: MARCHA1.2; also elsewhere on the board
/CONTROLE DO DRIVER/DRV_MODE_A_OUT: Q3.3 (E); also elsewhere on the board
/CONTROLE DO DRIVER/DRV_MODE_B_CMD: R4.2; also elsewhere on the board
/CONTROLE DO DRIVER/DRV_MODE_B_OUT: Q2.3 (E); also elsewhere on the board
/CONTROLE DO DRIVER/DRV_REVERSE_CMD: R3.2; also elsewhere on the board
/CONTROLE DO DRIVER/DRV_REVERSE_SW_A: Q5.1 (C); also elsewhere on the board
/CONTROLE DO DRIVER/DRV_REVERSE_SW_B: Q5.3 (E); also elsewhere on the board
/CONTROLE DO DRIVER/DRV_THROTTLE_OUT: U7.1 (OUT); also elsewhere on the board
GND: D1.2 (A), K1.5, Q4.3 (E), U7.2 (GND), U7.6 (GND); also elsewhere on the board
I2C_SCL: U7.3 (SCL); also elsewhere on the board
I2C_SDA: U7.4 (SDA); also elsewhere on the board
unnamed: D1.1 (K), K1.2, Q4.1 (C), R2.2
unnamed: Q2.2 (B), R4.1
unnamed: MARCHA1.1, Q3.2 (B)
unnamed: Q4.2 (B), R1.1
unnamed: Q5.2 (B), R3.1

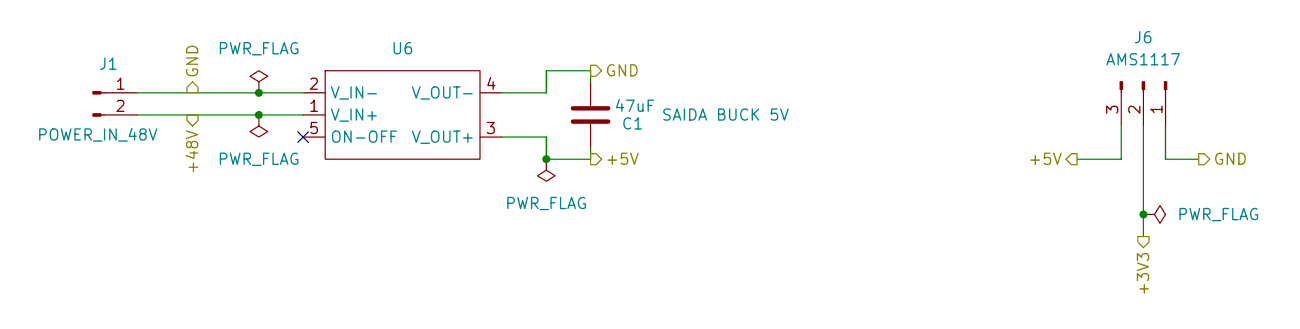
[picture p100: schematic 01_alimentacao.kicad_sch, NEXUS - Controladora do Eletric Car UFSM-CS]

Parts:
C1: 47uF; C_Radial_D5.0mm_H11.0mm_P2.00mm
J1: POWER_IN_48V; SolderWire-0.75sqmm_1x02_P4.8mm_D1.25mm_OD2.3mm
J6: AMS1117; PinHeader_1x03_P2.54mm_Vertical
U6: ConversorBUCK_100V_5V-2A

Connections:
+3V3: J6.2; also elsewhere on the board
+5V: C1.1, J6.3, U6.3 (V_OUT+); also elsewhere on the board
+48V: J1.2, U6.1 (V_IN+); also elsewhere on the board
GND: C1.2, J1.1, J6.1, U6.2 (V_IN-), U6.4 (V_OUT-); also elsewhere on the board

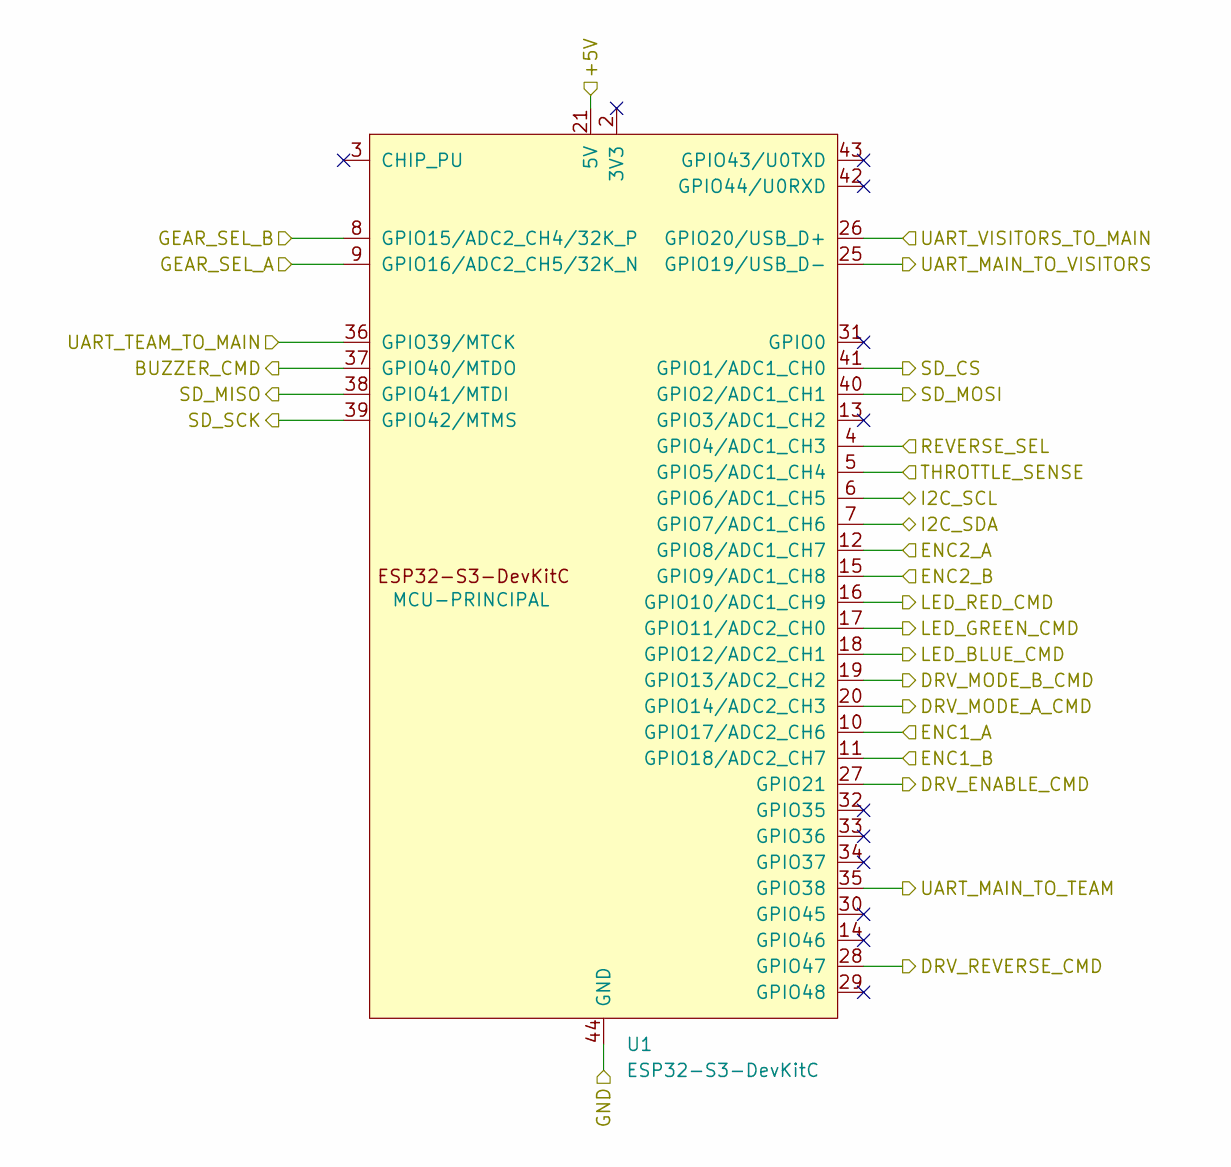
[picture p101: schematic esp32s3Mestre.kicad_sch, NEXUS - Controladora do Eletric Car UFSM-CS]

Parts:
U1: ESP32-S3-DevKitC

Connections:
+5V: U1.21 (5V); also elsewhere on the board
/COMUNICAÇÃO WI-FI/UART_MAIN_TO_TEAM: U1.36 (GPIO39/MTCK); also elsewhere on the board
/COMUNICAÇÃO WI-FI/UART_MAIN_TO_VISITORS: U1.25 (GPIO19/USB_D-); also elsewhere on the board
/COMUNICAÇÃO WI-FI/UART_TEAM_TO_MAIN: U1.35 (GPIO38); also elsewhere on the board
/COMUNICAÇÃO WI-FI/UART_VISITORS_TO_MAIN: U1.26 (GPIO20/USB_D+); also elsewhere on the board
/CONTROLE DO DRIVER/DRV_ENABLE_CMD: U1.27 (GPIO21); also elsewhere on the board
/CONTROLE DO DRIVER/DRV_MODE_A_CMD: U1.20 (GPIO14/ADC2_CH3); also elsewhere on the board
/CONTROLE DO DRIVER/DRV_MODE_B_CMD: U1.19 (GPIO13/ADC2_CH2); also elsewhere on the board
/CONTROLE DO DRIVER/DRV_REVERSE_CMD: U1.28 (GPIO47); also elsewhere on the board
/ESP32-S3-MESTRE/BUZZER_CMD: U1.37 (GPIO40/MTDO); also elsewhere on the board
/ESP32-S3-MESTRE/ENC1_A: U1.10 (GPIO17/ADC2_CH6); also elsewhere on the board
/ESP32-S3-MESTRE/ENC1_B: U1.11 (GPIO18/ADC2_CH7); also elsewhere on the board
/ESP32-S3-MESTRE/ENC2_A: U1.12 (GPIO8/ADC1_CH7); also elsewhere on the board
/ESP32-S3-MESTRE/ENC2_B: U1.15 (GPIO9/ADC1_CH8); also elsewhere on the board
/ESP32-S3-MESTRE/GEAR_SEL_A: U1.9 (GPIO16/ADC2_CH5/32K_N); also elsewhere on the board
/ESP32-S3-MESTRE/GEAR_SEL_B: U1.8 (GPIO15/ADC2_CH4/32K_P); also elsewhere on the board
/ESP32-S3-MESTRE/LED_BLUE_CMD: U1.18 (GPIO12/ADC2_CH1); also elsewhere on the board
/ESP32-S3-MESTRE/LED_GREEN_CMD: U1.17 (GPIO11/ADC2_CH0); also elsewhere on the board
/ESP32-S3-MESTRE/LED_RED_CMD: U1.16 (GPIO10/ADC1_CH9); also elsewhere on the board
/ESP32-S3-MESTRE/REVERSE_SEL: U1.4 (GPIO4/ADC1_CH3); also elsewhere on the board
/ESP32-S3-MESTRE/SD_CS: U1.41 (GPIO1/ADC1_CH0); also elsewhere on the board
/ESP32-S3-MESTRE/SD_MISO: U1.38 (GPIO41/MTDI); also elsewhere on the board
/ESP32-S3-MESTRE/SD_MOSI: U1.40 (GPIO2/ADC1_CH1); also elsewhere on the board
/ESP32-S3-MESTRE/SD_SCK: U1.39 (GPIO42/MTMS); also elsewhere on the board
/ESP32-S3-MESTRE/THROTTLE_SENSE: U1.5 (GPIO5/ADC1_CH4); also elsewhere on the board
GND: U1.22 (GND), U1.23 (GND), U1.24 (GND), U1.44 (GND); also elsewhere on the board
I2C_SCL: U1.6 (GPIO6/ADC1_CH5); also elsewhere on the board
I2C_SDA: U1.7 (GPIO7/ADC1_CH6); also elsewhere on the board

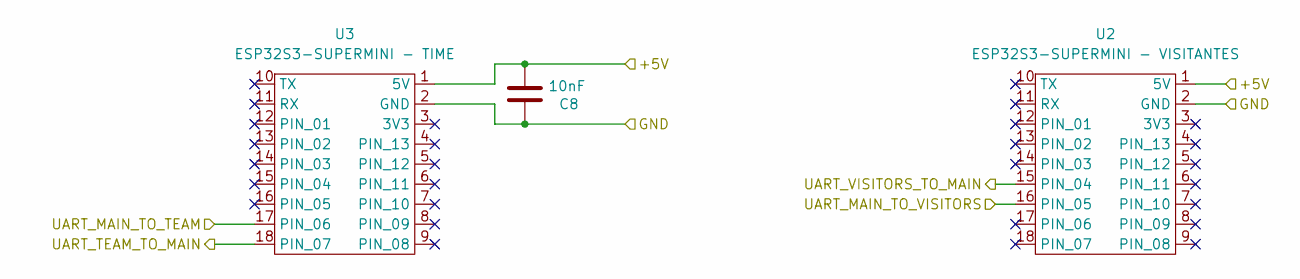
[picture p102: schematic comunicacaoWiFi.kicad_sch, NEXUS - Controladora do Eletric Car UFSM-CS]

Parts:
C8: 10nF; C_Radial_D5.0mm_H11.0mm_P2.00mm
U2: ESP32S3-SUPERMINI - VISITANTES; ESP32-S3-SuperMini
U3: ESP32S3-SUPERMINI - TIME; ESP32-S3-SuperMini

Connections:
+5V: C8.2, U2.1 (5V), U3.1 (5V); also elsewhere on the board
/COMUNICAÇÃO WI-FI/UART_MAIN_TO_TEAM: U3.17 (PIN_06); also elsewhere on the board
/COMUNICAÇÃO WI-FI/UART_MAIN_TO_VISITORS: U2.16 (PIN_05); also elsewhere on the board
/COMUNICAÇÃO WI-FI/UART_TEAM_TO_MAIN: U3.18 (PIN_07); also elsewhere on the board
/COMUNICAÇÃO WI-FI/UART_VISITORS_TO_MAIN: U2.15 (PIN_04); also elsewhere on the board
GND: C8.1, U2.2 (GND), U3.2 (GND); also elsewhere on the board

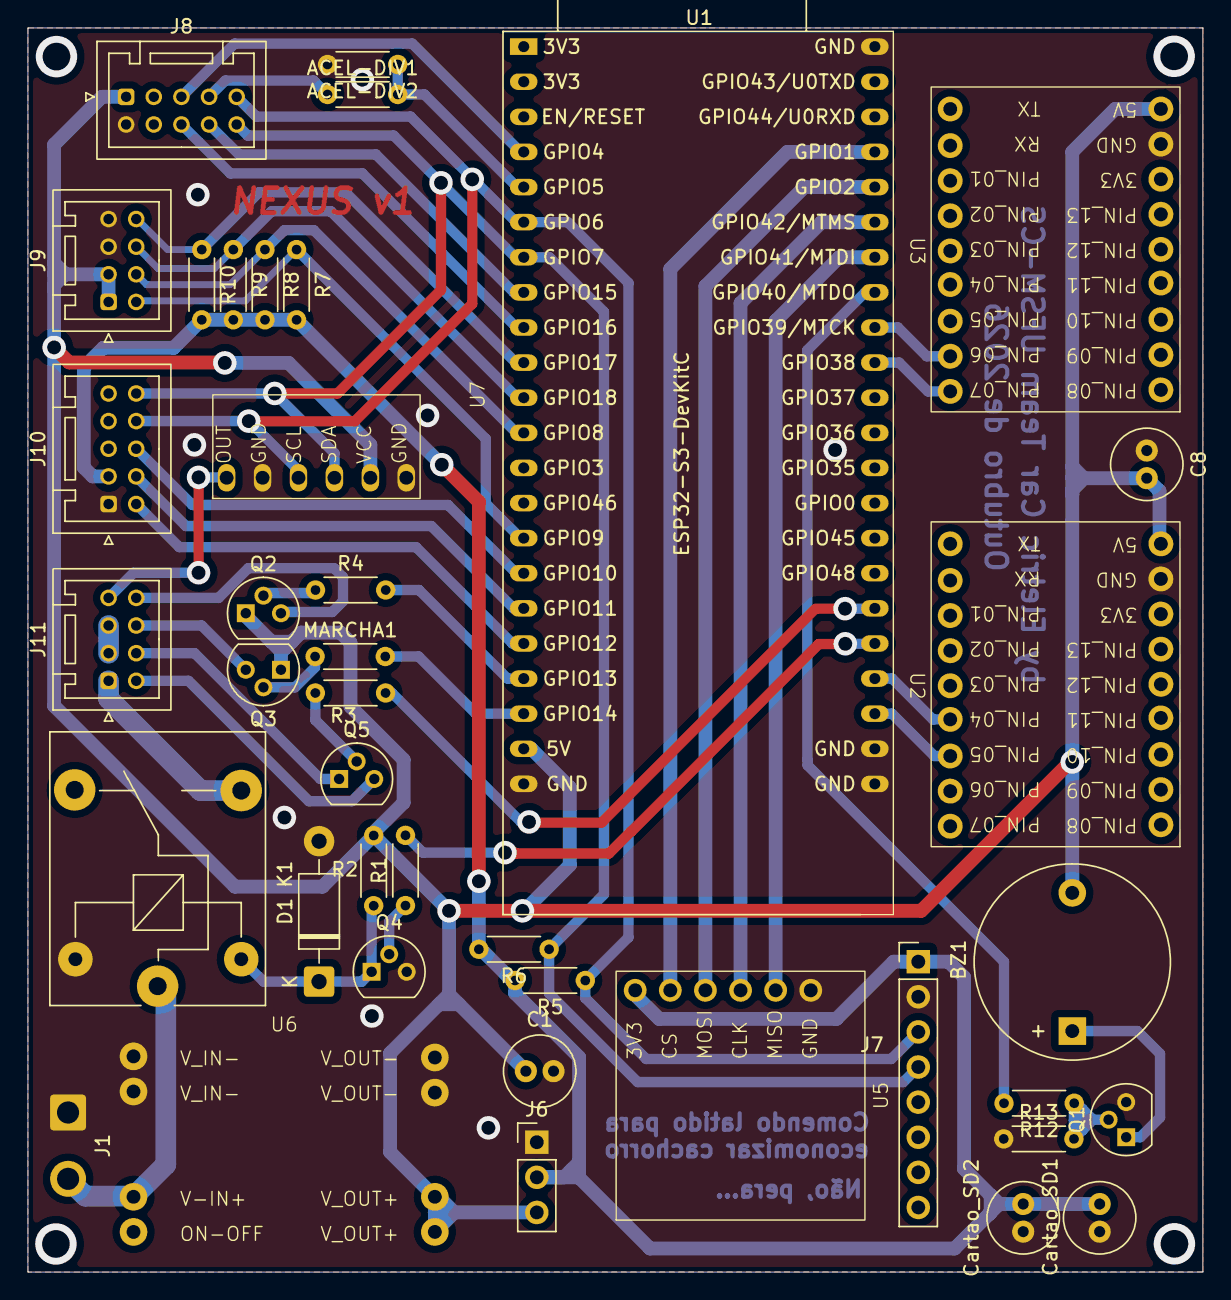
[picture p103: board KiCad_pcb_telemetria.kicad_pcb from above]

Board: 2 copper layers, 85.0 x 90.0 mm, 40 parts (0 on the bottom side), 45 nets.
