thegm-Gabriel/instrumentacao-ElectricCarUFSM/hardware/kicad/KiCad_pcb_telemetria/NEXUSv01.kicad_pcb

## KiCad design hardware/kicad/KiCad_pcb_telemetria/NEXUSv01.kicad_pcb (2026-11-07)

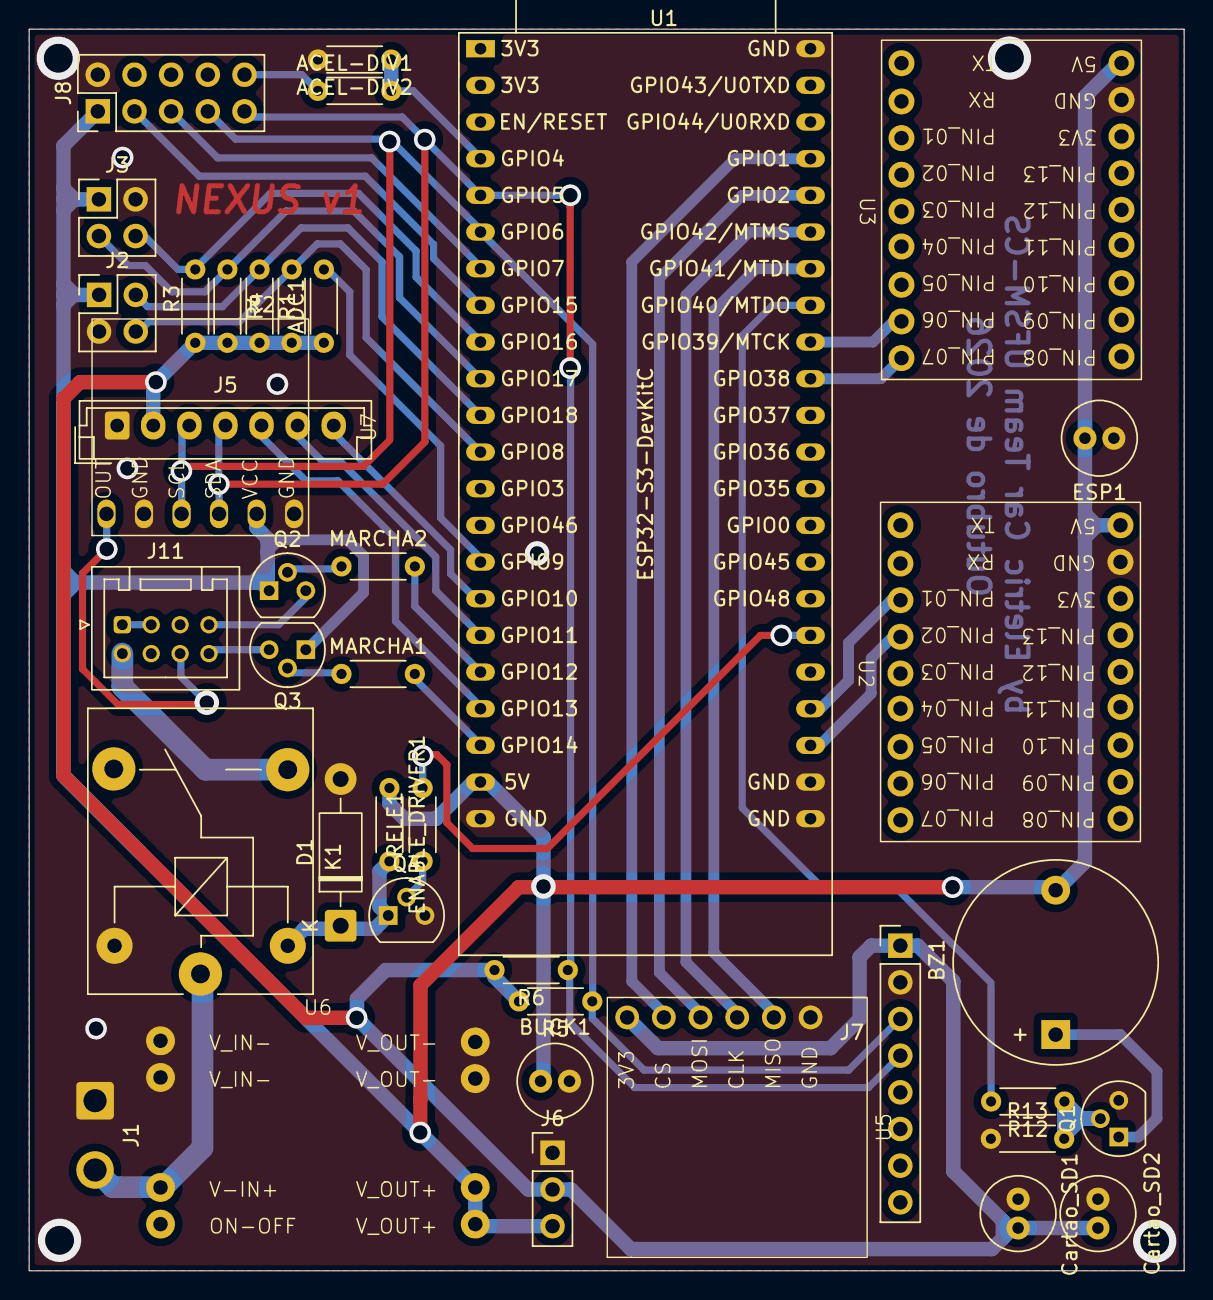
[picture p104: board NEXUSv01.kicad_pcb from above]

Board: 2 copper layers, 80.0 x 86.0 mm, 40 parts (0 on the bottom side), 41 nets.

Parts:
ACEL-DIV1, ACEL-DIV2: 10k; R_Axial_DIN0204_L3.6mm_D1.6mm_P5.08mm_Horizontal
ADC1: 10k; R_Axial_DIN0204_L3.6mm_D1.6mm_P5.08mm_Horizontal
BUCK1: 47uF; C_Radial_D5.0mm_H11.0mm_P2.00mm
BZ1: Buzzer; Buzzer_D14mm_H7mm_P10mm
Cartao_SD1: 100nF; C_Radial_D5.0mm_H11.0mm_P2.00mm
Cartao_SD2: 100uF; C_Radial_D5.0mm_H11.0mm_P2.00mm
D1: 1N4007; D_DO-41_SOD81_P10.16mm_Horizontal
ENABLE_DRIVER1: 10K; R_Axial_DIN0204_L3.6mm_D1.6mm_P5.08mm_Horizontal
ESP1: 10nF; C_Radial_D5.0mm_H11.0mm_P2.00mm
J1: ALIMENTACAO_48V; SolderWire-0.75sqmm_1x02_P4.8mm_D1.25mm_OD2.3mm
J2, J3: Conn_02x02_Odd_Even; PinHeader_2x02_P2.54mm_Vertical
J5: INDICADOR; JST_EH_B7B-EH-A_1x07_P2.50mm_Vertical
J6: AMS1117; PinHeader_1x03_P2.54mm_Vertical
J7: Acelerometro; PinHeader_1x08_P2.54mm_Vertical
J8: Conn_02x05_Odd_Even; PinHeader_2x05_P2.54mm_Vertical
J11: Conn_02x04_Odd_Even; JST_PUD_B08B-PUDSS_2x04_P2.00mm_Vertical
K1: SANYOU_SRD_Form_C; Relay_SPDT_SANYOU_SRD_Series_Form_C
MARCHA1, MARCHA2: 1k; R_Axial_DIN0204_L3.6mm_D1.6mm_P5.08mm_Horizontal
Q1, Q2, Q3, Q4: BC337; TO-92
R1, R2, R3, R4, R5, R6: 4.7k; R_Axial_DIN0204_L3.6mm_D1.6mm_P5.08mm_Horizontal
R12: 1k; R_Axial_DIN0204_L3.6mm_D1.6mm_P5.08mm_Horizontal
R13: 10K; R_Axial_DIN0204_L3.6mm_D1.6mm_P5.08mm_Horizontal
RELE1: 1k; R_Axial_DIN0204_L3.6mm_D1.6mm_P5.08mm_Horizontal
U1: ESP32-S3-DevKitC
U2: ESP32S3-SUPERMINI - VISITANTES; ESP32-S3-SuperMini
U3: ESP32S3-SUPERMINI - TIME; ESP32-S3-SuperMini
U5: CartãoSD-MODULO
U6: ConversorBUCK_100V_5V-2A
U7: MCP4725

Connections:
+3V3: ADC1.1, Cartao_SD1.2, Cartao_SD2.2, J5.2, J6.2, J7.1, R1.2, R2.2, R3.2, R4.2, R5.2, R6.2, U5.1 (3V3)
+5V: BUCK1.1, BZ1.2 (-), ENABLE_DRIVER1.1, ESP1.2, J2.1, J3.1, J6.3, J8.1, Q2.1 (C), Q3.1 (C), U1.21 (5V), U2.1 (5V), U3.1 (5V), U6.3 (V_OUT+), U7.5 (VCC)
+48V: J1.2, K1.1, U6.1 (V_IN+)
AFERIR_TENSAO_3V3: ADC1.2, U1.15 (GPIO9/ADC1_CH8)
ENABLE_DRIVER: J11.2, K1.3
GND: ACEL-DIV2.2, BUCK1.2, Cartao_SD1.1, Cartao_SD2.1, D1.2 (A), ESP1.1, J1.1, J2.3, J3.2, J5.1, J6.1, J7.2, J8.2, K1.5, Q1.3 (E), Q4.3 (E), R13.1, U1.22 (GND), U1.23 (GND), U1.24 (GND), U1.44 (GND), U2.2 (GND), U3.2 (GND), U5.6 (GND), U6.2 (V_IN-), U6.4 (V_OUT-), U7.2 (GND), U7.6 (GND)
MARCHA-A: J8.3, U1.8 (GPIO15/ADC2_CH4/32K_P)
MARCHA-A-OUT: MARCHA1.2, U1.20 (GPIO14/ADC2_CH3)
MARCHA-A-conector: J11.8, Q3.3 (E)
MARCHA-B: J8.5, U1.7 (GPIO7/ADC1_CH6)
MARCHA-B-OUT: MARCHA2.2, U1.18 (GPIO12/ADC2_CH1)
MARCHA-B-conector: J11.7, Q2.3 (E)
unnamed: BZ1.1 (+), Q1.1 (C)
unnamed: D1.1 (K), ENABLE_DRIVER1.2, K1.2, Q4.1 (C)
unnamed: J11.1, J11.3
unnamed: Q1.2 (B), R12.1, R13.2
unnamed: MARCHA2.1, Q2.2 (B)
unnamed: MARCHA1.1, Q3.2 (B)
unnamed: Q4.2 (B), RELE1.1
S3MESTRE-ENABLE_DRIVER: RELE1.2, U1.28 (GPIO47)
S3MESTRE-GPIO4-ENCODER01_A: J3.4, R3.1, U1.9 (GPIO16/ADC2_CH5/32K_N)
S3MESTRE-GPIO5-ENCODER01_B: J3.3, R4.1, U1.10 (GPIO17/ADC2_CH6)
S3MESTRE-GPIO6-ENCODER02_A: J2.2, R1.1, U1.11 (GPIO18/ADC2_CH7)
S3MESTRE-GPIO7-ENCODER02_B: J2.4, R2.1, U1.12 (GPIO8/ADC1_CH7)
S3MESTRE-GPIO8-I2C_SDA: J5.4, J7.4, J8.9, R6.1, U1.5 (GPIO5/ADC1_CH4), U7.4 (SDA)
S3MESTRE-GPIO9-I2C_SCL: J5.3, J7.3, J8.7, R5.1, U1.6 (GPIO6/ADC1_CH5), U7.3 (SCL)
S3MESTRE-GPIO10-LED_VERDE: J5.6, U1.17 (GPIO11/ADC2_CH0)
S3MESTRE-GPIO12-LED_VERMELHO: J5.7, U1.16 (GPIO10/ADC1_CH9)
S3MESTRE-GPIO13-LED_AZUL: J5.5, U1.19 (GPIO13/ADC2_CH2)
S3MESTRE-GPIO14-BUZZER: R12.2, U1.37 (GPIO40/MTDO)
S3MESTRE-GPIO15-SD_CS: U1.41 (GPIO1/ADC1_CH0), U5.2 (CS)
S3MESTRE-GPIO16-SD_MOSI: U1.40 (GPIO2/ADC1_CH1), U5.3 (MOSI)
S3MESTRE-GPIO17-SD_SCK: U1.39 (GPIO42/MTMS), U5.4 (CLK)
S3MESTRE-GPIO18-SD_MISO: U1.38 (GPIO41/MTDI), U5.5 (MISO)
S3MESTRE-GPIO39-TX_VISITANTES: U1.25 (GPIO19/USB_D-), U2.13 (PIN_02)
S3MESTRE-GPIO40-RX_VISITANTES: U1.26 (GPIO20/USB_D+), U2.12 (PIN_01)
S3MESTRE-GPIO41-TX_EQUIPE: U1.35 (GPIO38), U3.18 (PIN_07)
S3MESTRE-GPIO42-RX_EQUIPE: U1.36 (GPIO39/MTCK), U3.17 (PIN_06)
SGN_ACEL: ACEL-DIV1.2, ACEL-DIV2.1, U1.4 (GPIO4/ADC1_CH3)
SGN_ACEL_CONECTOR: ACEL-DIV1.1, J8.10
SINAL-DAC-ACELERADOR: J11.6, U7.1 (OUT)
