thegm-Gabriel/instrumentacao-ElectricCarUFSM/hardware/kicad/KiCad_pcb_telemetria/PLACA_MODELO_pcb.kicad_pcb

## KiCad design hardware/kicad/KiCad_pcb_telemetria/PLACA_MODELO_pcb.kicad_pcb (2026-10-11)

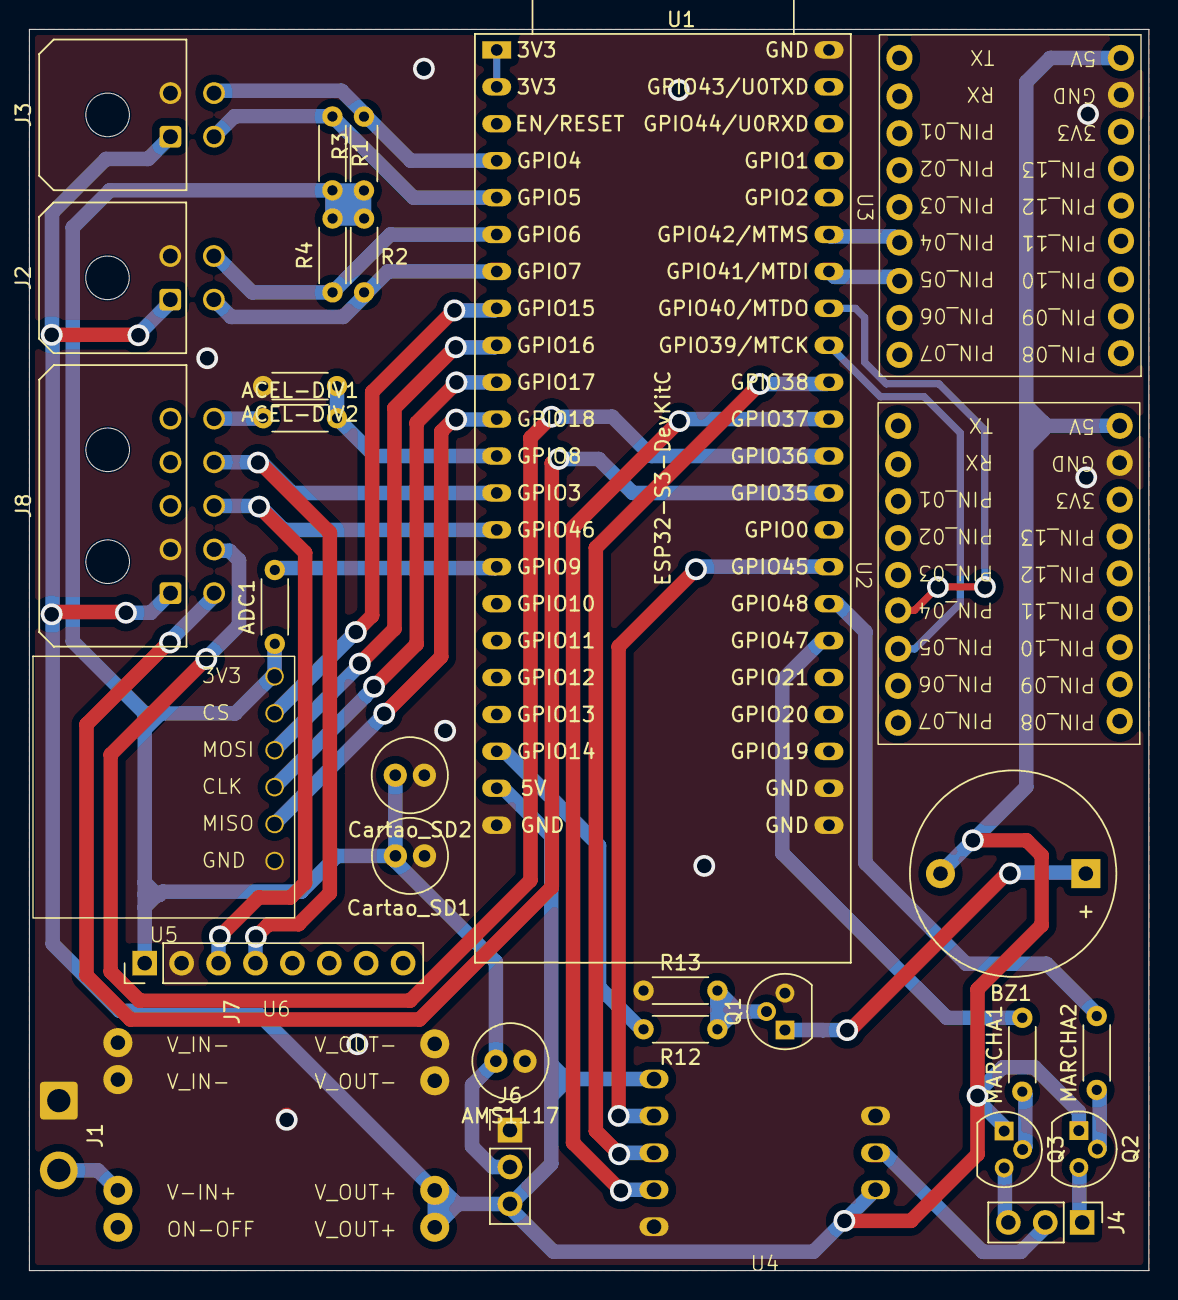
[picture p105: board PLACA_MODELO_pcb.kicad_pcb from above]

Board: 2 copper layers, 77.0 x 85.4 mm, 31 parts (0 on the bottom side), 37 nets.

Parts:
ACEL-DIV1, ACEL-DIV2: 10k; R_Axial_DIN0204_L3.6mm_D1.6mm_P5.08mm_Horizontal
ADC1: 10k; R_Axial_DIN0204_L3.6mm_D1.6mm_P5.08mm_Horizontal
AMS1117: 10uF; C_Radial_D5.0mm_H11.0mm_P2.00mm
BZ1: Buzzer; Buzzer_D14mm_H7mm_P10mm
Cartao_SD1: 100nF; C_Radial_D5.0mm_H11.0mm_P2.00mm
Cartao_SD2: 100uF; C_Radial_D5.0mm_H11.0mm_P2.00mm
J1: ALIMENTACAO_48V; SolderWire-0.75sqmm_1x02_P4.8mm_D1.25mm_OD2.3mm
J2, J3: Conn_02x02_Odd_Even; Molex_Micro-Fit_3.0_43045-0400_2x02_P3.00mm_Horizontal
J4: Conn_01x03_Pin; PinHeader_1x03_P2.54mm_Vertical
J6: AMS1117; PinHeader_1x03_P2.54mm_Vertical
J7: Acelerometro; PinHeader_1x08_P2.54mm_Vertical
J8: Conn_02x05_Odd_Even; Molex_Micro-Fit_3.0_43045-1000_2x05_P3.00mm_Horizontal
MARCHA1, MARCHA2: 1k; R_Axial_DIN0204_L3.6mm_D1.6mm_P5.08mm_Horizontal
Q1, Q2, Q3: BC337; TO-92
R1, R2, R3, R4: 4.7k; R_Axial_DIN0204_L3.6mm_D1.6mm_P5.08mm_Horizontal
R12: 1k; R_Axial_DIN0204_L3.6mm_D1.6mm_P5.08mm_Horizontal
R13: 10K; R_Axial_DIN0204_L3.6mm_D1.6mm_P5.08mm_Horizontal
U1: ESP32-S3-DevKitC
U2: ESP32S3-SUPERMINI - VISITANTES; ESP32-S3-SuperMini
U3: ESP32S3-SUPERMINI - TIME; ESP32-S3-SuperMini
U4: X9C103S
U5: CartãoSD-MODULO
U6: ConversorBUCK_100V_5V-2A

Connections:
+3V3: ADC1.1, AMS1117.2, Cartao_SD1.2, Cartao_SD2.2, J6.2, J7.1, R1.2, R2.2, R3.2, R4.2, U5.1 (3V3)
+5V: BZ1.2 (-), J2.1, J3.1, J6.3, J8.1, Q2.1 (C), Q3.1 (C), U1.21 (5V), U2.1 (5V), U3.1 (5V), U4.5 (VCC), U4.6 (VH), U6.3 (V_OUT+)
CS: U1.30 (GPIO45), U4.4 (CS)
GND: ACEL-DIV2.2, AMS1117.1, Cartao_SD1.1, Cartao_SD2.1, J1.1, J2.2, J3.2, J6.1, J7.2, J8.2, Q1.3 (E), R13.1, U1.22 (GND), U1.23 (GND), U1.24 (GND), U1.44 (GND), U2.2 (GND), U3.2 (GND), U4.1 (GND), U4.8 (VL), U5.6 (GND), U6.2 (V_IN-), U6.4 (V_OUT-)
INC: U1.35 (GPIO38), U4.3 (INC)
MARCHA-A: J8.6, U1.32 (GPIO35)
MARCHA-A-OUT: MARCHA1.2, U1.28 (GPIO47)
MARCHA-A-conector: J4.3, Q3.3 (E)
MARCHA-B: J8.7, U1.33 (GPIO36)
MARCHA-B-OUT: MARCHA2.2, U1.29 (GPIO48)
MARCHA-B-conector: J4.1, Q2.3 (E)
unnamed: BZ1.1 (+), Q1.1 (C)
unnamed: J1.2, U6.1 (V_IN+)
unnamed: J4.2, U4.7 (W)
unnamed: Q1.2 (B), R12.1, R13.2
unnamed: MARCHA2.1, Q2.2 (B)
unnamed: MARCHA1.1, Q3.2 (B)
unnamed: U1.1 (3V3), U1.2 (3V3)
S3MESTRE-GPIO4-ENCODER01_A: J3.4, R3.1, U1.4 (GPIO4/ADC1_CH3)
S3MESTRE-GPIO5-ENCODER01_B: J2.4, R4.1, U1.6 (GPIO6/ADC1_CH5)
S3MESTRE-GPIO6-ENCODER02_A: J3.3, R1.1, U1.5 (GPIO5/ADC1_CH4)
S3MESTRE-GPIO7-ENCODER02_B: J2.3, R2.1, U1.7 (GPIO7/ADC1_CH6)
S3MESTRE-GPIO8-I2C_SDA: J7.4, J8.9, U1.13 (GPIO3/ADC1_CH2)
S3MESTRE-GPIO9: ADC1.2, U1.15 (GPIO9/ADC1_CH8)
S3MESTRE-GPIO9-I2C_SCL: J7.3, J8.8, U1.14 (GPIO46)
S3MESTRE-GPIO14-BUZZER: R12.2, U1.20 (GPIO14/ADC2_CH3)
S3MESTRE-GPIO15-SD_CS: U1.8 (GPIO15/ADC2_CH4/32K_P), U5.2 (CS)
S3MESTRE-GPIO16-SD_MOSI: U1.9 (GPIO16/ADC2_CH5/32K_N), U5.3 (MOSI)
S3MESTRE-GPIO17-SD_SCK: U1.10 (GPIO17/ADC2_CH6), U5.4 (CLK)
S3MESTRE-GPIO18-SD_MISO: U1.11 (GPIO18/ADC2_CH7), U5.5 (MISO)
S3MESTRE-GPIO39-TX_VISITANTES: U1.36 (GPIO39/MTCK), U2.16 (PIN_05)
S3MESTRE-GPIO40-RX_VISITANTES: U1.37 (GPIO40/MTDO), U2.15 (PIN_04)
S3MESTRE-GPIO41-TX_EQUIPE: U1.38 (GPIO41/MTDI), U3.16 (PIN_05)
S3MESTRE-GPIO42-RX_EQUIPE: U1.39 (GPIO42/MTMS), U3.15 (PIN_04)
SGN_ACEL: ACEL-DIV1.2, ACEL-DIV2.1, U1.12 (GPIO8/ADC1_CH7)
SGN_ACEL_CONECTOR: ACEL-DIV1.1, J8.10
U/D: U1.34 (GPIO37), U4.2 (U/D)
