thegm-Gabriel/instrumentacao-ElectricCarUFSM/hardware/kicad/KiCad_pcb_telemetria/PLACAV1.kicad_pcb

## KiCad design hardware/kicad/KiCad_pcb_telemetria/PLACAV1.kicad_pcb (2026-10-11)

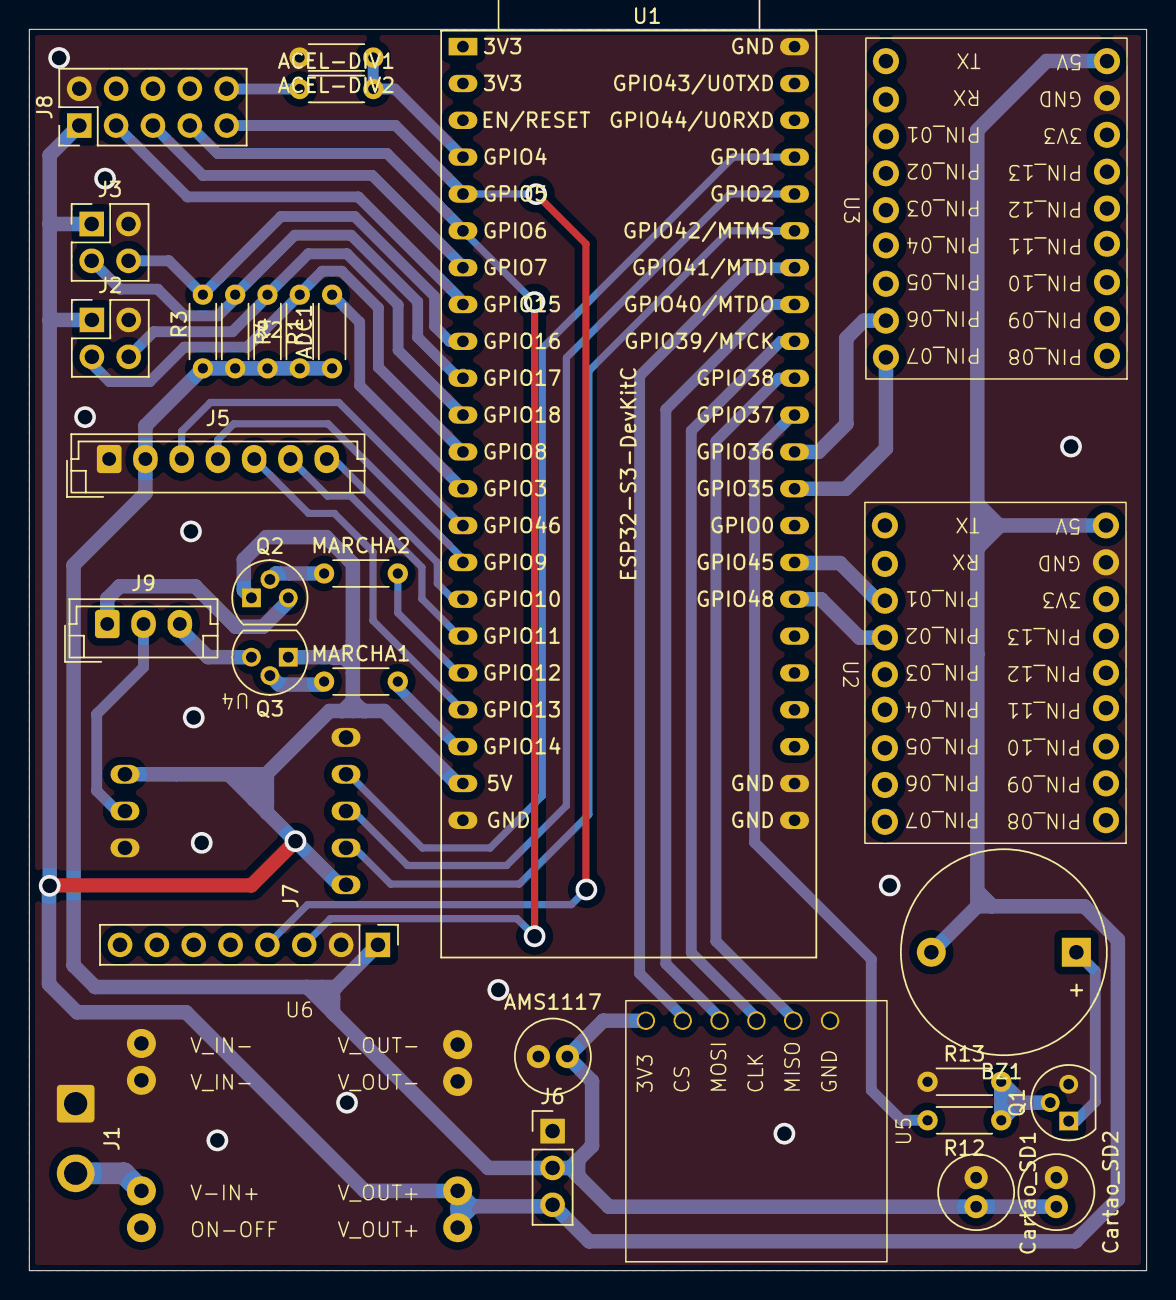
[picture p106: board PLACAV1.kicad_pcb from above]

Board: 2 copper layers, 77.0 x 85.6 mm, 32 parts (0 on the bottom side), 41 nets.

Parts:
ACEL-DIV1, ACEL-DIV2: 10k; R_Axial_DIN0204_L3.6mm_D1.6mm_P5.08mm_Horizontal
ADC1: 10k; R_Axial_DIN0204_L3.6mm_D1.6mm_P5.08mm_Horizontal
AMS1117: 10uF; C_Radial_D5.0mm_H11.0mm_P2.00mm
BZ1: Buzzer; Buzzer_D14mm_H7mm_P10mm
Cartao_SD1: 100nF; C_Radial_D5.0mm_H11.0mm_P2.00mm
Cartao_SD2: 100uF; C_Radial_D5.0mm_H11.0mm_P2.00mm
J1: ALIMENTACAO_48V; SolderWire-0.75sqmm_1x02_P4.8mm_D1.25mm_OD2.3mm
J2, J3: Conn_02x02_Odd_Even; PinHeader_2x02_P2.54mm_Vertical
J5: INDICADOR; JST_EH_B7B-EH-A_1x07_P2.50mm_Vertical
J6: AMS1117; PinHeader_1x03_P2.54mm_Vertical
J7: Acelerometro; PinHeader_1x08_P2.54mm_Vertical
J8: Conn_02x05_Odd_Even; PinHeader_2x05_P2.54mm_Vertical
J9: DRIVER; JST_EH_B3B-EH-A_1x03_P2.50mm_Vertical
MARCHA1, MARCHA2: 1k; R_Axial_DIN0204_L3.6mm_D1.6mm_P5.08mm_Horizontal
Q1, Q2, Q3: BC337; TO-92
R1, R2, R3, R4: 4.7k; R_Axial_DIN0204_L3.6mm_D1.6mm_P5.08mm_Horizontal
R12: 1k; R_Axial_DIN0204_L3.6mm_D1.6mm_P5.08mm_Horizontal
R13: 10K; R_Axial_DIN0204_L3.6mm_D1.6mm_P5.08mm_Horizontal
U1: ESP32-S3-DevKitC
U2: ESP32S3-SUPERMINI - VISITANTES; ESP32-S3-SuperMini
U3: ESP32S3-SUPERMINI - TIME; ESP32-S3-SuperMini
U4: X9C103S
U5: CartãoSD-MODULO
U6: ConversorBUCK_100V_5V-2A

Connections:
+3V3: ADC1.1, AMS1117.2, Cartao_SD1.2, Cartao_SD2.2, J5.2, J6.2, J7.1, R1.2, R2.2, R3.2, R4.2, U5.1 (3V3)
+5V: BZ1.2 (-), J2.1, J3.1, J6.3, J8.1, Q2.1 (C), Q3.1 (C), U1.21 (5V), U2.1 (5V), U3.1 (5V), U4.5 (VCC), U4.6 (VH), U6.3 (V_OUT+)
CS: U1.39 (GPIO42/MTMS), U4.4 (CS)
GND: ACEL-DIV2.2, AMS1117.1, Cartao_SD1.1, Cartao_SD2.1, J1.1, J2.2, J3.2, J5.1, J6.1, J7.2, J8.2, Q1.3 (E), R13.1, U1.22 (GND), U1.23 (GND), U1.24 (GND), U1.44 (GND), U2.2 (GND), U3.2 (GND), U4.1 (GND), U4.8 (VL), U5.6 (GND), U6.2 (V_IN-), U6.4 (V_OUT-)
INC: U1.40 (GPIO2/ADC1_CH1), U4.3 (INC)
MARCHA-A: J8.3, U1.8 (GPIO15/ADC2_CH4/32K_P)
MARCHA-A-OUT: MARCHA1.2, U1.20 (GPIO14/ADC2_CH3)
MARCHA-A-conector: J9.3, Q3.3 (E)
MARCHA-B: J8.5, U1.7 (GPIO7/ADC1_CH6)
MARCHA-B-OUT: MARCHA2.2, U1.18 (GPIO12/ADC2_CH1)
MARCHA-B-conector: J9.1, Q2.3 (E)
unnamed: BZ1.1 (+), Q1.1 (C)
unnamed: J1.2, U6.1 (V_IN+)
unnamed: J9.2, U4.7 (W)
unnamed: Q1.2 (B), R12.1, R13.2
unnamed: MARCHA2.1, Q2.2 (B)
unnamed: MARCHA1.1, Q3.2 (B)
S3MESTRE-GPIO4-ENCODER01_A: J3.4, R3.1, U1.9 (GPIO16/ADC2_CH5/32K_N)
S3MESTRE-GPIO5-ENCODER01_B: J3.3, R4.1, U1.10 (GPIO17/ADC2_CH6)
S3MESTRE-GPIO6-ENCODER02_A: J2.4, R1.1, U1.11 (GPIO18/ADC2_CH7)
S3MESTRE-GPIO7-ENCODER02_B: J2.3, R2.1, U1.12 (GPIO8/ADC1_CH7)
S3MESTRE-GPIO8-I2C_SDA: J7.4, J8.9, U1.5 (GPIO5/ADC1_CH4)
S3MESTRE-GPIO9: ADC1.2, U1.13 (GPIO3/ADC1_CH2)
S3MESTRE-GPIO9-I2C_SCL: J7.3, J8.7, U1.6 (GPIO6/ADC1_CH5)
S3MESTRE-GPIO10-LED_VERDE: J5.6, U1.17 (GPIO11/ADC2_CH0)
S3MESTRE-GPIO12-LED_VERMELHO: J5.7, U1.16 (GPIO10/ADC1_CH9)
S3MESTRE-GPIO13-LED_AZUL: J5.5, U1.19 (GPIO13/ADC2_CH2)
S3MESTRE-GPIO14-BUZZER: R12.2, U1.34 (GPIO37)
S3MESTRE-GPIO15-SD_CS: U1.38 (GPIO41/MTDI), U5.2 (CS)
S3MESTRE-GPIO16-SD_MOSI: U1.37 (GPIO40/MTDO), U5.3 (MOSI)
S3MESTRE-GPIO17-SD_SCK: U1.36 (GPIO39/MTCK), U5.4 (CLK)
S3MESTRE-GPIO18-SD_MISO: U1.35 (GPIO38), U5.5 (MISO)
S3MESTRE-GPIO39-TX_VISITANTES: U1.29 (GPIO48), U2.13 (PIN_02)
S3MESTRE-GPIO40-RX_VISITANTES: U1.30 (GPIO45), U2.12 (PIN_01)
S3MESTRE-GPIO41-TX_EQUIPE: U1.32 (GPIO35), U3.18 (PIN_07)
S3MESTRE-GPIO42-RX_EQUIPE: U1.33 (GPIO36), U3.17 (PIN_06)
S3MESTRE-I2C_SCL-TELA: J5.4, U1.15 (GPIO9/ADC1_CH8)
S3MESTRE-I2C_SDA-TELA: J5.3, U1.14 (GPIO46)
SGN_ACEL: ACEL-DIV1.2, ACEL-DIV2.1, U1.4 (GPIO4/ADC1_CH3)
SGN_ACEL_CONECTOR: ACEL-DIV1.1, J8.10
U/D: U1.41 (GPIO1/ADC1_CH0), U4.2 (U/D)
