thegm-Gabriel/instrumentacao-ElectricCarUFSM/firmware/compartilhado/telemetria/dados_sensores.h

// Reúne os tipos compartilhados das leituras brutas dos sensores.
#pragma once

#include "dados_telemetria_veiculo.h"

/* Compatibilidade temporaria para codigo externo que ainda usa o nome antigo. */
using DadosSensores = DadosTelemetriaVeiculo;
