thegm-Gabriel/instrumentacao-ElectricCarUFSM/firmware/mestre-s3/src/servicos/servico_terminal.cpp

// Implementa o menu serial interativo de operação e diagnóstico.
#include "nucleo/configuracao_tarefas.h"
#include "servicos/servico_terminal.h"

#include <cerrno>
#include <cstdio>
#include <cstdlib>
#include <cstring>
#include <fcntl.h>
#include <unistd.h>

#include "esp_log.h"
#include "esp_timer.h"
#include "freertos/FreeRTOS.h"
#include "freertos/task.h"
#include "gerenciadores/gerenciador_i2c.h"
#include "dispositivos/ina228.h"
#include "nucleo/configuracao_placa.h"
#include "servicos/servico_aceleracao.h"
#include "servicos/servico_comandos.h"
#include "servicos/servico_controle_sensores.h"
#include "servicos/servico_diagnostico.h"
#include "servicos/servico_gravador_audio_treinamento.h"
#include "servicos/servico_odometro.h"
#include "servicos/servico_ota.h"
#include "servicos/servico_registro_telemetria.h"
#include "servicos/servico_relatorios.h"
#include "servicos/servico_simulador_telemetria.h"
#include "servicos/servico_telemetria.h"
#include "servicos/servico_wifi.h"

namespace {
constexpr char ETIQUETA[] = "terminal";
constexpr size_t TAMANHO_MAXIMO_LINHA = 96;
bool iniciado = false;

enum class TelaTerminal : uint8_t {
    Principal,
    Logs,
    Sensores,
    ControleSensores,
    SensorAdc,
    SensorMpu6050,
    SensorEncoders,
    SensorI2c,
    SensorIna228,
    Ota,
    OtaIntervalo,
    OtaIntervaloTelemetria,
    Intervalos,
    EscolherIntervalo,
    ComandosSatelites,
    AudioTreinamentoNome,
    AudioTreinamentoDuracao,
    Wifi,
    WifiNovaSsid,
    WifiNovaSenha,
    WifiNovaConfirmarConexao,
    WifiNovaConfirmarSalvar,
    WifiEscolherConexao,
    WifiConfirmarConexao,
    WifiEscolherExclusao,
    WifiConfirmarExclusao,
    WifiEscolherAutomatico,
    WifiSenhaAutomatico,
    WifiSenhaPrincipal,
    WifiPrincipalSsid,
    WifiPrincipalSenha,
    WifiPrincipalConfirmar,
    WifiSenhaRestaurar,
    WifiRestaurarConfirmar,
    WifiPolitica,
    WifiPoliticaValor,
    WifiSenhaPolitica,
};

enum class CampoPoliticaWifi : uint8_t {
    Tentativas,
    TempoTentativa,
    IntervaloTentativas,
    TempoSessao,
    RestaurarPadroes,
};

struct OpcaoMenu {
    uint8_t numero;
    const char* descricao;
};

using TratadorOpcao = void (*)(unsigned long opcao);

struct RotaTerminal {
    TelaTerminal tela;
    TratadorOpcao tratar;
};

enum class ResultadoLeituraLinha : uint8_t {
    Concluida,
    LongaDemais,
};

constexpr OpcaoMenu OPCOES_PRINCIPAL_MONITORAMENTO[] = {
    {1, "Mostrar resumo completo agora"},
    {11, "Ver estado rápido do sistema"},
    {3, "Configurar intervalos dos relatórios"},
    {4, "Pausar ou retomar relatórios periódicos"},
    {7, "Sensores e diagnóstico"},
};

constexpr OpcaoMenu OPCOES_PRINCIPAL_CONECTIVIDADE[] = {
    {2, "Atualização OTA"},
    {5, "Redes Wi-Fi"},
    {6, "Consultar satélites"},
    {8, "Enviar telemetria pendente ao Google"},
};

constexpr OpcaoMenu OPCOES_PRINCIPAL_FERRAMENTAS[] = {
    {9, "Gravar áudio WAV para treinamento de IA (temporário)"},
    {10, "Avisos, logs e aparência do terminal"},
};

struct FonteLogTerminal {
    const char* nome;
    const char* etiqueta;
    esp_log_level_t nivel;
};

FonteLogTerminal fontes_log[] = {
    {"Wi-Fi", "servico_wifi", ESP_LOG_INFO},
    {"Rádio Wi-Fi", "gerenciador_wifi", ESP_LOG_INFO},
    {"OTA", "servico_ota", ESP_LOG_INFO},
    {"Transporte OTA", "ota_uart", ESP_LOG_INFO},
    {"Google e SD", "registro_telemetria", ESP_LOG_INFO},
    {"Telemetria", "servico_telemetria", ESP_LOG_INFO},
    {"Sensores", "diagnostico", ESP_LOG_INFO},
    {"Comunicação UART", "enlace_satelites", ESP_LOG_INFO},
    {"Comandos", "servico_comandos", ESP_LOG_INFO},
    {"Supervisão", "supervisao", ESP_LOG_INFO},
    {"Sinalização", "sinalizacao", ESP_LOG_INFO},
    {"Relatórios", "relatorios", ESP_LOG_INFO},
    {"Cartão SD", "gerenciador_sd", ESP_LOG_INFO},
    {"Odômetro", "servico_odometro", ESP_LOG_INFO},
    {"Aceleração", "servico_aceleracao", ESP_LOG_INFO},
    {"I²C", "gerenciador_i2c", ESP_LOG_INFO},
    {"Simulador", "simulador_telemetria", ESP_LOG_INFO},
    {"Terminal", "terminal", ESP_LOG_INFO},
};
bool terminal_cores = true;
esp_log_level_t nivel_global_logs = ESP_LOG_INFO;

const char* nome_nivel_log(esp_log_level_t nivel) {
    switch (nivel) {
        case ESP_LOG_NONE: return "silenciado";
        case ESP_LOG_ERROR: return "erros";
        case ESP_LOG_WARN: return "avisos";
        default: return "informações";
    }
}

constexpr OpcaoMenu OPCOES_SATELITES[] = {
    {1, "Ping do satélite da equipe"},
    {2, "Ping do satélite de visitantes"},
    {3, "Versão do satélite da equipe"},
    {4, "Versão do satélite de visitantes"},
};

constexpr OpcaoMenu OPCOES_OTA[] = {
    {1, "Atualizar o estado exibido"},
    {2, "Verificar nova versão agora"},
    {3, "Autorizar atualização do mestre"},
    {4, "Autorizar atualização do satélite da equipe"},
    {5, "Autorizar atualização do satélite de visitantes"},
    {6, "Atualizar todos: satélites e depois mestre"},
    {7, "Cancelar atualizações pendentes"},
    {8, "Alterar intervalo das verificações"},
    {9, "Alterar intervalo da telemetria durante OTA"},
};

TelaTerminal tela_atual = TelaTerminal::Principal;
GrupoRelatorio grupo_em_edicao = GrupoRelatorio::Telemetria;
struct ContextoWifiTerminal {
    char ssid[33]{};
    char senha[64]{};
    char permissao[64]{};
    size_t indice_rede = 0;
    bool automatico = false;
    PoliticaConexaoWifi politica{};
    CampoPoliticaWifi campo_politica = CampoPoliticaWifi::Tentativas;
};

ContextoWifiTerminal contexto_wifi{};
struct ContextoAudioTreinamentoTerminal {
    char nome[TAMANHO_MAXIMO_LINHA]{};
};

ContextoAudioTreinamentoTerminal contexto_audio{};
int caractere_pendente = EOF;
bool entrada_console_nao_bloqueante = false;

template <size_t Quantidade>
void imprimir_opcoes(const OpcaoMenu (&opcoes)[Quantidade],
                     const char* recuo = "  ") {
    for (const OpcaoMenu& opcao : opcoes) {
        std::printf("%s[%u] %s\r\n", recuo,
                    static_cast<unsigned>(opcao.numero), opcao.descricao);
    }
}

void imprimir_prompt(const char* orientacao, const char* rotulo = "comando") {
    if (orientacao != nullptr && orientacao[0] != '\0') {
        std::printf("\r\n  %s", orientacao);
    }
    std::printf("\r\n  %s > ", rotulo);
    std::fflush(stdout);
}

void imprimir_rodape_monitor_sensor() {
    std::printf("\r\n  Atualização automática a cada %lu ms | [Enter] Voltar aos sensores\r\n",
                static_cast<unsigned long>(
                    configuracao::INTERVALO_MONITOR_SENSORES_MS));
}

void imprimir_linha() {
    std::printf("\r\n============================================================\r\n");
}

void imprimir_titulo(const char* titulo) {
    imprimir_linha();
    std::printf("  %s%s%s\r\n", terminal_cores ? "\033[1;36m" : "",
                titulo, terminal_cores ? "\033[0m" : "");
    std::printf("============================================================\r\n");
}

void mostrar_menu_principal();

void mostrar_menu_logs() {
    imprimir_titulo("NEXUS | AVISOS E TERMINAL");
    std::printf("\r\n  Nível geral: %s | cores: %s\r\n",
                nome_nivel_log(nivel_global_logs), terminal_cores ? "ligadas" : "desligadas");
    std::printf("  [1] Mostrar informações, avisos e erros\r\n");
    std::printf("  [2] Mostrar só avisos e erros\r\n");
    std::printf("  [3] Mostrar só erros\r\n");
    std::printf("  [4] Silenciar todos os logs\r\n");
    std::printf("  [5] Ligar/desligar cores do menu\r\n");
    std::printf("\r\n  Serviço específico: selecione para alternar o nível\r\n");
    for (size_t i = 0; i < sizeof(fontes_log) / sizeof(fontes_log[0]); ++i)
        std::printf("  [%u] %-20s %s\r\n", static_cast<unsigned>(i + 10),
                    fontes_log[i].nome, nome_nivel_log(fontes_log[i].nivel));
    std::printf("  [0] Voltar ao menu principal\r\n");
    imprimir_prompt("Mudanças temporárias: reiniciar restaura os níveis do firmware.");
}

void tratar_menu_logs(unsigned long opcao) {
    if (opcao == 0) {
        tela_atual = TelaTerminal::Principal;
        mostrar_menu_principal();
        return;
    }
    if (opcao >= 1 && opcao <= 4) {
        constexpr esp_log_level_t niveis[] = {
            ESP_LOG_INFO, ESP_LOG_WARN, ESP_LOG_ERROR, ESP_LOG_NONE};
        nivel_global_logs = niveis[opcao - 1];
        esp_log_level_set("*", nivel_global_logs);
        for (auto& fonte : fontes_log) fonte.nivel = nivel_global_logs;
    } else if (opcao == 5) {
        terminal_cores = !terminal_cores;
    } else if (opcao >= 10 && opcao < 10 + sizeof(fontes_log) / sizeof(fontes_log[0])) {
        auto& fonte = fontes_log[opcao - 10];
        fonte.nivel = fonte.nivel == ESP_LOG_INFO ? ESP_LOG_WARN :
                      fonte.nivel == ESP_LOG_WARN ? ESP_LOG_ERROR :
                      fonte.nivel == ESP_LOG_ERROR ? ESP_LOG_NONE : ESP_LOG_INFO;
        esp_log_level_set(fonte.etiqueta, fonte.nivel);
    } else {
        std::printf("\r\nOpção inválida.\r\n");
    }
    mostrar_menu_logs();
}

void mostrar_estado_rapido() {
    const ResumoSaudeSistema saude = servico_diagnostico_obter_resumo();
    const ResumoWifi wifi = servico_wifi_obter_resumo();
    const SituacaoOta ota = servico_ota_obter_situacao();
    const EstadoRegistroTelemetria sd =
        servico_registro_telemetria_obter_estado();
    const char* estado_saude = saude.estado == EstadoSaudeSistema::Saudavel ? "normal" :
        saude.estado == EstadoSaudeSistema::Recuperando ? "recuperando" :
        saude.estado == EstadoSaudeSistema::Atencao ? "degradado" : "falha";
    imprimir_titulo("ESTADO RÁPIDO DO MESTRE");
    std::printf("  Saúde: %s | causas: 0x%08lX | ativo: %llu s\r\n",
                saude.valido ? estado_saude : "ainda sem leitura",
                static_cast<unsigned long>(saude.causas_ativas),
                static_cast<unsigned long long>(saude.tempo_ativo_ms / 1000));
    std::printf("  Memória interna: %lu KiB livres | maior bloco: %lu KiB\r\n",
                static_cast<unsigned long>(saude.heap_interno_livre / 1024),
                static_cast<unsigned long>(saude.maior_bloco_heap_interno / 1024));
    std::printf("  PSRAM: %lu KiB livres | pilha mínima: %lu B (%s)\r\n",
                static_cast<unsigned long>(saude.psram_livre / 1024),
                static_cast<unsigned long>(saude.bytes_pilha_livres),
                saude.tarefa_menor_pilha[0] ? saude.tarefa_menor_pilha : "indisponível");
    std::printf("  Wi-Fi: %s | principal: %s | %u rede(s) salva(s)\r\n",
                wifi.conectado ? "conectado" : wifi.sessao_em_andamento ?
                    "em sessão" : "em repouso",
                wifi.rede_principal[0] ? wifi.rede_principal : "não definida",
                static_cast<unsigned>(wifi.quantidade_redes_usuario));
    std::printf("  OTA: %s | SD: %s | CSV pendentes: %lu\r\n",
                servico_ota_nome_estado(ota.estado),
                sd.cartao_disponivel ? "pronto" : "indisponível",
                static_cast<unsigned long>(sd.arquivos_pendentes));
    std::printf("  Satélites: equipe %s, visitantes %s\r\n",
                saude.equipe_respondendo ? "respondendo" : "sem resposta",
                saude.visitantes_respondendo ? "respondendo" : "sem resposta");
}

void mostrar_menu_principal() {
    imprimir_titulo("UFSM-CS | ESP32-S3 MESTRE | MENU PRINCIPAL");
    std::printf("\r\n  MONITORAMENTO\r\n");
    imprimir_opcoes(OPCOES_PRINCIPAL_MONITORAMENTO, "    ");
    std::printf("\r\n  CONECTIVIDADE E MANUTENÇÃO\r\n");
    imprimir_opcoes(OPCOES_PRINCIPAL_CONECTIVIDADE, "    ");
    std::printf("\r\n  FERRAMENTAS E TERMINAL\r\n");
    imprimir_opcoes(OPCOES_PRINCIPAL_FERRAMENTAS, "    ");
    std::printf("\r\n    [0] Redesenhar este menu\r\n");
    imprimir_prompt("Digite uma opção e pressione Enter. Enter vazio redesenha o menu.");
}

void mostrar_menu_sensores() {
    const RetratoDiagnosticoSistema retrato =
        servico_diagnostico_obter_retrato();
    const auto& dados = retrato.telemetria_atual;
    const auto& telemetria = retrato.telemetria;
    const auto& sensores = retrato.sensores;
    const auto& saude = retrato.saude;
    const auto& encoder_esquerdo = retrato.encoder_esquerdo;
    const auto& encoder_direito = retrato.encoder_direito;
    const auto& odometro = retrato.odometro;
    const auto& i2c = retrato.i2c;
    const EstadoServicoAceleracao aceleracao =
        servico_aceleracao_obter_estado();

    imprimir_titulo("SENSORES E DIAGNÓSTICO");
    std::printf("Fonte configurada : %s\r\n",
                configuracao::USAR_TELEMETRIA_SIMULADA
                    ? "simulador"
                    : "sensores reais");
    std::printf("Fonte atual       : %s\r\n",
                servico_simulador_telemetria_esta_ativo()
                    ? "simulador"
                    : "sensores reais");
    std::printf("Leitura permitida : ADC=%s | MPU=%s | encoders=%s | INA=%s\r\n",
                servico_controle_sensores_ativo(SensorControlado::Adc) ? "sim" : "não",
                servico_controle_sensores_ativo(SensorControlado::Mpu6050) ? "sim" : "não",
                servico_controle_sensores_ativo(SensorControlado::Encoders) ? "sim" : "não",
                servico_controle_sensores_ativo(SensorControlado::Ina228) ? "sim" : "não");
    std::printf("                   Microfone=%s | temperatura ESP=%s\r\n",
                servico_controle_sensores_ativo(SensorControlado::Microfone) ? "sim" : "não",
                servico_controle_sensores_ativo(SensorControlado::TemperaturaEsp) ? "sim" : "não");
    std::printf("Saúde do mestre   : %s | causas=0x%03lX\r\n",
                servico_diagnostico_nome_estado(saude.estado),
                static_cast<unsigned long>(saude.causas_ativas));
    std::printf("Amostras enviadas : %lu\r\n\r\n",
                static_cast<unsigned long>(telemetria.pacotes_gerados));

    if (telemetria.pacotes_gerados == 0) {
        std::printf("LEITURAS: aguardando a primeira amostra de telemetria.\r\n\r\n");
    } else {
        std::printf("LEITURAS MAIS RECENTES\r\n");
        if (servico_controle_sensores_ativo(SensorControlado::Adc))
            std::printf("  ADC tensão       : %u de 4095\r\n",
                        static_cast<unsigned>(dados.tensao_adc_bruta));
        else
            std::printf("  ADC tensão       : PAUSADO\r\n");
        if (servico_controle_sensores_ativo(SensorControlado::Mpu6050)) {
        std::printf("  Acelerômetro XYZ : %d, %d, %d\r\n",
                    dados.aceleracao_x, dados.aceleracao_y, dados.aceleracao_z);
        std::printf("  Aceleração XYZ   : %.3f, %.3f, %.3f g\r\n",
                    dados.aceleracao_x_g, dados.aceleracao_y_g,
                    dados.aceleracao_z_g);
        std::printf("  Acel. longitudinal: %+.3f g | %+.3f m/s²\r\n",
                    dados.aceleracao_g, dados.aceleracao_ms2);
        std::printf("  Calibração MPU   : %s | grav. longitudinal=%+.5f g | amostras=%u/%u\r\n",
                    aceleracao.calibrado ? "concluída" : "aguardando repouso",
                    aceleracao.componente_gravidade_longitudinal_g,
                    static_cast<unsigned>(
                        aceleracao.amostras_calibracao_coletadas),
                    static_cast<unsigned>(
                        configuracao::AMOSTRAS_CALIBRACAO_MPU6050));
        std::printf("  Giroscópio XYZ   : %d, %d, %d\r\n",
                    dados.giroscopio_x, dados.giroscopio_y, dados.giroscopio_z);
        } else {
            std::printf("  MPU6050          : PAUSADO\r\n");
        }
        if (servico_controle_sensores_ativo(SensorControlado::Encoders))
            std::printf("  Velocidade       : %.2f km/h\r\n", dados.velocidade_kmh);
        else
            std::printf("  Velocidade       : leitura dos encoders PAUSADA\r\n");
        std::printf("  Percurso         : %.3f km\r\n", dados.percurso_km);
        std::printf("  Odômetro         : %.3f km\r\n\r\n", dados.odometro_km);
        if (dados.simulado) {
            std::printf("  Elétrica         : %.2f V | %+.3f A | %+.1f W (simulação)\r\n\r\n",
                        dados.tensao_pacote_v, dados.corrente_a, dados.potencia_w);
        } else if (!servico_controle_sensores_ativo(SensorControlado::Ina228)) {
            std::printf("  INA228           : PAUSADO\r\n\r\n");
        } else if (dados.eletrica_valida) {
            std::printf("  INA228            : %.2f V | %+.3f A | %+.1f W\r\n\r\n",
                        dados.tensao_pacote_v, dados.corrente_a, dados.potencia_w);
        } else {
            std::printf("  INA228            : sem leitura elétrica válida\r\n\r\n");
        }
    }

    std::printf("ENCODERS / PCNT\r\n");
    if (!servico_controle_sensores_ativo(SensorControlado::Encoders))
        std::printf("  Leitura pausada: valores abaixo são o último retrato; PCNT continua contando.\r\n");
    std::printf("  Esquerdo         : %s | GPIO A=%d B=%d | PCNT=%llu\r\n",
                encoder_esquerdo.inicializado ? "ativo" : "inativo",
                encoder_esquerdo.pino_a, encoder_esquerdo.pino_b,
                static_cast<unsigned long long>(encoder_esquerdo.contagem_atual));
    std::printf("    percurso/vel.  : %.3f m | %.2f km/h | resolução=%.6f m/contagem\r\n",
                odometro.roda_esquerda.percurso_m,
                odometro.roda_esquerda.velocidade_kmh,
                odometro.roda_esquerda.metros_por_contagem);
    std::printf("    contagens      : %llu | leituras/erros=%lu/%lu\r\n",
                static_cast<unsigned long long>(
                    odometro.roda_esquerda.contagens_acumuladas),
                static_cast<unsigned long>(encoder_esquerdo.leituras_ok),
                static_cast<unsigned long>(encoder_esquerdo.erros_leitura));
    std::printf("  Direito          : %s | GPIO A=%d B=%d | PCNT=%llu\r\n",
                encoder_direito.inicializado ? "ativo" : "inativo",
                encoder_direito.pino_a, encoder_direito.pino_b,
                static_cast<unsigned long long>(encoder_direito.contagem_atual));
    std::printf("    percurso/vel.  : %.3f m | %.2f km/h | resolução=%.6f m/contagem\r\n",
                odometro.roda_direita.percurso_m,
                odometro.roda_direita.velocidade_kmh,
                odometro.roda_direita.metros_por_contagem);
    std::printf("    contagens      : %llu | leituras/erros=%lu/%lu\r\n",
                static_cast<unsigned long long>(
                    odometro.roda_direita.contagens_acumuladas),
                static_cast<unsigned long>(encoder_direito.leituras_ok),
                static_cast<unsigned long>(encoder_direito.erros_leitura));
    std::printf("  Média das rodas  : %.3f m | %.2f km/h\r\n",
                odometro.percurso_m, odometro.velocidade_kmh);
    std::printf("  Coerência rodas  : %s | alertas=%lu | validações rejeitadas=%lu\r\n",
                odometro.rodas_coerentes ? "normal" : "VERIFICAR ENCODERS",
                static_cast<unsigned long>(odometro.divergencias_detectadas),
                static_cast<unsigned long>(odometro.erros_validacao));
    std::printf("  Persistência NVS : %s%s | falhas=%lu | intervalo=%.1f m\r\n\r\n",
                odometro.persistencia_disponivel ? "ativa" : "indisponível",
                odometro.persistencia_pendente ? " (pendente)" : "",
                static_cast<unsigned long>(odometro.erros_persistencia),
                configuracao::INTERVALO_PERSISTENCIA_ODOMETRO_M);

    std::printf("DIAGNÓSTICO DOS SENSORES\r\n");
    std::printf("  ADC              : erros=%lu | último=%s\r\n",
                static_cast<unsigned long>(sensores.adc.total),
                esp_err_to_name(sensores.adc.ultimo_erro));
    std::printf("  MPU6050          : erros=%lu | último=%s\r\n",
                static_cast<unsigned long>(sensores.mpu6050.total),
                esp_err_to_name(sensores.mpu6050.ultimo_erro));
    std::printf("  Encoder          : erros=%lu | último=%s\r\n",
                static_cast<unsigned long>(sensores.encoder.total),
                esp_err_to_name(sensores.encoder.ultimo_erro));
    std::printf("  INA228           : erros=%lu | último=%s\r\n",
                static_cast<unsigned long>(sensores.ina228.total),
                esp_err_to_name(sensores.ina228.ultimo_erro));
    std::printf("  Barramento I2C   : operações=%lu | erros=%lu | último=%s\r\n\r\n",
                static_cast<unsigned long>(i2c.operacoes_ok),
                static_cast<unsigned long>(i2c.erros),
                esp_err_to_name(i2c.ultimo_erro));

    std::printf("  [1] Atualizar leituras e diagnóstico\r\n");
    std::printf("  [2] Zerar somente o percurso da sessão\r\n");
    std::printf("  [3] Solicitar relatório completo nos logs\r\n");
    std::printf("  [4] Ver somente o leitor de tensão (ADC)\r\n");
    std::printf("  [5] Ver somente o MPU6050\r\n");
    std::printf("  [6] Ver somente encoders e odômetro\r\n");
    std::printf("  [7] Ver somente o barramento I2C\r\n");
    std::printf("  [8] Ver somente o INA228\r\n");
    std::printf("  [9] Pausar ou retomar leituras dos sensores\r\n");
    imprimir_prompt("[Enter] Voltar ao menu principal");
}

void mostrar_controle_sensores() {
    imprimir_titulo("CONTROLE DE LEITURAS | DIAGNÓSTICO");
    std::printf("  Escolha um sensor para alternar seu estado:\r\n");
    constexpr SensorControlado lista[] = {
        SensorControlado::Adc, SensorControlado::Mpu6050,
        SensorControlado::Encoders, SensorControlado::Ina228,
        SensorControlado::Microfone, SensorControlado::TemperaturaEsp};
    constexpr const char* nomes[] = {"ADC", "MPU6050", "Encoders", "INA228", "Microfone", "Temperatura ESP"};
    for (size_t indice = 0; indice < 6; ++indice) {
        std::printf("  [%u] %-10s : %s\r\n", static_cast<unsigned>(indice + 3),
                    nomes[indice],
                    servico_controle_sensores_ativo(lista[indice]) ? "leitura permitida" : "PAUSADO");
    }
    std::printf("\r\n  [1] Pausar todas as leituras\r\n");
    std::printf("  [2] Retomar todas as leituras\r\n");
    std::printf("\r\nA escolha vale até reiniciar o mestre. Na simulação, os dados continuam\r\n");
    std::printf("simulados. O PCNT continua contando enquanto a leitura dos encoders está\r\n");
    std::printf("pausada; a velocidade publicada vira zero, sem indicar que o carro parou.\r\n");
    std::printf("O MPU6050 refaz a calibração ao voltar.\r\n");
    imprimir_prompt("[Enter] Voltar a sensores e diagnóstico");
}

void mostrar_leitura_adc() {
    const RetratoDiagnosticoSistema retrato =
        servico_diagnostico_obter_retrato();
    imprimir_titulo("LEITOR DE TENSÃO | ADC");
    if (!servico_controle_sensores_ativo(SensorControlado::Adc)) {
        std::printf("Aquisição pausada pelo terminal. O valor anterior não é mostrado.\r\n");
        imprimir_rodape_monitor_sensor();
        return;
    }
    std::printf("GPIO              : %d\r\n", configuracao::PINO_LEITURA_TENSAO);
    std::printf("Leitura bruta     : %u de 4095 (%.1f%% da escala)\r\n",
                static_cast<unsigned>(retrato.telemetria_atual.tensao_adc_bruta),
                retrato.telemetria_atual.tensao_adc_bruta * 100.0f / 4095.0f);
    std::printf("Erros             : %lu\r\n",
                static_cast<unsigned long>(retrato.sensores.adc.total));
    std::printf("Último resultado  : %s\r\n",
                esp_err_to_name(retrato.sensores.adc.ultimo_erro));
    std::printf("\r\nA conversão para volts depende do divisor resistivo e da calibração do ADC.\r\n");
    imprimir_rodape_monitor_sensor();
}

void mostrar_leitura_ina228() {
    const EstadoIna228 sensor = ina228_obter_estado();
    const LeituraIna228& leitura = sensor.ultima_leitura;
    imprimir_titulo("INA228 | MEDIÇÃO ELÉTRICA");
    if (servico_simulador_telemetria_esta_ativo())
        std::printf("Simulador ativo: o INA228 não recebe novas leituras; dados abaixo são históricos.\r\n");
    if (!servico_controle_sensores_ativo(SensorControlado::Ina228)) {
        std::printf("Aquisição pausada pelo terminal. O valor anterior não é mostrado.\r\n");
        imprimir_rodape_monitor_sensor();
        return;
    }
    std::printf("Estado            : %s | último=%s\r\n",
                sensor.inicializado ? "ativo" : "indisponível",
                esp_err_to_name(sensor.ultimo_erro));
    std::printf("Endereço / ID     : 0x%02X / 0x%04X | calibração=%u\r\n",
                configuracao::ENDERECO_INA228, sensor.identificacao,
                sensor.calibracao);
    std::printf("Shunt / limite    : %.3f mΩ / %.1f A\r\n",
                configuracao::RESISTENCIA_SHUNT_INA228_OHM * 1000.0f,
                configuracao::CORRENTE_MAXIMA_INA228_A);
    std::printf("Leituras / erros  : %lu / %lu (consecutivos=%lu)\r\n",
                static_cast<unsigned long>(sensor.leituras_ok),
                static_cast<unsigned long>(sensor.erros_leitura),
                static_cast<unsigned long>(sensor.erros_consecutivos));
    if (leitura.valida) {
        std::printf("Idade da leitura  : %llu ms\r\n",
                    static_cast<unsigned long long>(
                        esp_timer_get_time() / 1000 - leitura.instante_ms));
        std::printf("VBUS / VSHUNT     : %.3f V / %+.4f mV\r\n",
                    leitura.tensao_barramento_v, leitura.tensao_shunt_mv);
        std::printf("Corrente / potência: %+.3f A / %+.1f W\r\n",
                    leitura.corrente_a, leitura.potencia_w);
        std::printf("Potência interna  : %.1f W (magnitude sem sinal)\r\n",
                    leitura.potencia_chip_w);
        std::printf("Temperatura chip  : %.2f °C\r\n", leitura.temperatura_chip_c);
        if (leitura.energia_valida)
            std::printf("Energia acumulada : %.2f Wh (desde reset do INA)\r\n",
                        leitura.energia_j / 3600.0);
        else
            std::printf("Energia acumulada : indisponível (transbordamento)\r\n");
        if (leitura.carga_valida)
            std::printf("Carga acumulada   : %+.3f Ah (desde reset do INA)\r\n",
                        leitura.carga_c / 3600.0);
        else
            std::printf("Carga acumulada   : indisponível (transbordamento)\r\n");
        std::printf("Diagnóstico bruto : 0x%04X\r\n", leitura.diagnostico);
    } else {
        std::printf("Leitura           : indisponível; zero não é medição\r\n");
    }
    imprimir_rodape_monitor_sensor();
}

void mostrar_leitura_mpu6050() {
    const EstadoMpu6050 sensor = mpu6050_obter_estado();
    const EstadoServicoAceleracao aceleracao =
        servico_aceleracao_obter_estado();
    const LeituraMpu6050& leitura = aceleracao.leitura;
    imprimir_titulo("MPU6050 | LEITURA DETALHADA");
    if (!servico_controle_sensores_ativo(SensorControlado::Mpu6050)) {
        std::printf("Aquisição pausada pelo terminal. Ao retomar, a calibração será refeita.\r\n");
        imprimir_rodape_monitor_sensor();
        return;
    }
    std::printf("Estado            : %s\r\n",
                sensor.inicializado ? "ativo" : "INATIVO");
    std::printf("WHO_AM_I          : 0x%02X (%s)\r\n",
                static_cast<unsigned>(sensor.identificacao),
                sensor.identificacao == 0x68 ? "padrão" : "não padrão, aceito");
    std::printf("Endereço I2C      : 0x%02X\r\n",
                static_cast<unsigned>(configuracao::ENDERECO_MPU6050));
    std::printf("Configuração      : %s | ±2 g | ±250 °/s | DLPF 44 Hz\r\n",
                 sensor.configuracao_verificada ? "verificada" : "NÃO VERIFICADA");
    std::printf("Serviço aquisição : %s\r\n",
                aceleracao.iniciado ? "ativo" : "INATIVO");
    std::printf("Amostragem/filtro : %lu Hz / %.1f Hz\r\n",
                static_cast<unsigned long>(
                    sensor.frequencia_amostragem_hz),
                configuracao::FREQUENCIA_CORTE_ACELERACAO_HZ);
    std::printf("Acelerômetro bruto: X=%d Y=%d Z=%d\r\n",
                leitura.aceleracao_x, leitura.aceleracao_y,
                leitura.aceleracao_z);
    std::printf("Aceleração em g   : X=%+.4f Y=%+.4f Z=%+.4f\r\n",
                leitura.aceleracao_x_g, leitura.aceleracao_y_g,
                leitura.aceleracao_z_g);
    std::printf("Aceleração m/s²   : X=%+.3f Y=%+.3f Z=%+.3f\r\n",
                leitura.aceleracao_x_ms2, leitura.aceleracao_y_ms2,
                leitura.aceleracao_z_ms2);
    std::printf("Gravidade estimada: X=%+.4f Y=%+.4f Z=%+.4f g\r\n",
                aceleracao.gravidade_estimada_x_g,
                aceleracao.gravidade_estimada_y_g,
                aceleracao.gravidade_estimada_z_g);
    std::printf("Aceleração linear : X=%+.4f Y=%+.4f Z=%+.4f g\r\n",
                aceleracao.aceleracao_linear_x_g,
                aceleracao.aceleracao_linear_y_g,
                aceleracao.aceleracao_linear_z_g);
    std::printf("Giroscópio bruto  : X=%d Y=%d Z=%d\r\n",
                leitura.giroscopio_x, leitura.giroscopio_y,
                leitura.giroscopio_z);
    std::printf("Giroscópio °/s    : X=%+.2f Y=%+.2f Z=%+.2f\r\n",
                leitura.giroscopio_x_graus_s,
                leitura.giroscopio_y_graus_s,
                leitura.giroscopio_z_graus_s);
    std::printf("Desvio giroscópio : X=%+.3f Y=%+.3f Z=%+.3f °/s\r\n",
                aceleracao.desvio_giroscopio_x_graus_s,
                aceleracao.desvio_giroscopio_y_graus_s,
                aceleracao.desvio_giroscopio_z_graus_s);
    std::printf("Temperatura       : %.2f °C\r\n", leitura.temperatura_c);
    std::printf("Longitudinal      : %+.4f g | %+.3f m/s²\r\n",
                aceleracao.aceleracao_longitudinal_g,
                aceleracao.aceleracao_longitudinal_ms2);
    const char* sentido = aceleracao.sentido ==
                                  SentidoAceleracaoLongitudinal::Frente
                              ? "para frente"
                          : aceleracao.sentido ==
                                  SentidoAceleracaoLongitudinal::Tras
                              ? "para trás"
                              : "neutro";
    const char eixo = configuracao::EIXO_LONGITUDINAL_MPU6050 == 0
                          ? 'X'
                      : configuracao::EIXO_LONGITUDINAL_MPU6050 == 1 ? 'Y'
                                                                     : 'Z';
    std::printf("Sentido aceleração: %s | eixo %c %s\r\n", sentido, eixo,
                aceleracao.eixo_longitudinal_compativel
                    ? "compatível"
                    : "INCOMPATÍVEL COM A MONTAGEM");
    std::printf("Calibração        : %s | grav. longitudinal=%+.5f g | %u/%u amostras\r\n",
                aceleracao.calibrado ? "concluída" : "aguardando repouso",
                aceleracao.componente_gravidade_longitudinal_g,
                static_cast<unsigned>(
                    aceleracao.amostras_calibracao_coletadas),
                static_cast<unsigned>(
                    configuracao::AMOSTRAS_CALIBRACAO_MPU6050));
    std::printf("Leituras/erros    : dispositivo=%lu/%lu | serviço=%lu/%lu\r\n",
                static_cast<unsigned long>(sensor.leituras_ok),
                static_cast<unsigned long>(sensor.erros_leitura),
                static_cast<unsigned long>(aceleracao.leituras_ok),
                static_cast<unsigned long>(aceleracao.erros_leitura));
    std::printf("Último resultado  : dispositivo=%s | serviço=%s\r\n",
                esp_err_to_name(sensor.ultimo_erro),
                esp_err_to_name(aceleracao.ultimo_erro));
    imprimir_rodape_monitor_sensor();
}

void mostrar_leitura_encoders() {
    const RetratoDiagnosticoSistema retrato =
        servico_diagnostico_obter_retrato();
    const auto& esquerdo = retrato.encoder_esquerdo;
    const auto& direito = retrato.encoder_direito;
    const auto& odometro = retrato.odometro;
    imprimir_titulo("ENCODERS E ODÔMETRO | LEITURA DETALHADA");
    if (!servico_controle_sensores_ativo(SensorControlado::Encoders)) {
        std::printf("Leitura pausada pelo terminal; PCNT continua contando os pulsos.\r\n");
        imprimir_rodape_monitor_sensor();
        return;
    }
    std::printf("Esquerdo          : %s | contagem=%llu | giros=%.3f\r\n",
                esquerdo.inicializado ? "ativo" : "INATIVO",
                static_cast<unsigned long long>(esquerdo.contagem_atual),
                esquerdo.contagens_por_giro == 0 ? 0.0
                    : static_cast<double>(esquerdo.contagem_atual) /
                          esquerdo.contagens_por_giro);
    std::printf("  overflow/erros  : %lu/%lu | percurso=%.3f m | %.2f km/h\r\n",
                static_cast<unsigned long>(
                    esquerdo.transbordamentos_compensados),
                static_cast<unsigned long>(esquerdo.erros_leitura),
                odometro.roda_esquerda.percurso_m,
                odometro.roda_esquerda.velocidade_kmh);
    std::printf("Direito           : %s | contagem=%llu | giros=%.3f\r\n",
                direito.inicializado ? "ativo" : "INATIVO",
                static_cast<unsigned long long>(direito.contagem_atual),
                direito.contagens_por_giro == 0 ? 0.0
                    : static_cast<double>(direito.contagem_atual) /
                          direito.contagens_por_giro);
    std::printf("  overflow/erros  : %lu/%lu | percurso=%.3f m | %.2f km/h\r\n",
                static_cast<unsigned long>(
                    direito.transbordamentos_compensados),
                static_cast<unsigned long>(direito.erros_leitura),
                odometro.roda_direita.percurso_m,
                odometro.roda_direita.velocidade_kmh);
    std::printf("Média das rodas   : %.3f m | %.2f km/h\r\n",
                odometro.percurso_m, odometro.velocidade_kmh);
    std::printf("Odômetro total    : %.3f m | rodas %s\r\n",
                odometro.odometro_m,
                odometro.rodas_coerentes ? "coerentes" : "DIVERGENTES");
    imprimir_rodape_monitor_sensor();
}

void mostrar_leitura_i2c() {
    const EstatisticasI2c i2c = gerenciador_i2c_obter_estatisticas();
    imprimir_titulo("BARRAMENTO I2C | DIAGNÓSTICO");
    std::printf("Estado            : %s\r\n",
                i2c.inicializado ? "ativo" : "INATIVO");
    std::printf("Porta / SDA / SCL : %d / GPIO%d / GPIO%d\r\n",
                configuracao::PORTA_I2C, configuracao::PINO_I2C_SDA,
                configuracao::PINO_I2C_SCL);
    std::printf("Frequência        : %lu Hz\r\n",
                static_cast<unsigned long>(configuracao::FREQUENCIA_I2C_HZ));
    std::printf("Operações/erros   : %lu/%lu\r\n",
                static_cast<unsigned long>(i2c.operacoes_ok),
                static_cast<unsigned long>(i2c.erros));
    std::printf("Bytes TX/RX       : %llu/%llu\r\n",
                static_cast<unsigned long long>(i2c.bytes_escritos),
                static_cast<unsigned long long>(i2c.bytes_lidos));
    std::printf("Sondagens OK/aus. : %lu/%lu\r\n",
                static_cast<unsigned long>(i2c.sondagens_ok),
                static_cast<unsigned long>(i2c.enderecos_ausentes));
    std::printf("Último resultado  : %s\r\n",
                esp_err_to_name(i2c.ultimo_erro));
    imprimir_rodape_monitor_sensor();
}

void mostrar_menu_comandos_satelites() {
    imprimir_titulo("CONSULTAS AOS SATÉLITES");
    imprimir_opcoes(OPCOES_SATELITES);
    imprimir_prompt("[Enter] Voltar ao menu principal");
}

void mostrar_menu_ota() {
    const SituacaoOta ota = servico_ota_obter_situacao();
    imprimir_titulo("ATUALIZAÇÃO OTA");
    std::printf("Versão instalada : %s\r\n", ota.versao_atual[0] ? ota.versao_atual : "-");
    std::printf("Versão disponível: %s\r\n",
                ota.versao_disponivel[0] ? ota.versao_disponivel : "nenhuma");
    std::printf("Estado            : %s\r\n\r\n", servico_ota_nome_estado(ota.estado));
    auto mostrar_satelite = [](const char* nome, const SituacaoOtaSatelite& satelite) {
        std::printf("%-18s: %-25s  %s -> %s\r\n", nome,
                    servico_ota_nome_estado_satelite(satelite.estado),
                    satelite.versao_atual[0] ? satelite.versao_atual : "-",
                    satelite.versao_disponivel[0] ? satelite.versao_disponivel : "-");
        if (satelite.estado == EstadoOtaSatelite::Transferindo) {
            std::printf("                    %lu.%lu%% | %.2f MB/s | restante %lu s\r\n",
                        static_cast<unsigned long>(satelite.progresso.percentual_decimos / 10),
                        static_cast<unsigned long>(satelite.progresso.percentual_decimos % 10),
                        satelite.progresso.taxa_bytes_por_segundo / (1024.0 * 1024.0),
                        static_cast<unsigned long>(satelite.progresso.tempo_restante_segundos));
        }
    };
    mostrar_satelite("Satélite equipe", ota.equipe);
    mostrar_satelite("Satélite visitantes", ota.visitantes);
    if (ota.estado == EstadoServicoOta::Baixando && ota.alvo_ativo == AlvoOta::Mestre) {
        std::printf("Progresso mestre  : %lu.%lu%% | %.2f MB/s | restante %lu s\r\n",
                    static_cast<unsigned long>(ota.progresso.percentual_decimos / 10),
                    static_cast<unsigned long>(ota.progresso.percentual_decimos % 10),
                    ota.progresso.taxa_bytes_por_segundo / (1024.0 * 1024.0),
                    static_cast<unsigned long>(ota.progresso.tempo_restante_segundos));
    }
    std::printf("Verificação periódica: a cada %lu minuto(s)\r\n\r\n",
                static_cast<unsigned long>(ota.intervalo_verificacao_minutos));
    std::printf("Telemetria durante OTA: a cada %lu ms\r\n\r\n",
                static_cast<unsigned long>(
                    servico_telemetria_obter_intervalo_durante_ota()));
    imprimir_opcoes(OPCOES_OTA);
    imprimir_prompt("[Enter] Voltar ao menu principal");
}

void mostrar_intervalos_ota() {
    imprimir_linha();
    std::printf("INTERVALO DAS VERIFICAÇÕES OTA\r\n\r\n");
    std::printf("  1 - 5 minutos\r\n");
    std::printf("  2 - 15 minutos\r\n");
    std::printf("  3 - 30 minutos\r\n");
    std::printf("  4 - 1 hora\r\n");
    std::printf("  5 - 6 horas\r\n");
    std::printf("  6 - 24 horas\r\n");
    std::printf("\r\nPressione somente Enter para voltar.\r\n> ");
    std::fflush(stdout);
}

void mostrar_intervalos_telemetria_ota() {
    imprimir_linha();
    std::printf("TELEMETRIA DURANTE A OTA DOS SATÉLITES\r\n\r\n");
    std::printf("A telemetria permanece ativa, mas usa menos espaço na UART.\r\n\r\n");
    std::printf("  1 - 500 ms (mesmo intervalo normal)\r\n");
    std::printf("  2 - 1 segundo\r\n");
    std::printf("  3 - 2 segundos (recomendado)\r\n");
    std::printf("  4 - 5 segundos\r\n");
    std::printf("  5 - 10 segundos\r\n");
    std::printf("\r\nPressione somente Enter para voltar.\r\n> ");
    std::fflush(stdout);
}

void mostrar_menu_intervalos() {
    imprimir_titulo("INTERVALOS DOS RELATÓRIOS");
    std::printf("Os valores abaixo alteram somente a exibição no terminal.\r\n");
    std::printf("Estado geral: %s\r\n\r\n",
                servico_relatorios_estao_pausados() ? "pausado" : "ativo");
    const size_t quantidade = static_cast<size_t>(GrupoRelatorio::Quantidade);
    for (size_t indice = 0; indice < quantidade; ++indice) {
        const auto grupo = static_cast<GrupoRelatorio>(indice);
        const uint32_t intervalo = servico_relatorios_obter_intervalo(grupo);
        const char* nome = servico_relatorios_nome_grupo(grupo);
        if (intervalo == 0) {
            std::printf("  [%u] %-25s desativado\r\n", static_cast<unsigned>(indice + 1),
                        nome);
        } else {
            std::printf("  [%u] %-25s %lu ms\r\n", static_cast<unsigned>(indice + 1),
                        nome, static_cast<unsigned long>(intervalo));
        }
    }
    std::printf("\r\n  [Enter] Voltar ao menu principal\r\n  comando > ");
    std::fflush(stdout);
}

void mostrar_opcoes_intervalo() {
    const size_t indice = static_cast<size_t>(grupo_em_edicao);
    imprimir_linha();
    std::printf("NOVO INTERVALO: %s\r\n\r\n",
                servico_relatorios_nome_grupo(
                    static_cast<GrupoRelatorio>(indice)));
    std::printf("  1 - 500 ms\r\n");
    std::printf("  2 - 1 segundo\r\n");
    std::printf("  3 - 2 segundos\r\n");
    std::printf("  4 - 5 segundos\r\n");
    std::printf("  5 - 10 segundos\r\n");
    std::printf("  6 - 30 segundos\r\n");
    std::printf("  7 - Desativar este relatório\r\n");
    std::printf("\r\nPressione somente Enter para voltar.\r\n> ");
    std::fflush(stdout);
}

void mostrar_redes_salvas(const ResumoWifi& wifi) {
    if (wifi.quantidade_redes_usuario == 0) {
        std::printf("  Nenhuma rede secundária salva.\r\n");
        return;
    }
    for (uint8_t indice = 0; indice < wifi.quantidade_redes_usuario; ++indice) {
        std::printf("  %u - %s\r\n", static_cast<unsigned>(indice + 1),
                    wifi.redes_usuario[indice]);
    }
}

void mostrar_menu_wifi() {
    const ResumoWifi wifi = servico_wifi_obter_resumo();
    imprimir_titulo("REDES WI-FI");
    std::printf("Estado             : %s\r\n", wifi.conectado ? "conectado" : "desconectado");
    std::printf("Rádio              : %s\r\n", wifi.radio_ativo ? "ativo" : "em repouso");
    std::printf("Rede ativa         : %s\r\n", wifi.rede_ativa[0] ? wifi.rede_ativa : "-");
    std::printf("Rede principal     : %s%s\r\n",
                wifi.rede_principal[0] ? wifi.rede_principal : "-",
                wifi.principal_alterada ? " (alterada)" : " (definida no firmware)");
    std::printf("Redes secundárias  : %u de %u\r\n",
                static_cast<unsigned>(wifi.quantidade_redes_usuario),
                static_cast<unsigned>(configuracao::MAXIMO_REDES_WIFI_USUARIO));
    std::printf("Conexão automática : %s\r\n\r\n",
                wifi.conectar_secundarias_automaticamente ? "habilitada" : "desabilitada");
    std::printf("Política de conexão: %u tentativa(s) por rede | %lu ms por tentativa\r\n",
                static_cast<unsigned>(wifi.politica.tentativas_por_rede),
                static_cast<unsigned long>(wifi.politica.tempo_por_tentativa_ms));
    std::printf("                     intervalo %lu ms | limite da sessão %lu s\r\n",
                static_cast<unsigned long>(
                    wifi.politica.intervalo_entre_tentativas_ms),
                static_cast<unsigned long>(
                    wifi.politica.tempo_limite_sessao_ms / 1000));
    if (wifi.sessao_em_andamento) {
        std::printf("Sessão de rede     : %s (%lu tentativa(s))\r\n",
                    servico_wifi_nome_finalidade_sessao(
                        wifi.finalidade_sessao),
                    static_cast<unsigned long>(
                        wifi.tentativas_ultima_sessao));
    }
    if (wifi.conectado) {
        std::printf("Sinal              : %d dBm (canal %u)\r\n",
                    wifi.rssi_dbm, static_cast<unsigned>(wifi.canal));
    }
    std::printf("Conexões concluídas: %lu | desconexões inesperadas: %lu\r\n",
                static_cast<unsigned long>(wifi.conexoes_bem_sucedidas),
                static_cast<unsigned long>(wifi.desconexoes_inesperadas));
    if (wifi.aguardando_autorizacao_secundaria) {
        std::printf("Atenção: a rede principal falhou e uma rede secundária aguarda autorização.\r\n");
    }
    std::printf("\r\n");
    std::printf("  [1] Atualizar o estado exibido\r\n");
    std::printf("  [2] Informar e testar uma nova rede\r\n");
    std::printf("  [3] Autorizar conexão a uma rede salva\r\n");
    std::printf("  [4] Excluir uma rede salva\r\n");
    std::printf("  [5] Alterar o comportamento automático\r\n");
    std::printf("  [6] Alterar a rede principal (protegido)\r\n");
    std::printf("  [7] Restaurar a rede do firmware (protegido)\r\n");
    std::printf("  [8] Configurar tentativas e tempos (protegido)\r\n");
    std::printf("\r\n  [Enter] Voltar ao menu principal\r\n  comando > ");
    std::fflush(stdout);
}

void solicitar_ssid_nova_rede() {
    std::memset(contexto_wifi.ssid, 0, sizeof(contexto_wifi.ssid));
    std::memset(contexto_wifi.senha, 0, sizeof(contexto_wifi.senha));
    imprimir_linha();
    std::printf("NOVA REDE WI-FI\r\n");
    std::printf("Digite o nome da rede (SSID) e pressione Enter para enviar.\r\n");
    std::printf("Enter vazio cancela.\r\n> ");
    std::fflush(stdout);
}

void solicitar_senha_rede(const char* titulo) {
    std::printf("\r\n%s\r\n", titulo);
    std::printf("Senha vazia para rede aberta; caso contrário, 8 a 63 caracteres.\r\n");
    std::printf("A entrada não aparece no terminal.\r\n> ");
    std::fflush(stdout);
}

void mostrar_confirmacao_nova_rede() {
    imprimir_linha();
    std::printf("CONFIRMAR TESTE DE CONEXÃO\r\n");
    std::printf("Rede: %s\r\n", contexto_wifi.ssid);
    std::printf("A senha não será exibida.\r\n\r\n");
    std::printf("  1 - Autorizar a tentativa de conexão\r\n");
    std::printf("  2 - Cancelar\r\n> ");
    std::fflush(stdout);
}

void mostrar_confirmacao_nova_principal() {
    imprimir_linha();
    std::printf("CONFIRMAR ALTERAÇÃO DA REDE PRINCIPAL\r\n");
    std::printf("Nova rede principal: %s\r\n", contexto_wifi.ssid);
    std::printf("A senha da rede não será exibida.\r\n\r\n");
    std::printf("  1 - Testar, salvar e usar como principal\r\n");
    std::printf("  2 - Cancelar\r\n> ");
    std::fflush(stdout);
}

void mostrar_confirmacao_restaurar_principal() {
    imprimir_linha();
    std::printf("CONFIRMAR RESTAURAÇÃO DA REDE PRINCIPAL\r\n");
    std::printf("O ESP tentará a rede definida no firmware.\r\n\r\n");
    std::printf("  1 - Confirmar\r\n");
    std::printf("  2 - Cancelar\r\n> ");
    std::fflush(stdout);
}

void mostrar_confirmacao_salvar_rede() {
    imprimir_linha();
    std::printf("REDE VALIDADA COM SUCESSO\r\n");
    std::printf("Deseja salvar a rede '%s' para uso futuro?\r\n\r\n",
                contexto_wifi.ssid);
    std::printf("  1 - Salvar rede\r\n");
    std::printf("  2 - Não salvar\r\n> ");
    std::fflush(stdout);
}

void mostrar_escolha_rede(const char* titulo) {
    const ResumoWifi wifi = servico_wifi_obter_resumo();
    imprimir_linha();
    std::printf("%s\r\n\r\n", titulo);
    mostrar_redes_salvas(wifi);
    std::printf("\r\nDigite o número da rede e pressione Enter. Enter vazio cancela.\r\n> ");
    std::fflush(stdout);
}

void mostrar_confirmacao_rede_salva(const char* acao) {
    const ResumoWifi wifi = servico_wifi_obter_resumo();
    imprimir_linha();
    if (contexto_wifi.indice_rede >= wifi.quantidade_redes_usuario) {
        std::printf("A rede selecionada não existe mais.\r\n");
        tela_atual = TelaTerminal::Wifi;
        mostrar_menu_wifi();
        return;
    }
    std::printf("CONFIRMAR %s\r\n", acao);
    std::printf("Rede: %s\r\n\r\n",
                wifi.redes_usuario[contexto_wifi.indice_rede]);
    std::printf("  1 - Confirmar\r\n");
    std::printf("  2 - Cancelar\r\n> ");
    std::fflush(stdout);
}

void mostrar_menu_automatico() {
    const ResumoWifi wifi = servico_wifi_obter_resumo();
    imprimir_linha();
    std::printf("CONEXÃO AUTOMÁTICA A REDES SECUNDÁRIAS\r\n");
    std::printf("Estado atual: %s\r\n\r\n",
                wifi.conectar_secundarias_automaticamente ? "habilitada" : "desabilitada");
    std::printf("  1 - Habilitar tentativas automáticas\r\n");
    std::printf("  2 - Exigir autorização antes de cada rede secundária\r\n");
    std::printf("\r\nPressione somente Enter para voltar.\r\n> ");
    std::fflush(stdout);
}

void mostrar_menu_politica_wifi() {
    const ResumoWifi wifi = servico_wifi_obter_resumo();
    imprimir_titulo("POLÍTICA DE CONEXÃO WI-FI");
    std::printf("  [1] Tentativas por rede       : %u (faixa %u a %u)\r\n",
                static_cast<unsigned>(wifi.politica.tentativas_por_rede),
                static_cast<unsigned>(configuracao::TENTATIVAS_WIFI_MINIMAS),
                static_cast<unsigned>(configuracao::TENTATIVAS_WIFI_MAXIMAS));
    std::printf("  [2] Tempo de cada tentativa   : %lu s\r\n",
                static_cast<unsigned long>(
                    wifi.politica.tempo_por_tentativa_ms / 1000));
    std::printf("  [3] Intervalo entre tentativas: %lu ms\r\n",
                static_cast<unsigned long>(
                    wifi.politica.intervalo_entre_tentativas_ms));
    std::printf("  [4] Limite total da sessão    : %lu s\r\n",
                static_cast<unsigned long>(
                    wifi.politica.tempo_limite_sessao_ms / 1000));
    std::printf("  [5] Restaurar valores padrão\r\n");
    std::printf("\r\nO limite da sessão inclui todas as redes tentadas.\r\n");
    std::printf("Pressione somente Enter para voltar.\r\n> ");
    std::fflush(stdout);
}

void solicitar_valor_politica_wifi() {
    imprimir_linha();
    switch (contexto_wifi.campo_politica) {
        case CampoPoliticaWifi::Tentativas:
            std::printf("TENTATIVAS POR REDE\r\nDigite um valor de %u a %u.\r\n> ",
                        static_cast<unsigned>(
                            configuracao::TENTATIVAS_WIFI_MINIMAS),
                        static_cast<unsigned>(
                            configuracao::TENTATIVAS_WIFI_MAXIMAS));
            break;
        case CampoPoliticaWifi::TempoTentativa:
            std::printf("TEMPO POR TENTATIVA\r\nDigite o tempo em segundos, de %lu a %lu.\r\n> ",
                        static_cast<unsigned long>(
                            configuracao::TEMPO_TENTATIVA_WIFI_MINIMO_MS / 1000),
                        static_cast<unsigned long>(
                            configuracao::TEMPO_TENTATIVA_WIFI_MAXIMO_MS / 1000));
            break;
        case CampoPoliticaWifi::IntervaloTentativas:
            std::printf("INTERVALO ENTRE TENTATIVAS\r\nDigite o tempo em ms, de %lu a %lu.\r\n> ",
                        static_cast<unsigned long>(
                            configuracao::INTERVALO_TENTATIVAS_WIFI_MINIMO_MS),
                        static_cast<unsigned long>(
                            configuracao::INTERVALO_TENTATIVAS_WIFI_MAXIMO_MS));
            break;
        case CampoPoliticaWifi::TempoSessao:
            std::printf("LIMITE TOTAL DA SESSÃO\r\nDigite o tempo em segundos, de %lu a %lu.\r\n> ",
                        static_cast<unsigned long>(
                            configuracao::TEMPO_LIMITE_SESSAO_WIFI_MINIMO_MS /
                            1000),
                        static_cast<unsigned long>(
                            configuracao::TEMPO_LIMITE_SESSAO_WIFI_MAXIMO_MS /
                            1000));
            break;
        case CampoPoliticaWifi::RestaurarPadroes:
            break;
    }
    std::fflush(stdout);
}

void solicitar_senha_permissao(const char* operacao) {
    imprimir_linha();
    std::printf("OPERAÇÃO PROTEGIDA: %s\r\n", operacao);
    std::printf("Digite a senha de permissão e pressione Enter para enviar.\r\n");
    std::printf("A entrada será mascarada e não será registrada nos logs.\r\n");
    std::printf("Enter vazio cancela.\r\n> ");
    std::fflush(stdout);
}

bool interpretar_numero(const char* texto, unsigned long* numero) {
    if (texto == nullptr || numero == nullptr || texto[0] == '\0') return false;
    while (*texto == ' ' || *texto == '\t') texto++;
    if (*texto == '\0' || *texto == '+' || *texto == '-') return false;
    errno = 0;
    char* fim = nullptr;
    const unsigned long valor = std::strtoul(texto, &fim, 10);
    while (*fim == ' ' || *fim == '\t') fim++;
    if (errno != 0 || fim == texto || *fim != '\0') return false;
    *numero = valor;
    return true;
}

void solicitar_resumo() {
    std::printf("\r\nPreparando resumo completo...\r\n");
    std::fflush(stdout);
    const esp_err_t erro =
        servico_relatorios_solicitar_resumo_e_aguardar(3000);
    if (erro != ESP_OK) {
        std::printf("[AVISO] O resumo não terminou no prazo: %s\r\n",
                    esp_err_to_name(erro));
    }
}

void alternar_pausa() {
    const bool pausados = servico_relatorios_alternar_pausa();
    std::printf("\r\n[OK] Relatórios periódicos %s.\r\n",
                pausados ? "pausados" : "retomados");
}

void solicitar_nome_audio_treinamento() {
    if (!servico_controle_sensores_ativo(SensorControlado::Microfone)) {
        std::printf("\r\n[AVISO] Microfone pausado. Retome a leitura em Sensores e diagnóstico.\r\n");
        mostrar_menu_principal();
        return;
    }
    tela_atual = TelaTerminal::AudioTreinamentoNome;
    std::memset(&contexto_audio, 0, sizeof(contexto_audio));
    imprimir_titulo("GRAVAÇÃO DO INMP441 | TREINAMENTO DE IA");
    std::printf("O arquivo será salvo em /sdcard/audio_ia no formato WAV,\r\n");
    std::printf("mono, PCM 16 bits e 16 kHz. Um arquivo existente não será alterado.\r\n");
    imprimir_prompt("Digite o nome da amostra. Enter vazio cancela.", "nome");
}

void tratar_duracao_audio_treinamento(unsigned long duracao_segundos) {
    if (duracao_segundos < 1 || duracao_segundos > 60) {
        std::printf("\r\nDuração inválida. Digite um valor entre 1 e 60 segundos.\r\n> ");
        std::fflush(stdout);
        return;
    }

    const EstadoRegistroTelemetria registro =
        servico_registro_telemetria_obter_estado();
    const ResumoWifi wifi = servico_wifi_obter_resumo();
    if (!registro.cartao_disponivel) {
        std::printf("\r\n[ERRO] O cartão SD não está disponível.\r\n");
        tela_atual = TelaTerminal::Principal;
        mostrar_menu_principal();
        return;
    }
    if (registro.sincronizacao_em_andamento || wifi.sessao_em_andamento) {
        std::printf(
            "\r\n[AVISO] Aguarde o término do upload, Wi-Fi ou OTA antes de gravar.\r\n");
        tela_atual = TelaTerminal::Principal;
        mostrar_menu_principal();
        return;
    }

    std::printf("\r\nPrepare-se. A gravação começará em 3 segundos...\r\n");
    std::fflush(stdout);
    for (int contagem = 3; contagem > 0; --contagem) {
        std::printf("  %d...\r\n", contagem);
        std::fflush(stdout);
        vTaskDelay(pdMS_TO_TICKS(1000));
    }
    std::printf("  GRAVANDO — fale agora.\r\n");
    std::fflush(stdout);

    ResultadoGravacaoAudioTreinamento resultado{};
    const esp_err_t erro = servico_gravador_audio_treinamento_gravar(
        contexto_audio.nome, static_cast<uint32_t>(duracao_segundos),
        &resultado);
    if (erro == ESP_OK) {
        const float pico_percentual =
            resultado.pico_absoluto * 100.0f / 32767.0f;
        std::printf("\r\n[OK] Gravação concluída.\r\n");
        std::printf("Arquivo     : %s\r\n", resultado.caminho);
        std::printf("Áudio       : %.2f s | %lu amostras\r\n",
                    resultado.amostras_gravadas / 16000.0f,
                    static_cast<unsigned long>(resultado.amostras_gravadas));
        std::printf("Nível       : pico %.1f%% | saturadas=%lu\r\n",
                    pico_percentual,
                    static_cast<unsigned long>(resultado.amostras_saturadas));
        if (pico_percentual < 3.0f) {
            std::printf(
                "[AVISO] Sinal muito baixo; confira alimentação, canal L/R e distância.\r\n");
        } else if (resultado.amostras_saturadas > 0) {
            std::printf(
                "[AVISO] Houve saturação; aumente a distância ou reduza o ganho.\r\n");
        }
    } else if (resultado.arquivo_existente) {
        std::printf("\r\n[ERRO] %s já existe; escolha outro nome.\r\n",
                    resultado.caminho);
    } else {
        std::printf("\r\n[ERRO] A gravação falhou: %s.\r\n",
                    esp_err_to_name(erro));
        if (resultado.arquivo_parcial && resultado.caminho[0] != '\0') {
            std::printf("O áudio parcial foi preservado em %s.\r\n",
                        resultado.caminho);
        }
    }
    tela_atual = TelaTerminal::Principal;
    mostrar_menu_principal();
}

void tratar_menu_principal(unsigned long opcao) {
    switch (opcao) {
        case 0:
            mostrar_menu_principal();
            break;
        case 1:
            solicitar_resumo();
            mostrar_menu_principal();
            break;
        case 2:
            tela_atual = TelaTerminal::Ota;
            mostrar_menu_ota();
            break;
        case 3:
            tela_atual = TelaTerminal::Intervalos;
            mostrar_menu_intervalos();
            break;
        case 4:
            alternar_pausa();
            mostrar_menu_principal();
            break;
        case 5:
            tela_atual = TelaTerminal::Wifi;
            mostrar_menu_wifi();
            break;
        case 6:
            tela_atual = TelaTerminal::ComandosSatelites;
            mostrar_menu_comandos_satelites();
            break;
        case 7:
            tela_atual = TelaTerminal::Sensores;
            mostrar_menu_sensores();
            break;
        case 8: {
            const EstadoRegistroTelemetria registro =
                servico_registro_telemetria_obter_estado();
            std::printf(
                "\r\nRegistro SD: %s | amostras=%lu | pendentes=%lu | enviados=%lu\r\n",
                registro.cartao_disponivel ? "ativo" : "indisponível",
                static_cast<unsigned long>(registro.amostras_gravadas),
                static_cast<unsigned long>(registro.arquivos_pendentes),
                static_cast<unsigned long>(registro.arquivos_enviados));
            const esp_err_t erro =
                servico_registro_telemetria_solicitar_sincronizacao();
            const ResumoWifi wifi_apos_solicitacao =
                servico_wifi_obter_resumo();
            if (erro == ESP_OK) {
                std::printf(
                    "[OK] Sincronização solicitada; o arquivo atual será fechado e enviado em segundo plano.\r\n");
            } else if (erro == ESP_ERR_INVALID_STATE &&
                       wifi_apos_solicitacao.sessao_em_andamento) {
                std::printf(
                    "[AVISO] Sincronização não iniciada: aguarde a conclusão da %s.\r\n",
                    servico_wifi_nome_finalidade_sessao(
                        wifi_apos_solicitacao.finalidade_sessao));
            } else {
                std::printf("[ERRO] Não foi possível iniciar a sincronização: %s.\r\n",
                            esp_err_to_name(erro));
            }
            mostrar_menu_principal();
            break;
        }
        case 9:
            solicitar_nome_audio_treinamento();
            break;
        case 10:
            tela_atual = TelaTerminal::Logs;
            mostrar_menu_logs();
            break;
        case 11:
            mostrar_estado_rapido();
            mostrar_menu_principal();
            break;
        default:
            std::printf("\r\nOpção inválida. Escolha um número do menu.\r\n> ");
            std::fflush(stdout);
            break;
    }
}

void tratar_menu_sensores(unsigned long opcao) {
    switch (opcao) {
        case 1:
            break;
        case 2: {
            const esp_err_t erro = servico_odometro_zerar_percurso();
            if (erro == ESP_OK) {
                std::printf("\r\n[OK] Percurso da sessão zerado; o odômetro total foi preservado.\r\n");
            } else {
                std::printf("\r\n[ERRO] Não foi possível zerar o percurso: %s.\r\n",
                            esp_err_to_name(erro));
            }
            break;
        }
        case 3:
            solicitar_resumo();
            break;
        case 4:
            tela_atual = TelaTerminal::SensorAdc;
            return;
        case 5:
            tela_atual = TelaTerminal::SensorMpu6050;
            return;
        case 6:
            tela_atual = TelaTerminal::SensorEncoders;
            return;
        case 7:
            tela_atual = TelaTerminal::SensorI2c;
            return;
        case 8:
            tela_atual = TelaTerminal::SensorIna228;
            return;
        case 9:
            tela_atual = TelaTerminal::ControleSensores;
            mostrar_controle_sensores();
            return;
        default:
            std::printf("\r\nOpção inválida. Escolha um número do menu.\r\n");
            break;
    }
    mostrar_menu_sensores();
}

void tratar_controle_sensores(unsigned long opcao) {
    if (opcao == 1 || opcao == 2) {
        servico_controle_sensores_definir_todos(opcao == 2);
        ESP_LOGI(ETIQUETA, "Aquisição de todos os sensores %s pelo terminal",
                 opcao == 2 ? "retomada" : "pausada");
    } else if (opcao >= 3 && opcao <= 8) {
        const SensorControlado sensor =
            static_cast<SensorControlado>(opcao - 3);
        const bool ativar = !servico_controle_sensores_ativo(sensor);
        servico_controle_sensores_definir(sensor, ativar);
        ESP_LOGI(ETIQUETA, "Aquisição do sensor %lu %s pelo terminal",
                 opcao - 3, ativar ? "retomada" : "pausada");
    } else {
        std::printf("\r\nOpção inválida.\r\n");
    }
    mostrar_controle_sensores();
}

bool tela_monitora_sensor() {
    return tela_atual == TelaTerminal::SensorAdc ||
           tela_atual == TelaTerminal::SensorMpu6050 ||
           tela_atual == TelaTerminal::SensorEncoders ||
           tela_atual == TelaTerminal::SensorI2c ||
           tela_atual == TelaTerminal::SensorIna228;
}

void mostrar_monitor_sensor_atual() {
    // Monitores seriais simples não interpretam controle de cursor ANSI; cada
    // atualização é um novo bloco, em intervalo deliberadamente lento.
    std::printf("\r\n");
    switch (tela_atual) {
        case TelaTerminal::SensorAdc:
            mostrar_leitura_adc();
            break;
        case TelaTerminal::SensorMpu6050:
            mostrar_leitura_mpu6050();
            break;
        case TelaTerminal::SensorEncoders:
            mostrar_leitura_encoders();
            break;
        case TelaTerminal::SensorI2c:
            mostrar_leitura_i2c();
            break;
        case TelaTerminal::SensorIna228:
            mostrar_leitura_ina228();
            break;
        default:
            break;
    }
    std::fflush(stdout);
}

void consultar_satelite(DestinoUart destino, codigo_comando_t comando) {
    uint8_t resposta[COMANDO_TAMANHO_MAXIMO_CARGA]{};
    uint16_t tamanho = 0;
    codigo_resposta_comando_t resultado = RESPOSTA_COMANDO_TIMEOUT;
    const int64_t inicio_us = esp_timer_get_time();
    const esp_err_t erro = servico_comandos_solicitar(
        destino, comando, nullptr, 0, resposta, sizeof(resposta), &tamanho,
        &resultado, pdMS_TO_TICKS(700));
    const char* nome = destino == DestinoUart::Equipe ? "equipe" : "visitantes";
    if (erro != ESP_OK) {
        std::printf("\r\n[ERRO] %s não respondeu: %s.\r\n", nome,
                    esp_err_to_name(erro));
        return;
    }
    if (resultado != RESPOSTA_COMANDO_OK) {
        std::printf("\r\n[ERRO] %s recusou a consulta (código %u).\r\n", nome,
                    static_cast<unsigned>(resultado));
        return;
    }
    if (comando == COMANDO_PING && tamanho == sizeof(resposta_comando_ping_t)) {
        resposta_comando_ping_t ping{};
        std::memcpy(&ping, resposta, sizeof(ping));
        const uint32_t rtt_ms = static_cast<uint32_t>(
            (esp_timer_get_time() - inicio_us) / 1000);
        std::printf("\r\n[OK] %s respondeu em %lu ms; ativo há %lu ms.\r\n",
                    nome, static_cast<unsigned long>(rtt_ms),
                    static_cast<unsigned long>(ping.tempo_ativo_ms));
    } else if (comando == COMANDO_OBTER_VERSAO &&
               tamanho == sizeof(resposta_comando_versao_t)) {
        resposta_comando_versao_t versao{};
        std::memcpy(&versao, resposta, sizeof(versao));
        versao.versao[sizeof(versao.versao) - 1] = '\0';
        std::printf("\r\n[OK] %s: firmware=%s.\r\n",
                    nome, versao.versao);
    } else {
        std::printf("\r\n[ERRO] Resposta de %s possui tamanho incompatível.\r\n",
                    nome);
    }
}

void tratar_menu_comandos_satelites(unsigned long opcao) {
    switch (opcao) {
        case 1: consultar_satelite(DestinoUart::Equipe, COMANDO_PING); break;
        case 2: consultar_satelite(DestinoUart::Visitantes, COMANDO_PING); break;
        case 3:
            consultar_satelite(DestinoUart::Equipe, COMANDO_OBTER_VERSAO);
            break;
        case 4:
            consultar_satelite(DestinoUart::Visitantes, COMANDO_OBTER_VERSAO);
            break;
        default:
            std::printf("\r\nOpção inválida. Escolha um número do menu.\r\n");
            break;
    }
    mostrar_menu_comandos_satelites();
}

void informar_resultado_ota(const char* acao, esp_err_t resultado);

void tratar_intervalo_ota(unsigned long opcao) {
    constexpr uint32_t OPCOES_MINUTOS[] = {5, 15, 30, 60, 360, 1440};
    if (opcao < 1 || opcao > (sizeof(OPCOES_MINUTOS) / sizeof(OPCOES_MINUTOS[0]))) {
        std::printf("\r\nOpção inválida. Escolha um número do menu.\r\n");
        mostrar_intervalos_ota();
        return;
    }
    const uint32_t minutos = OPCOES_MINUTOS[opcao - 1];
    informar_resultado_ota("alterar o intervalo das verificações",
                           servico_ota_definir_intervalo_verificacao(minutos));
    tela_atual = TelaTerminal::Ota;
    mostrar_menu_ota();
}

void tratar_intervalo_telemetria_ota(unsigned long opcao) {
    constexpr uint32_t OPCOES_MS[] = {500, 1000, 2000, 5000, 10000};
    if (opcao < 1 || opcao > (sizeof(OPCOES_MS) / sizeof(OPCOES_MS[0]))) {
        std::printf("\r\nOpção inválida. Escolha um número do menu.\r\n");
        mostrar_intervalos_telemetria_ota();
        return;
    }
    const esp_err_t erro = servico_telemetria_definir_intervalo_durante_ota(
        OPCOES_MS[opcao - 1]);
    if (erro == ESP_OK) {
        std::printf("\r\n[OK] Intervalo da telemetria durante OTA atualizado.\r\n");
    } else {
        std::printf("\r\n[ERRO] Não foi possível alterar o intervalo: %s.\r\n",
                    esp_err_to_name(erro));
    }
    tela_atual = TelaTerminal::Ota;
    mostrar_menu_ota();
}

void informar_resultado_ota(const char* acao, esp_err_t resultado) {
    const ResumoWifi wifi = servico_wifi_obter_resumo();
    if (resultado == ESP_OK) {
        std::printf("\r\n[OK] Solicitação recebida: %s.\r\n", acao);
    } else if (resultado == ESP_ERR_INVALID_STATE &&
               wifi.sessao_em_andamento) {
        std::printf(
            "\r\n[AVISO] Não foi possível %s: aguarde a conclusão da %s.\r\n",
            acao,
            servico_wifi_nome_finalidade_sessao(wifi.finalidade_sessao));
    } else {
        std::printf("\r\n[ERRO] Não foi possível %s: %s. Consulte o estado da OTA.\r\n",
                    acao, esp_err_to_name(resultado));
    }
}

void tratar_menu_ota(unsigned long opcao) {
    switch (opcao) {
        case 1:
            break;
        case 2:
            informar_resultado_ota("verificar atualizações",
                                   servico_ota_solicitar_verificacao());
            break;
        case 3:
            informar_resultado_ota("autorizar a atualização",
                                   servico_ota_autorizar_atualizacao());
            break;
        case 4:
            informar_resultado_ota("autorizar a atualização do satélite da equipe",
                servico_ota_autorizar_atualizacao_satelite(AlvoOta::Equipe));
            break;
        case 5:
            informar_resultado_ota("autorizar a atualização do satélite de visitantes",
                servico_ota_autorizar_atualizacao_satelite(AlvoOta::Visitantes));
            break;
        case 6:
            informar_resultado_ota(
                "autorizar a atualização de todos os controladores",
                servico_ota_autorizar_atualizacao_todos());
            break;
        case 7:
            informar_resultado_ota("cancelar as atualizações pendentes",
                                   servico_ota_cancelar_atualizacao());
            break;
        case 8:
            tela_atual = TelaTerminal::OtaIntervalo;
            mostrar_intervalos_ota();
            return;
        case 9:
            tela_atual = TelaTerminal::OtaIntervaloTelemetria;
            mostrar_intervalos_telemetria_ota();
            return;
        default:
            std::printf("\r\nOpção inválida. Escolha um número do menu.\r\n");
            break;
    }
    mostrar_menu_ota();
}

void tratar_menu_intervalos(unsigned long opcao) {
    const size_t quantidade = static_cast<size_t>(GrupoRelatorio::Quantidade);
    if (opcao < 1 || opcao > quantidade) {
        std::printf("\r\nOpção inválida. Escolha um número do menu.\r\n");
        mostrar_menu_intervalos();
        return;
    }
    grupo_em_edicao = static_cast<GrupoRelatorio>(opcao - 1);
    tela_atual = TelaTerminal::EscolherIntervalo;
    mostrar_opcoes_intervalo();
}

void tratar_escolha_intervalo(unsigned long opcao) {
    constexpr uint32_t OPCOES_MS[] = {500, 1000, 2000, 5000, 10000, 30000, 0};
    if (opcao < 1 || opcao > (sizeof(OPCOES_MS) / sizeof(OPCOES_MS[0]))) {
        std::printf("\r\nOpção inválida. Escolha um número do menu.\r\n");
        mostrar_opcoes_intervalo();
        return;
    }

    const esp_err_t erro = servico_relatorios_definir_intervalo(
        grupo_em_edicao, OPCOES_MS[opcao - 1]);
    if (erro != ESP_OK) {
        std::printf("\r\n[ERRO] Não foi possível alterar o intervalo: %s\r\n",
                    esp_err_to_name(erro));
    } else {
        std::printf("\r\nIntervalo de '%s' atualizado.\r\n",
                    servico_relatorios_nome_grupo(grupo_em_edicao));
    }
    tela_atual = TelaTerminal::Intervalos;
    mostrar_menu_intervalos();
}

void limpar_dados_wifi_pendentes() {
    contexto_wifi = {};
}

void voltar_menu_wifi() {
    limpar_dados_wifi_pendentes();
    tela_atual = TelaTerminal::Wifi;
    mostrar_menu_wifi();
}

void informar_resultado_wifi(const char* sucesso, const char* falha,
                             esp_err_t resultado) {
    if (resultado == ESP_OK) {
        std::printf("\r\n[OK] %s\r\n", sucesso);
    } else {
        std::printf("\r\n[ERRO] %s: %s.\r\n", falha, esp_err_to_name(resultado));
    }
}

void tratar_menu_wifi(unsigned long opcao) {
    switch (opcao) {
        case 1:
            mostrar_menu_wifi();
            return;
        case 2:
            tela_atual = TelaTerminal::WifiNovaSsid;
            solicitar_ssid_nova_rede();
            return;
        case 3:
            tela_atual = TelaTerminal::WifiEscolherConexao;
            mostrar_escolha_rede("AUTORIZAR CONEXÃO A UMA REDE SALVA");
            return;
        case 4:
            tela_atual = TelaTerminal::WifiEscolherExclusao;
            mostrar_escolha_rede("EXCLUIR UMA REDE SALVA");
            return;
        case 5:
            tela_atual = TelaTerminal::WifiEscolherAutomatico;
            mostrar_menu_automatico();
            return;
        case 6:
            tela_atual = TelaTerminal::WifiSenhaPrincipal;
            solicitar_senha_permissao("alterar a rede principal");
            return;
        case 7:
            tela_atual = TelaTerminal::WifiSenhaRestaurar;
            solicitar_senha_permissao("restaurar a rede principal do firmware");
            return;
        case 8:
            tela_atual = TelaTerminal::WifiPolitica;
            mostrar_menu_politica_wifi();
            return;
        default:
            std::printf("\r\nOpção inválida. Escolha um número do menu.\r\n");
            mostrar_menu_wifi();
            return;
    }
}

void tratar_menu_politica_wifi(unsigned long opcao) {
    if (opcao < 1 || opcao > 5) {
        std::printf("\r\nOpção inválida. Escolha um número do menu.\r\n");
        mostrar_menu_politica_wifi();
        return;
    }
    contexto_wifi.politica = servico_wifi_obter_resumo().politica;
    if (opcao == 5) {
        contexto_wifi.politica = {};
        contexto_wifi.campo_politica = CampoPoliticaWifi::RestaurarPadroes;
        tela_atual = TelaTerminal::WifiSenhaPolitica;
        solicitar_senha_permissao("restaurar a política Wi-Fi padrão");
        return;
    }
    contexto_wifi.campo_politica =
        static_cast<CampoPoliticaWifi>(opcao - 1);
    tela_atual = TelaTerminal::WifiPoliticaValor;
    solicitar_valor_politica_wifi();
}

void tratar_valor_politica_wifi(unsigned long valor) {
    switch (contexto_wifi.campo_politica) {
        case CampoPoliticaWifi::Tentativas:
            if (valor < configuracao::TENTATIVAS_WIFI_MINIMAS ||
                valor > configuracao::TENTATIVAS_WIFI_MAXIMAS) {
                std::printf("\r\nQuantidade de tentativas fora da faixa permitida.\r\n");
                solicitar_valor_politica_wifi();
                return;
            }
            contexto_wifi.politica.tentativas_por_rede =
                static_cast<uint8_t>(valor);
            break;
        case CampoPoliticaWifi::TempoTentativa:
            if (valor <
                    configuracao::TEMPO_TENTATIVA_WIFI_MINIMO_MS / 1000 ||
                valor >
                    configuracao::TEMPO_TENTATIVA_WIFI_MAXIMO_MS / 1000) {
                std::printf("\r\nTempo por tentativa fora da faixa permitida.\r\n");
                solicitar_valor_politica_wifi();
                return;
            }
            contexto_wifi.politica.tempo_por_tentativa_ms =
                static_cast<uint32_t>(valor * 1000UL);
            break;
        case CampoPoliticaWifi::IntervaloTentativas:
            if (valor <
                    configuracao::INTERVALO_TENTATIVAS_WIFI_MINIMO_MS ||
                valor >
                    configuracao::INTERVALO_TENTATIVAS_WIFI_MAXIMO_MS) {
                std::printf("\r\nIntervalo entre tentativas fora da faixa permitida.\r\n");
                solicitar_valor_politica_wifi();
                return;
            }
            contexto_wifi.politica.intervalo_entre_tentativas_ms =
                static_cast<uint32_t>(valor);
            break;
        case CampoPoliticaWifi::TempoSessao:
            if (valor <
                    configuracao::TEMPO_LIMITE_SESSAO_WIFI_MINIMO_MS / 1000 ||
                valor >
                    configuracao::TEMPO_LIMITE_SESSAO_WIFI_MAXIMO_MS / 1000) {
                std::printf("\r\nLimite da sessão fora da faixa permitida.\r\n");
                solicitar_valor_politica_wifi();
                return;
            }
            contexto_wifi.politica.tempo_limite_sessao_ms =
                static_cast<uint32_t>(valor * 1000UL);
            break;
        case CampoPoliticaWifi::RestaurarPadroes:
            break;
    }

    if (!servico_wifi_politica_valida(contexto_wifi.politica)) {
        std::printf(
            "\r\nValor inválido. Confira a faixa indicada; o limite da sessão "
            "também deve ser igual ou maior que o tempo de uma tentativa.\r\n");
        solicitar_valor_politica_wifi();
        return;
    }
    tela_atual = TelaTerminal::WifiSenhaPolitica;
    solicitar_senha_permissao("alterar a política de conexão Wi-Fi");
}

void tratar_confirmacao_nova_rede(unsigned long opcao) {
    if (opcao == 2) {
        voltar_menu_wifi();
        return;
    }
    if (opcao != 1) {
        std::printf("\r\nOpção inválida.\r\n");
        mostrar_confirmacao_nova_rede();
        return;
    }

    std::printf("\r\nTentando conectar à rede '%s'...\r\n", contexto_wifi.ssid);
    std::fflush(stdout);
    const esp_err_t erro = servico_wifi_conectar_rede_informada(
        contexto_wifi.ssid, contexto_wifi.senha);
    if (erro != ESP_OK) {
        informar_resultado_wifi("", "Não foi possível conectar", erro);
        voltar_menu_wifi();
        return;
    }
    tela_atual = TelaTerminal::WifiNovaConfirmarSalvar;
    mostrar_confirmacao_salvar_rede();
}

void tratar_confirmacao_salvar_rede(unsigned long opcao) {
    if (opcao == 1) {
        const esp_err_t erro = servico_wifi_salvar_rede_usuario(
            contexto_wifi.ssid, contexto_wifi.senha);
        informar_resultado_wifi("Rede salva com sucesso.",
                               "A rede foi conectada, mas não pôde ser salva", erro);
        voltar_menu_wifi();
        return;
    }
    if (opcao == 2) {
        std::printf("\r\nA rede não foi salva. O rádio Wi-Fi voltou ao repouso.\r\n");
        voltar_menu_wifi();
        return;
    }
    std::printf("\r\nOpção inválida.\r\n");
    mostrar_confirmacao_salvar_rede();
}

void tratar_escolha_rede_salva(unsigned long opcao, bool excluir) {
    const ResumoWifi wifi = servico_wifi_obter_resumo();
    if (opcao < 1 || opcao > wifi.quantidade_redes_usuario) {
        std::printf("\r\nRede inválida. Escolha um número da lista.\r\n");
        mostrar_escolha_rede(excluir ? "EXCLUIR UMA REDE SALVA" :
                                     "AUTORIZAR CONEXÃO A UMA REDE SALVA");
        return;
    }
    contexto_wifi.indice_rede = static_cast<size_t>(opcao - 1);
    tela_atual = excluir ? TelaTerminal::WifiConfirmarExclusao
                         : TelaTerminal::WifiConfirmarConexao;
    mostrar_confirmacao_rede_salva(excluir ? "EXCLUSÃO" : "CONEXÃO");
}

void tratar_confirmacao_rede_salva(unsigned long opcao, bool excluir) {
    if (opcao == 2) {
        voltar_menu_wifi();
        return;
    }
    if (opcao != 1) {
        std::printf("\r\nOpção inválida.\r\n");
        mostrar_confirmacao_rede_salva(excluir ? "EXCLUSÃO" : "CONEXÃO");
        return;
    }
    const esp_err_t erro = excluir
        ? servico_wifi_excluir_rede_usuario(contexto_wifi.indice_rede)
        : servico_wifi_conectar_rede_salva(contexto_wifi.indice_rede);
    informar_resultado_wifi(excluir ? "Rede excluída com sucesso."
                                    : "Rede validada e autorizada para a próxima operação; o rádio voltou ao repouso.",
                           excluir ? "Não foi possível excluir a rede"
                                   : "Não foi possível conectar à rede",
                           erro);
    voltar_menu_wifi();
}

void tratar_escolha_automatico(unsigned long opcao) {
    if (opcao != 1 && opcao != 2) {
        std::printf("\r\nOpção inválida.\r\n");
        mostrar_menu_automatico();
        return;
    }
    contexto_wifi.automatico = opcao == 1;
    tela_atual = TelaTerminal::WifiSenhaAutomatico;
    solicitar_senha_permissao("alterar a autorização automática");
}

void tratar_confirmacao_principal(unsigned long opcao) {
    if (opcao == 2) {
        voltar_menu_wifi();
        return;
    }
    if (opcao != 1) {
        std::printf("\r\nOpção inválida.\r\n");
        mostrar_confirmacao_nova_principal();
        return;
    }
    const esp_err_t erro = servico_wifi_alterar_rede_principal(
        contexto_wifi.ssid, contexto_wifi.senha, contexto_wifi.permissao);
    informar_resultado_wifi("Rede principal alterada e salva com sucesso.",
                           "Não foi possível alterar a rede principal", erro);
    voltar_menu_wifi();
}

void tratar_confirmacao_restaurar(unsigned long opcao) {
    if (opcao == 2) {
        voltar_menu_wifi();
        return;
    }
    if (opcao != 1) {
        std::printf("\r\nOpção inválida.\r\n");
        mostrar_confirmacao_restaurar_principal();
        return;
    }
    const esp_err_t erro = servico_wifi_restaurar_rede_principal(
        contexto_wifi.permissao);
    informar_resultado_wifi("Rede principal do firmware restaurada com sucesso.",
                           "Não foi possível restaurar a rede principal", erro);
    voltar_menu_wifi();
}

bool tela_recebe_texto_wifi() {
    return tela_atual == TelaTerminal::WifiNovaSsid ||
           tela_atual == TelaTerminal::WifiNovaSenha ||
           tela_atual == TelaTerminal::WifiSenhaAutomatico ||
           tela_atual == TelaTerminal::WifiSenhaPrincipal ||
           tela_atual == TelaTerminal::WifiPrincipalSsid ||
           tela_atual == TelaTerminal::WifiPrincipalSenha ||
           tela_atual == TelaTerminal::WifiSenhaRestaurar ||
           tela_atual == TelaTerminal::WifiSenhaPolitica;
}

bool tela_oculta_entrada() {
    return tela_atual == TelaTerminal::WifiSenhaAutomatico ||
           tela_atual == TelaTerminal::WifiSenhaPrincipal ||
           tela_atual == TelaTerminal::WifiSenhaRestaurar ||
           tela_atual == TelaTerminal::WifiSenhaPolitica;
}

int ler_caractere_console() {
    if (caractere_pendente != EOF) {
        const int caractere = caractere_pendente;
        caractere_pendente = EOF;
        return caractere;
    }
    return std::getchar();
}

void consumir_segunda_quebra_de_linha() {
    if (!entrada_console_nao_bloqueante) return;

    // CRLF chega como dois bytes. O segundo precisa ser consumido antes que o
    // menu seja desenhado; caso contrário ele pareceria um novo Enter vazio.
    for (unsigned tentativa = 0; tentativa < 4; ++tentativa) {
        const int proximo = std::getchar();
        if (proximo == EOF) {
            clearerr(stdin);
            vTaskDelay(pdMS_TO_TICKS(1));
            continue;
        }
        if (proximo != '\r' && proximo != '\n') {
            caractere_pendente = proximo;
        }
        return;
    }
}

void monitorar_sensor_ate_sair() {
    int64_t proxima_atualizacao_ms = 0;
    while (tela_monitora_sensor()) {
        const int64_t agora_ms = esp_timer_get_time() / 1000;
        if (agora_ms >= proxima_atualizacao_ms) {
            mostrar_monitor_sensor_atual();
            proxima_atualizacao_ms =
                agora_ms + configuracao::INTERVALO_MONITOR_SENSORES_MS;
        }

        const int recebido = ler_caractere_console();
        if (recebido == EOF) {
            clearerr(stdin);
            vTaskDelay(pdMS_TO_TICKS(10));
            continue;
        }

        const uint8_t caractere = static_cast<uint8_t>(recebido);
        if (caractere == '\r' || caractere == '\n' || caractere == 0x03) {
            if (caractere == '\r' || caractere == '\n') {
                consumir_segunda_quebra_de_linha();
            }
            return;
        }
        // A tela ao vivo não possui comandos: caracteres diferentes de Enter
        // são ignorados para não corromper o desenho durante a atualização.
    }
}

ResultadoLeituraLinha ler_linha_interativa(char* linha, size_t capacidade,
                                            bool ocultar) {
    if (linha == nullptr || capacidade < 2) {
        return ResultadoLeituraLinha::LongaDemais;
    }

    size_t tamanho = 0;
    size_t caracteres_excedentes = 0;
    uint8_t caracteres_escape_restantes = 0;
    const bool silenciosa = tela_atual == TelaTerminal::WifiNovaSenha ||
                            tela_atual == TelaTerminal::WifiPrincipalSenha;
    linha[0] = '\0';

    while (true) {
        const int recebido = ler_caractere_console();
        if (recebido == EOF) {
            clearerr(stdin);
            vTaskDelay(pdMS_TO_TICKS(10));
            continue;
        }

        const uint8_t caractere = static_cast<uint8_t>(recebido);
        if (caractere == '\r' || caractere == '\n') {
            consumir_segunda_quebra_de_linha();
            std::printf("\r\n");
            linha[tamanho] = '\0';
            return caracteres_excedentes != 0
                       ? ResultadoLeituraLinha::LongaDemais
                       : ResultadoLeituraLinha::Concluida;
        }

        if (caracteres_escape_restantes != 0) {
            caracteres_escape_restantes--;
            continue;
        }
        if (caractere == 0x1B) {
            // Ignora sequências simples emitidas pelas setas do teclado.
            caracteres_escape_restantes = 2;
            continue;
        }
        if (caractere == 0x03) {
            // Ctrl+C tem o mesmo efeito de uma linha vazia: cancela a etapa.
            tamanho = 0;
            linha[0] = '\0';
            std::printf("^C\r\n");
            return ResultadoLeituraLinha::Concluida;
        }
        if (caractere == 0x15) {
            // Ctrl+U apaga toda a linha sem depender do programa de terminal.
            while (tamanho != 0) {
                if (!silenciosa) std::printf("\b \b");
                tamanho--;
            }
            caracteres_excedentes = 0;
            linha[0] = '\0';
            std::fflush(stdout);
            continue;
        }
        if (caractere == '\b' || caractere == 0x7F) {
            if (caracteres_excedentes != 0) {
                caracteres_excedentes--;
                continue;
            }
            if (tamanho != 0) {
                tamanho--;
                linha[tamanho] = '\0';
                if (!silenciosa) std::printf("\b \b");
                std::fflush(stdout);
            }
            continue;
        }
        if (caractere < 0x20 || caractere == 0x7F) continue;

        if (tamanho + 1 >= capacidade) {
            if (caracteres_excedentes == 0) {
                std::printf("\a");
                std::fflush(stdout);
            }
            caracteres_excedentes++;
            continue;
        }

        linha[tamanho++] = static_cast<char>(caractere);
        linha[tamanho] = '\0';
        if (!silenciosa) std::putchar(ocultar ? '*' : static_cast<char>(caractere));
        std::fflush(stdout);
    }
}

void tratar_texto_wifi(const char* texto) {
    const size_t tamanho = std::strlen(texto);
    if (tela_atual == TelaTerminal::WifiNovaSsid ||
        tela_atual == TelaTerminal::WifiPrincipalSsid) {
        if (tamanho < 1 || tamanho > 32) {
            std::printf("\r\nO SSID deve ter entre 1 e 32 caracteres.\r\n> ");
            std::fflush(stdout);
            return;
        }
        std::strncpy(contexto_wifi.ssid, texto, sizeof(contexto_wifi.ssid) - 1);
        if (tela_atual == TelaTerminal::WifiNovaSsid) {
            tela_atual = TelaTerminal::WifiNovaSenha;
            solicitar_senha_rede("SENHA DA NOVA REDE");
        } else {
            tela_atual = TelaTerminal::WifiPrincipalSenha;
            solicitar_senha_rede("SENHA DA NOVA REDE PRINCIPAL");
        }
        return;
    }

    if (tela_atual == TelaTerminal::WifiNovaSenha ||
        tela_atual == TelaTerminal::WifiPrincipalSenha) {
        if ((tamanho != 0 && tamanho < 8) || tamanho > 63) {
            std::printf("\r\nUse senha vazia para rede aberta ou 8 a 63 caracteres.\r\n> ");
            std::fflush(stdout);
            return;
        }
        std::strncpy(contexto_wifi.senha, texto,
                     sizeof(contexto_wifi.senha) - 1);
        if (tela_atual == TelaTerminal::WifiNovaSenha) {
            tela_atual = TelaTerminal::WifiNovaConfirmarConexao;
            mostrar_confirmacao_nova_rede();
        } else {
            tela_atual = TelaTerminal::WifiPrincipalConfirmar;
            mostrar_confirmacao_nova_principal();
        }
        return;
    }

    if (!servico_wifi_validar_permissao(texto)) {
        ESP_LOGW(ETIQUETA, "Operação Wi-Fi protegida recusada: senha de permissão incorreta");
        std::printf("\r\nSenha de permissão incorreta. Operação cancelada.\r\n");
        voltar_menu_wifi();
        return;
    }

    std::strncpy(contexto_wifi.permissao, texto,
                 sizeof(contexto_wifi.permissao) - 1);
    if (tela_atual == TelaTerminal::WifiSenhaAutomatico) {
        const esp_err_t erro = servico_wifi_definir_conexao_automatica(
            contexto_wifi.automatico, contexto_wifi.permissao);
        informar_resultado_wifi(
            contexto_wifi.automatico
                ? "Conexão automática às redes secundárias habilitada."
                : "As redes secundárias voltarão a exigir autorização.",
            "Não foi possível salvar a preferência", erro);
        voltar_menu_wifi();
    } else if (tela_atual == TelaTerminal::WifiSenhaPolitica) {
        const esp_err_t erro = servico_wifi_definir_politica(
            contexto_wifi.politica, contexto_wifi.permissao);
        informar_resultado_wifi(
            "Política de conexão Wi-Fi salva com sucesso.",
            "Não foi possível salvar a política de conexão", erro);
        voltar_menu_wifi();
    } else if (tela_atual == TelaTerminal::WifiSenhaPrincipal) {
        tela_atual = TelaTerminal::WifiPrincipalSsid;
        std::memset(contexto_wifi.ssid, 0, sizeof(contexto_wifi.ssid));
        std::memset(contexto_wifi.senha, 0, sizeof(contexto_wifi.senha));
        imprimir_linha();
        std::printf("NOVA REDE PRINCIPAL\r\n");
        std::printf("Digite o SSID e pressione Enter para enviar. Enter vazio cancela.\r\n> ");
        std::fflush(stdout);
    } else {
        tela_atual = TelaTerminal::WifiRestaurarConfirmar;
        mostrar_confirmacao_restaurar_principal();
    }
}

void voltar_uma_tela() {
    if (tela_atual == TelaTerminal::Principal) {
        mostrar_menu_principal();
    } else if (tela_atual == TelaTerminal::EscolherIntervalo) {
        tela_atual = TelaTerminal::Intervalos;
        mostrar_menu_intervalos();
    } else if (tela_atual == TelaTerminal::OtaIntervalo ||
               tela_atual == TelaTerminal::OtaIntervaloTelemetria) {
        tela_atual = TelaTerminal::Ota;
        mostrar_menu_ota();
    } else if (tela_atual == TelaTerminal::SensorAdc ||
               tela_atual == TelaTerminal::SensorMpu6050 ||
               tela_atual == TelaTerminal::SensorEncoders ||
               tela_atual == TelaTerminal::SensorI2c ||
               tela_atual == TelaTerminal::SensorIna228) {
        tela_atual = TelaTerminal::Sensores;
        mostrar_menu_sensores();
    } else if (tela_atual == TelaTerminal::ControleSensores) {
        tela_atual = TelaTerminal::Sensores;
        mostrar_menu_sensores();
    } else if (tela_atual == TelaTerminal::AudioTreinamentoNome ||
               tela_atual == TelaTerminal::AudioTreinamentoDuracao) {
        tela_atual = TelaTerminal::Principal;
        mostrar_menu_principal();
    } else if (tela_atual == TelaTerminal::Logs ||
               tela_atual == TelaTerminal::Ota ||
               tela_atual == TelaTerminal::Sensores ||
               tela_atual == TelaTerminal::Intervalos ||
               tela_atual == TelaTerminal::ComandosSatelites ||
               tela_atual == TelaTerminal::Wifi) {
        tela_atual = TelaTerminal::Principal;
        mostrar_menu_principal();
    } else if (tela_atual == TelaTerminal::WifiPoliticaValor ||
               tela_atual == TelaTerminal::WifiSenhaPolitica) {
        tela_atual = TelaTerminal::WifiPolitica;
        mostrar_menu_politica_wifi();
    } else if (tela_atual == TelaTerminal::WifiPolitica) {
        voltar_menu_wifi();
    } else {
        voltar_menu_wifi();
    }
}

void tratar_escolha_conexao(unsigned long opcao) {
    tratar_escolha_rede_salva(opcao, false);
}

void tratar_confirmacao_conexao(unsigned long opcao) {
    tratar_confirmacao_rede_salva(opcao, false);
}

void tratar_escolha_exclusao(unsigned long opcao) {
    tratar_escolha_rede_salva(opcao, true);
}

void tratar_confirmacao_exclusao(unsigned long opcao) {
    tratar_confirmacao_rede_salva(opcao, true);
}

constexpr RotaTerminal ROTAS_TERMINAL[] = {
    {TelaTerminal::Principal, tratar_menu_principal},
    {TelaTerminal::Logs, tratar_menu_logs},
    {TelaTerminal::Sensores, tratar_menu_sensores},
    {TelaTerminal::ControleSensores, tratar_controle_sensores},
    {TelaTerminal::Ota, tratar_menu_ota},
    {TelaTerminal::OtaIntervalo, tratar_intervalo_ota},
    {TelaTerminal::OtaIntervaloTelemetria,
     tratar_intervalo_telemetria_ota},
    {TelaTerminal::Intervalos, tratar_menu_intervalos},
    {TelaTerminal::EscolherIntervalo, tratar_escolha_intervalo},
    {TelaTerminal::ComandosSatelites, tratar_menu_comandos_satelites},
    {TelaTerminal::AudioTreinamentoDuracao,
     tratar_duracao_audio_treinamento},
    {TelaTerminal::Wifi, tratar_menu_wifi},
    {TelaTerminal::WifiPolitica, tratar_menu_politica_wifi},
    {TelaTerminal::WifiPoliticaValor, tratar_valor_politica_wifi},
    {TelaTerminal::WifiNovaConfirmarConexao, tratar_confirmacao_nova_rede},
    {TelaTerminal::WifiNovaConfirmarSalvar, tratar_confirmacao_salvar_rede},
    {TelaTerminal::WifiEscolherConexao, tratar_escolha_conexao},
    {TelaTerminal::WifiConfirmarConexao, tratar_confirmacao_conexao},
    {TelaTerminal::WifiEscolherExclusao, tratar_escolha_exclusao},
    {TelaTerminal::WifiConfirmarExclusao, tratar_confirmacao_exclusao},
    {TelaTerminal::WifiEscolherAutomatico, tratar_escolha_automatico},
    {TelaTerminal::WifiPrincipalConfirmar, tratar_confirmacao_principal},
    {TelaTerminal::WifiRestaurarConfirmar, tratar_confirmacao_restaurar},
};

bool despachar_opcao(TelaTerminal tela, unsigned long opcao) {
    for (const RotaTerminal& rota : ROTAS_TERMINAL) {
        if (rota.tela == tela) {
            rota.tratar(opcao);
            return true;
        }
    }
    return false;
}

void tarefa_terminal(void*) {
    char linha[TAMANHO_MAXIMO_LINHA]{};
    // O console passa a entregar cada tecla imediatamente. A própria rotina de
    // leitura abaixo reconhece CR, LF e CRLF, independentemente do monitor usado.
    std::setvbuf(stdin, nullptr, _IONBF, 0);
    const int flags_entrada = fcntl(STDIN_FILENO, F_GETFL, 0);
    entrada_console_nao_bloqueante =
        flags_entrada >= 0 &&
        fcntl(STDIN_FILENO, F_SETFL, flags_entrada | O_NONBLOCK) == 0;
    if (!entrada_console_nao_bloqueante) {
        ESP_LOGW(ETIQUETA,
                 "Console não aceitou modo não bloqueante; CR e LF isolados continuam suportados");
    }
    mostrar_menu_principal();
    while (true) {
        if (tela_monitora_sensor()) {
            monitorar_sensor_ate_sair();
            tela_atual = TelaTerminal::Sensores;
            mostrar_menu_sensores();
            continue;
        }
        const ResultadoLeituraLinha leitura = ler_linha_interativa(
            linha, sizeof(linha), tela_oculta_entrada());
        if (leitura == ResultadoLeituraLinha::LongaDemais) {
            std::printf("\r\nEntrada longa demais. Operação cancelada.\r\n");
            voltar_uma_tela();
            continue;
        }
        if (linha[0] == '\0' && tela_atual != TelaTerminal::WifiNovaSenha &&
            tela_atual != TelaTerminal::WifiPrincipalSenha) {
            voltar_uma_tela();
            continue;
        }

        if (tela_recebe_texto_wifi()) {
            tratar_texto_wifi(linha);
            continue;
        }

        if (tela_atual == TelaTerminal::AudioTreinamentoNome) {
            std::strncpy(contexto_audio.nome, linha,
                         sizeof(contexto_audio.nome) - 1);
            contexto_audio.nome[sizeof(contexto_audio.nome) - 1] = '\0';
            tela_atual = TelaTerminal::AudioTreinamentoDuracao;
            imprimir_prompt(
                "Digite a duração entre 1 e 60 segundos. Enter vazio cancela.",
                "segundos");
            continue;
        }

        unsigned long opcao = 0;
        if (!interpretar_numero(linha, &opcao)) {
            std::printf("\r\nEntrada inválida. Digite somente o número da opção.\r\n> ");
            std::fflush(stdout);
            continue;
        }

        if (!despachar_opcao(tela_atual, opcao)) {
            ESP_LOGE(ETIQUETA,
                     "Tela sem tratador numérico; retornando ao menu principal");
            tela_atual = TelaTerminal::Principal;
            mostrar_menu_principal();
        }
    }
}
}  // namespace

esp_err_t servico_terminal_iniciar() {
    if (iniciado) return ESP_OK;
    if (configuracao::criar_tarefa(tarefa_terminal, "terminal", nullptr, nullptr) != pdPASS) {
        ESP_LOGE(ETIQUETA, "Não foi possível iniciar o menu serial");
        return ESP_ERR_NO_MEM;
    }
    iniciado = true;
    return ESP_OK;
}
