thegm-Gabriel/instrumentacao-ElectricCarUFSM/firmware/mestre-s3/src/servicos/servico_aceleracao.cpp

// Implementa aquisição filtrada e calibração do movimento longitudinal.
#include "nucleo/configuracao_tarefas.h"
#include "servicos/servico_supervisao.h"
#include "servicos/servico_aceleracao.h"
#include "servicos/servico_controle_sensores.h"

#include <algorithm>
#include <cmath>

#include "esp_log.h"
#include "esp_timer.h"
#include "freertos/FreeRTOS.h"
#include "freertos/task.h"

namespace {
constexpr char ETIQUETA[] = "servico_aceleracao";
constexpr float GRAVIDADE_PADRAO_MS2 = 9.80665f;
constexpr float DOIS_PI = 6.28318530717958647692f;
constexpr float GRAUS_PARA_RADIANOS = 0.01745329251994329577f;

ConfiguracaoServicoAceleracao parametros{};
EstadoServicoAceleracao estado{};
portMUX_TYPE trava_estado = portMUX_INITIALIZER_UNLOCKED;
TaskHandle_t tarefa_handle = nullptr;

struct Vetor3 {
    float x = 0.0f;
    float y = 0.0f;
    float z = 0.0f;
};

Vetor3 aceleracao_vetor(const LeituraMpu6050& leitura) {
    return {leitura.aceleracao_x_g, leitura.aceleracao_y_g,
            leitura.aceleracao_z_g};
}

Vetor3 giroscopio_vetor(const LeituraMpu6050& leitura) {
    return {leitura.giroscopio_x_graus_s,
            leitura.giroscopio_y_graus_s,
            leitura.giroscopio_z_graus_s};
}

Vetor3 somar(const Vetor3& a, const Vetor3& b) {
    return {a.x + b.x, a.y + b.y, a.z + b.z};
}

Vetor3 subtrair(const Vetor3& a, const Vetor3& b) {
    return {a.x - b.x, a.y - b.y, a.z - b.z};
}

Vetor3 multiplicar(const Vetor3& vetor, float fator) {
    return {vetor.x * fator, vetor.y * fator, vetor.z * fator};
}

Vetor3 produto_vetorial(const Vetor3& a, const Vetor3& b) {
    return {a.y * b.z - a.z * b.y,
            a.z * b.x - a.x * b.z,
            a.x * b.y - a.y * b.x};
}

float modulo(const Vetor3& vetor) {
    return std::sqrt(vetor.x * vetor.x + vetor.y * vetor.y +
                     vetor.z * vetor.z);
}

Vetor3 ajustar_modulo(const Vetor3& vetor, float modulo_desejado) {
    const float modulo_atual = modulo(vetor);
    if (modulo_atual < 0.000001f) return {};
    return multiplicar(vetor, modulo_desejado / modulo_atual);
}

float componente_eixo(const Vetor3& vetor, EixoAceleracaoVeiculo eixo) {
    switch (eixo) {
        case EixoAceleracaoVeiculo::X: return vetor.x;
        case EixoAceleracaoVeiculo::Y: return vetor.y;
        case EixoAceleracaoVeiculo::Z: return vetor.z;
    }
    return 0.0f;
}

SentidoAceleracaoLongitudinal classificar_sentido(
    float aceleracao_g, SentidoAceleracaoLongitudinal atual) {
    if (atual == SentidoAceleracaoLongitudinal::Frente) {
        if (aceleracao_g <= -parametros.limiar_entrada_sentido_g) {
            return SentidoAceleracaoLongitudinal::Tras;
        }
        return aceleracao_g < parametros.limiar_saida_sentido_g
                   ? SentidoAceleracaoLongitudinal::Neutro
                   : SentidoAceleracaoLongitudinal::Frente;
    }
    if (atual == SentidoAceleracaoLongitudinal::Tras) {
        if (aceleracao_g >= parametros.limiar_entrada_sentido_g) {
            return SentidoAceleracaoLongitudinal::Frente;
        }
        return aceleracao_g > -parametros.limiar_saida_sentido_g
                   ? SentidoAceleracaoLongitudinal::Neutro
                   : SentidoAceleracaoLongitudinal::Tras;
    }
    if (aceleracao_g >= parametros.limiar_entrada_sentido_g) {
        return SentidoAceleracaoLongitudinal::Frente;
    }
    if (aceleracao_g <= -parametros.limiar_entrada_sentido_g) {
        return SentidoAceleracaoLongitudinal::Tras;
    }
    return SentidoAceleracaoLongitudinal::Neutro;
}

float componente_eixo(const LeituraMpu6050& leitura,
                      EixoAceleracaoVeiculo eixo) {
    switch (eixo) {
        case EixoAceleracaoVeiculo::X: return leitura.aceleracao_x_g;
        case EixoAceleracaoVeiculo::Y: return leitura.aceleracao_y_g;
        case EixoAceleracaoVeiculo::Z: return leitura.aceleracao_z_g;
    }
    return 0.0f;
}

bool configuracao_valida(const ConfiguracaoServicoAceleracao& configuracao) {
    return static_cast<uint8_t>(configuracao.eixo_longitudinal) <=
               static_cast<uint8_t>(EixoAceleracaoVeiculo::Z) &&
           (configuracao.sinal_eixo_longitudinal == 1.0f ||
            configuracao.sinal_eixo_longitudinal == -1.0f) &&
           configuracao.frequencia_amostragem_hz >= 10 &&
           configuracao.frequencia_amostragem_hz <= 200 &&
           std::isfinite(configuracao.frequencia_corte_filtro_hz) &&
           configuracao.frequencia_corte_filtro_hz > 0.0f &&
           configuracao.frequencia_corte_filtro_hz <
               configuracao.frequencia_amostragem_hz / 2.0f &&
           configuracao.amostras_calibracao > 0 &&
           std::isfinite(configuracao.limite_giroscopio_calibracao_graus_s) &&
           configuracao.limite_giroscopio_calibracao_graus_s > 0.0f &&
           configuracao.gravidade_minima_calibracao_g > 0.0f &&
           configuracao.gravidade_maxima_calibracao_g >
               configuracao.gravidade_minima_calibracao_g &&
           std::isfinite(configuracao.gravidade_maxima_eixo_longitudinal_g) &&
           configuracao.gravidade_maxima_eixo_longitudinal_g > 0.0f &&
           configuracao.gravidade_maxima_eixo_longitudinal_g < 1.0f &&
           std::isfinite(configuracao.frequencia_correcao_gravidade_hz) &&
           configuracao.frequencia_correcao_gravidade_hz > 0.0f &&
           configuracao.frequencia_correcao_gravidade_hz <
               configuracao.frequencia_amostragem_hz / 2.0f &&
           std::isfinite(
               configuracao.limite_aceleracao_correcao_gravidade_g) &&
           configuracao.limite_aceleracao_correcao_gravidade_g > 0.0f &&
           configuracao.limite_aceleracao_correcao_gravidade_g < 0.5f &&
           std::isfinite(configuracao.limiar_entrada_sentido_g) &&
           std::isfinite(configuracao.limiar_saida_sentido_g) &&
           configuracao.limiar_entrada_sentido_g > 0.0f &&
           configuracao.limiar_entrada_sentido_g < 1.0f &&
           configuracao.limiar_saida_sentido_g > 0.0f &&
           configuracao.limiar_saida_sentido_g <
               configuracao.limiar_entrada_sentido_g &&
           configuracao.tempo_confirmacao_sentido_ms > 0 &&
           configuracao.tempo_confirmacao_sentido_ms <= 1000;
}

bool veiculo_aparentemente_parado(const LeituraMpu6050& leitura) {
    const float modulo_aceleracao = std::sqrt(
        leitura.aceleracao_x_g * leitura.aceleracao_x_g +
        leitura.aceleracao_y_g * leitura.aceleracao_y_g +
        leitura.aceleracao_z_g * leitura.aceleracao_z_g);
    const float maior_giro = std::max(
        std::fabs(leitura.giroscopio_x_graus_s),
        std::max(std::fabs(leitura.giroscopio_y_graus_s),
                 std::fabs(leitura.giroscopio_z_graus_s)));
    return modulo_aceleracao >= parametros.gravidade_minima_calibracao_g &&
           modulo_aceleracao <= parametros.gravidade_maxima_calibracao_g &&
           maior_giro <= parametros.limite_giroscopio_calibracao_graus_s;
}
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
