thegm-Gabriel/instrumentacao-ElectricCarUFSM/(commit log)

2026-09-26 Implementa OTA do mestre
    [particoes_ota.csv]
2026-09-28 Diversas melhorias e correções de erros
    [particoes_ota.csv]
2026-09-29 Melhorias gerais, correção de bugs e novas funcionalidades
    [configuracao.h, painel_mestre_web.h, receptor_uart.c, rede_wifi.c, servidor_web.c]
2026-09-29 Melhoria de terminal mestre e correção de bugs
    [particoes_ota.csv]
2026-10-02 feat(equipe): moderniza painel web de telemetria
    Reorganiza os indicadores, adiciona layout responsivo, melhora a visualização dos sensores e separa as métricas técnicas do enlace.
2026-10-11 Melhorias de Robustez de Código
2026-10-17 Melhorias de gerenciamento de memória
2026-10-31 Melhorias gerais de organização e correção de bugs
2026-10-31 Melhorias de pagina web
2026-11-07 feat(web): aprimora painel da equipe e adiciona prévia local para PC e celular
2026-11-08 Melhoria de documentação
2026-11-09 Melhorias de documentação
2026-11-12 Novas funcionalidades e correção de bugs
